Dfinitski/N7DDC-ATU-100-mini-and-extended-boards/3D_Print_Housing/5x5 case ATU-100 for N7DDC.stl

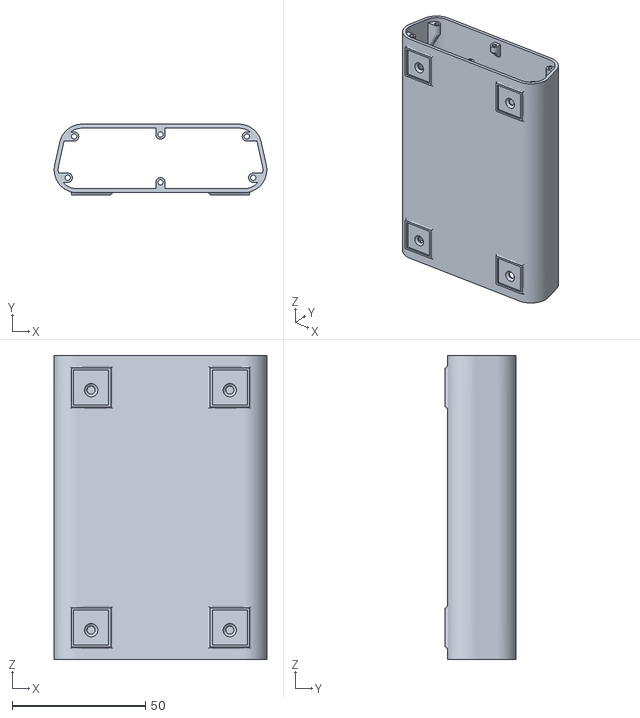
[picture p1: CAD file, 2019-02-02]
3D_Print_Housing/5x5 case ATU-100 for N7DDC.stl
79.7 x 26.5 x 114.0
