Dfinitski/N7DDC-ATU-100-mini-and-extended-boards/3D_Print_Housing/Front panel ATU-100.stl

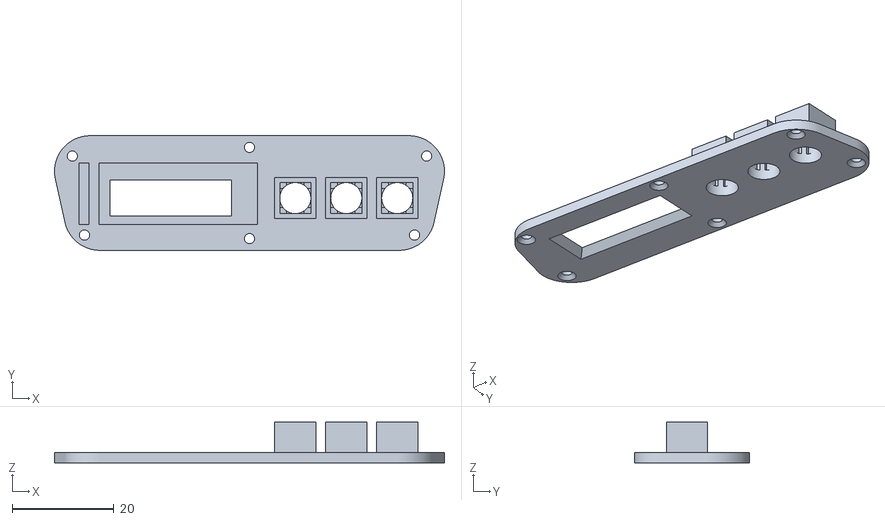
[picture p4: CAD file, 2019-02-02]
3D_Print_Housing/Front panel ATU-100.stl
76.5 x 22.5 x 8.00
