Dfinitski/N7DDC-ATU-100-mini-and-extended-boards/(threads)

Thread 1 (2019-02-18):

Source Code

geekbozu, 2019-02-18:
I see you have a permissive license on the hardware as noted in the documentation, with that I was wondering if the PIC source code be available for this eventually?

Dfinitski, 2019-02-18:
may be in future

Dfinitski, 2019-05-10:
Sources are available now

RichNeese, 2020-02-07:
DO you have a schematic for this board we want to use it on our custom addin board for ubitx . we are looking at the 5x5 as a addin for low power. but we want to put it n a board that mounts under our ubitx pcb

geekbozu, 2020-02-07:
This still has no license applied to it,
Are you intending on releasing these assets under a an OSH/OSS license? Or leaving them licensed to you?

RichNeese, 2020-02-07:
well we  planned on having your call and my call on the board . statung
the atu is based on your board.

------ Original Message ------
From: "Tim Keller" <notifications@github.com>
To: "Dfinitski/N7DDC-ATU-100-mini-and-extended-boards"
<N7DDC-ATU-100-mini-and-extended-boards@noreply.github.com>
Cc: "Richard Neese" <r.neese@gmail.com>; "Comment"
<comment@noreply.github.com>
Sent: 2/7/2020 12:16:33 PM
Subject: Re: [Dfinitski/N7DDC-ATU-100-mini-and-extended-boards] Source
Code (#1)

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

geekbozu, 2020-02-07:
I was askinng dfinitski, We have wanted to make a kit of this for a while but its just not setup in a way where we can legally do so yet. Attribution or not :/

MOUSE1025, 2020-02-07:
Dave,
Do you share the ATU IP with someone?
Christopher

MOUSE1025, 2020-02-07:
Dave,
Do share the ATU intellectual property with someone?
Christopher

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

RichNeese, 2020-02-07:
someone is selling kits from russian based on your board.
https://www.ebay.com/itm/Automatic-Antenna-Tuner-7x7-DIY-KIT-ATU-100-by-N7DDC-PIC-16F1938-flashed/193171458870

------ Original Message ------
From: "Richard Neese" <r.neese@gmail.com>
To: "Dfinitski/N7DDC-ATU-100-mini-and-extended-boards"
<reply@reply.github.com>
Sent: 2/7/2020 1:43:32 PM
Subject: Re[2]: [Dfinitski/N7DDC-ATU-100-mini-and-extended-boards]
Source Code (#1)

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

RichNeese, 2020-02-07:
also just selling boards well over priced ad I know that boards would be
only 1$  a board at pcbway .

https://www.ebay.com/itm/Automatic-Antenna-Tuner-7x7-PCB-ATU-100-mini-by-N7DDC/202706862349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

------ Original Message ------
From: "Richard Neese" <r.neese@gmail.com>
To: "Dfinitski/N7DDC-ATU-100-mini-and-extended-boards"
<reply@reply.github.com>
Sent: 2/7/2020 1:43:32 PM
Subject: Re[2]: [Dfinitski/N7DDC-ATU-100-mini-and-extended-boards]
Source Code (#1)

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

Dfinitski, 2020-02-08:
Hello, people.
This my design like other presented here, go with no any license. It is meaning, that all that info, files, pictures and source code are not protected. Excluding things that I am not the author of and some parts of code, where you can see some license description on the top. That is GNU license requirement - what I have took under GNU, I give under GNU.
So you can do what do you want with this design and I am very surprized that fact you did not read the Uer Manual for this device. The first sentences you can see is highlighted in red  :
**Attention ! There are no restrictions and prohibitions on the use of this material for any purpose, as well as all related materials, the author of which is N7DDC.**

MOUSE1025, 2020-02-08:
Dave,
Thank you for the clarification. I understood the original disclaimer in
the manual, but became confused, with the recent inquiries regarding the
Intellectual Property? I truly appreciate your kind, and generous gesture
regarding the the use of your creation(s).
Kind regards,
Christopher

On Fri, Feb 7, 2020 at 8:26 PM David Fainitski <notifications@github.com>
wrote:

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

Dfinitski, 2020-02-08:
Hello, Chris.
The Intellectual Property is staying mine anyway. It is mining that everyone who use this design or some part of them should to indicate everywhere my name or callsing as the Autor, autor of idea, designer, etc.
If someone decides to appropriate authorship, he will experience social censure.

MOUSE1025, 2020-02-08:
Dave,
That's a wonderful idea, I understand your goal and hope that you get the
credit that you deserve.
Kind regards,
Christopher

On Sat, Feb 8, 2020 at 10:05 AM David Fainitski <notifications@github.com>
wrote:

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

Closed 2020-06-01.

Thread 2 (2019-06-03):

ATU 100 for QRP

S54AM, 2019-06-03:
I have ATU100 extended SMD and works fine. What I miss is setup for QRP needs. Sensitivity for working from 1W to max. 20W. Setup min. power in firmware bellow 05 cause unexpected results as is already described in manual. Is there solution adding extra windings on PWR/SWR core or something else?
Additionally I have issue using OLED 091 because it is not turn on always when I turn power up. In my case every tenth time shows up. I have no experiences using other suggested displays.
Thanks in advance.

73, Marko, S54AM

Dfinitski, 2019-06-04:
Hello.
What exact the unespected result you watch ?

I am using 0.91 OLED with 78 address and 03 type and it works perfectly. I
never heard about this problem before.

David.

S54AM, 2019-06-04:
Hello David,

OLED is blind, nothing on it. After several power ups it works normally. I
have to mention that this is strange for me too. I will send short video
tomorrow.
My addresses are the same 78 and 03 and I have two OLEDs and on both the
same indications.

Marko

V V tor., 4. jun. 2019 ob 02:06 je oseba David Fainitski <
notifications@github.com> napisala:

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

Dfinitski, 2019-06-04:
Hello, Marco

I could not help you with this, sorry.

You should to find a mistake by yourself.

Good idea to try watch what happened with digital oscilloscope on lines CLK
and DAT after start the power.

But i will try ask other user on russian forum about this.

David.

пн, 3 июн. 2019 г. в 17:21, S54AM <notifications@github.com>:

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

Dfinitski, 2019-06-04:
Could you send to me in USA one of this OLEDs ?
Is this not to expensive ?

пн, 3 июн. 2019 г. в 17:21, S54AM <notifications@github.com>:

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

MOUSE1025, 2019-06-04:
Dave,
I enjoyed your exchange with Marco.
CPR

On Mon, Jun 3, 2019 at 5:42 PM David Fainitski <notifications@github.com>
wrote:

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

S54AM, 2019-06-04:
Problem with OLEDs is solved. Google knows everything. Two resistors on OLED 0.91 (R3 and R4) were factory swapped (somewere on far east). I swapped resistors ... and Bingo!
Anyway, important information for those with similar problems as I had. Thanks David for your effort.
More details on: [https://www.youtube.com/watch?v=__3InV5tdzM](url)

Could I ask about my first question?

Marko

Dfinitski, 2019-06-05:
Hllo, Marko
R3, R4, R9 have the same value 4k7.  R1 = 56k.

Concerning your first question, please explain with more details what exact
problem you watch.

вт, 4 июн. 2019 г. в 15:06, S54AM <notifications@github.com>:

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

S54AM, 2019-06-05:
Sorry for confusion. I should be more detailed, because there is dozens of different OLEDs 0.91 with different element numbering on back side. On mine, looking on back side, left is located U2 (3v3 reg), then first row in order C9, D1, R2 and R4. Second row C1, C2, C3, C4, R3, C5, C6 and C7. I swapped R4 and R3 and it works. I can send photo of mine. On QRZ.COM is my address, in reply I can attach photo.

My question is about ATU 100 use for QRP activities. Currently minimal operational power is 5W. What is needed to do to drop minimal synchronisation power to 1W?

Dfinitski, 2019-06-05:
Hello, Marko
If your transmitter has a power around 10 - 20 W you can use all this power
for tuning process.
If 5 W or less, set up in cell 0x05 value 01 - that's meaning that minimum
power for start the process will be from 1 W.
But be sure that the simple output power at least by twice more then
indicated in that cell.
It because in the tune process the output power could be dropped and
process could stop.
Protection system of your tranceiver also could drop the output power when
SWR more then 3.

David

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

S54AM, 2019-06-06:
Thanks David,

As you know, QRP is up to 5W CW and 10W SSB. My RIG is mcHF M0NKA and couple of others small boxes. I am home brewer and my joy is producing this thing into my small lab for my joy. I am amazed with your ATU and your preparedness sharing your intellectual work for free to our HAM community. All respects to you.
I also noticed your ATU project with internal battery and latching relays. This is my big future interest.
Yes, everything is clear for me about settings (1W). But, I am just thinking to get more voltage with more secondary  wingdings on PWR/SWR core for small power transmitters. For sure firmware changes are needed in this case to get real data on display. My suggestion is, If this is not too complicated for you, that QRP version of your ATU using latch relays could rise interest in QRP community. I will follow your smart products.
Sorry for delayed answer. The biggest challenge for me is free time especially at summer.
Again, compliments and all respects.

Marko

MOUSE1025, 2019-06-06:
Dave,
Where are you purchasing the 2512 50 ohm resistor? I have tried Mouser and
Digikey, no luck. I thought I would see where you are getting yours before
I ventured out to Newark and the others?
CPR

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

S54AM, 2019-06-06:
Mouse1025,
Nearest standardised EIA value for resistors is 49.9 ohm (E96). I am using two 100 ohm in paralel to reach exactly 50 ohm.

Marko

Dfinitski, 2019-06-07:
Yes, 50 Ohm exactly does not exist or very expensive. Use 49.9 as is. Don't
need to add anything.

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

MOUSE1025, 2019-06-07:
Dave,
I found one:
CPR[image: image.png]

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

MOUSE1025, 2019-06-07:
What am I going to need if I want to program my ATU? I assume that the
processor can be programmed right on the ATU board. What hardware will I
need to interface between my computer and the ATU. Will I need an IDE
program and compiler?
CPR

On Thu, Jun 6, 2019 at 5:50 PM Christopher Ryan <
tactical.radio.gear@gmail.com> wrote:

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

Dfinitski, 2019-06-07:
For programm MCU you will need two things:
!)
https://www.ebay.com/itm/PICKit3-Microchip-Programmer-w-USB-cable-wires-Pic-Kit-3/331941067077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

2) https://drive.google.com/open?id=12m2qaR-5bgMg4IJChc4-YXJ7Y6bKInuW

чт, 6 июн. 2019 г. в 20:05, MOUSE1025 <notifications@github.com>:

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

MOUSE1025, 2019-06-07:
Dave,
I am winding up the inductors, in advance of the PCB showing up tomorrow.
The T1/T2 calls out a 1:10 ratio, but gives no turns for the wire?
CPR

On Thu, Jun 6, 2019 at 8:05 PM Christopher Ryan <
tactical.radio.gear@gmail.com> wrote:

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
>>> Mouse1025,
>>> Nearest standardised EIA value for resistors is 49.9 ohm (E96). I am
>>> using two 100 ohm in paralel to reach exactly 50 ohm.
>>>
>>> Marko
>>>
>>> —
>>> You are receiving this because you commented.
>>> Reply to this email directly, view it on GitHub
>>> <https://github.com/Dfinitski/N7DDC-ATU-100-mini-and-extended-boards/issues/2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>,
>>> or mute the thread
>>> <https://github.com/notifications/unsubscribe-auth/ALPPXBZ54D2OUBPUGQ6HABLPZGNZXANCNFSM4HSUIQ6A>
>>> .
>>>
>>

MOUSE1025, 2019-06-07:
Dave,
Thanks for the info on the programmer. I have one on order. I should of
asked about this sooner.
CPR

On Thu, Jun 6, 2019 at 8:11 PM Christopher Ryan <
tactical.radio.gear@gmail.com> wrote:

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
>>> Dave,
>>> I found one:
>>> CPR[image: image.png]
>>>
>>> On Thu, Jun 6, 2019 at 4:39 PM S54AM <notifications@github.com> wrote:
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

Dfinitski, 2019-06-07:
It is 10 turns, 1 to 10, right

чт, 6 июн. 2019 г. в 20:12, MOUSE1025 <notifications@github.com>:

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

MOUSE1025, 2019-06-07:
Dave,
I thought that was the case, I wanted to make sure that I was not mistaken.
Thanks...
CPR

On Thu, Jun 6, 2019 at 9:01 PM David Fainitski <notifications@github.com>
wrote:

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

Dfinitski, 2019-06-08:
Hello, Marko.
Expectually for you - fw version 3.0 where you can to indicate any turn ratio of tandem match.
You can use 1 to 5 ratio to increase voltage on the diodes.
But be noticed that in this case 1/5 of power your TRX will be dissipated on the tandem-match 50 Ohm resistors.

Dfinitski, 2019-06-09:
Hello, Marko.
Sorry for this mistake. Only 0.2 W will be dessipated on 5 W, not 1/5.

S54AM, 2019-06-10:
Hello David,

Thanks for new firmware and suggestion about T1(1:5) for QRP. I will do
this in next days.
You can expect my reply.

Marko

V ned., 9. jun. 2019 17:00 je oseba David Fainitski <
notifications@github.com> napisala:

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

S54AM, 2019-06-10:
Hello David,

Your V.3 firmware is working well from 1W using settings bellow and modified T1 (1:5).

00 | 78 | 03 | 01 | 15 | 13 | 01 | 00 | 01 | 02 | 00 | 07 | 00 | 07 | 00 | 01 | 00
10 | 00 | 50 | 01 | 00 | 02 | 20 | 04 | 50 | 10 | 00 | 22 | 00 | 44 | 00 | FF | FF
20 | 00 | 10 | 00 | 22 | 00 | 47 | 01 | 00 | 02 | 20 | 04 | 70 | 10 | 00 | FF | FF
30 | 00 | 05 | 00 | 01 | 12 | FF | FF | FF | FF | FF | FF | FF | FF | FF | FF | FF

After several tests I have noticed that, if cell 06 is set to 04 (upper power limit for 40W) instead of default 00, then OLED after SWR sometimes become frozen with word TUNE, not showing SWR numerical value. If I leave it as default, then ATU works normally. Maybe I set something wrong.

Marko

Dfinitski, 2019-06-11:
Hello, Marko

Probably manua is not clear enough. When you have set 04, upper power limit
will be 4W in simple mode and 40 W in High Power Messurement mode (cell 30).

ATU is not freesing, it is waiting for when your power will
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

Thread 4 (2019-12-24):

Programming with Pickit2

victorkoren, 2019-12-24:
I am trying to program the ATU-100 with Pickit-2 but it shows "no device detected".
I set the device manually and it detects that the device has external Vdd, but does not detect the PIC.
Is there a problem using Pickit-2?
Victor - 4Z4ME

Dfinitski, 2019-12-24:
Hello, Victor.
As I know, Pickit 2 does not support PIC16F1938. You have to swap .dll file from Pickit 3 programm or change your programmer to Pickkit 3. After that you should select manually Device Family -> Midrange -> 1.8V min
Because this family uses other Vpp voltage then others.

victorkoren, 2019-12-24:
Hi,
Thanks for the prompt answer, however that is strange because in the Pickit 2 app I can choose the PIC 16F1938 manually, so the option to choose it is there but it is not supported?
Victor - 4Z4ME

Dfinitski, 2019-12-24:
I am sorry, 1938 is supported, proof
http://ww1.microchip.com/downloads/en/devicedoc/pickit%202%20readme%20v2-61-00%20(a).txt
Please give more info what is happening when you are trying to programm it.

victorkoren, 2019-12-24:
I found a readme DOC from microchip that states that 16F1938 is supported:
http://ww1.microchip.com/downloads/en/devicedoc/pickit%202%20readme%20v2-61-00%20(a).txt
So why doesn't it work?
I saw that other people had this problem.
Victor - 4Z4ME

victorkoren, 2019-12-24:
We posted together the same file...
Anyway I saw that also other people had this problem and didn't solve it.
Tomorrow I will post a screen picture.
Victor = 4Z4ME

victorkoren, 2019-12-24:
It seems that there is a newer DAT file that updates the devices that PICKIT 2 supports. I'll check that tomorrow.

Dfinitski, 2019-12-24:
Looks like that. Let's go !

victorkoren, 2019-12-24:
I updated the data file and it worked !
Just wanted to configure the ATU to work in automatic state.
Thanks for help.
Victor - 4Z4ME

Dumper88, 2020-11-29:
Hi is it possible to have a link to download PK2DeviceFile the most updated? thanks

Dfinitski, 2020-12-01:
Hi. You can find it here https://drive.google.com/file/d/18wiH5RjL5R8ku7a9MQ4Hxx9SmUZInpvj/view?usp=sharing

Closed 2019-12-24.

Thread 5 (2020-04-24):

T1/T2

IAceVenturaIcz, 2020-04-24:
Hello,

may I know how many turns are on T1/T2 please ?
Thank you

2M0LWS, 2020-04-25:
I have done 5 turns on each side. Suitable for 5w minimum power.

Dfinitski, 2020-04-25:
*T1, T2 - TANDEM MATCH, BN43-202 AMIDON CORE* *1:10*
In latest firmware for extended board this ratio might be what you want,
from 5 to 30 typically dependet to desired maximum power.
The limiting criterion is the maximum voltage on analog inputs PIC.
For 1939 it can not to excide 4.096  Volts, for 2520 5Volt with maximum
input power.
For standart 100W it is 1/10 Turns, for QRP below 50W 1/5 Turns preferred.
Voltage on ADC = SQR(2) * Vrf_in / Ratio / 3

пт, 24 апр. 2020 г. в 01:59, IAceVenturaIcz <notifications@github.com>:

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

IAceVenturaIcz, 2020-04-27:
thank you all for replay. Not sure about how that works. I need 1/10 as been mention, as I will use 100W . What I am nor sure how to wired this toroid. I bit confused as I need to get 4 wires out. Is there any picture how to do it please ?

Dfinitski, 2020-04-27:
The picture on the schematic. Try "tandem match" in the Google Search for
more info.

On Mon, Apr 27, 2020, 5:05 AM IAceVenturaIcz <notifications@github.com>
wrote:

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

IAceVenturaIcz, 2020-04-27:
Thank you David, sorted for now...

Closed 2020-04-27.

Thread 6 (2020-04-25):

Capacitor Values for B1 B2

2M0LWS, 2020-04-25:
What are the values of the two smaller capacitors connected to the 0.1u capacitors in the attached image?

Any advice is greatly appreciated.

73s 2M0LWS

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

Dfinitski, 2020-04-25:
Hi
Those are 2 blocking 0.1uF capacitors for additional buttons.

сб, 25 апр. 2020 г. в 11:46, 2M0LWS <notifications@github.com>:

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

2M0LWS, 2020-04-25:
Many thanks for the quick reply. 73's, 2M0LWS

Closed 2020-04-25.

Thread 7 (2020-06-01):

Automatic Antenna Tuner 7x7 (ATU-100 by N7DDC) Query

k2db, 2020-06-01:
I am a newbie here, looks like fun ,I love kit building, doing it since early 60's,
I just ordered FULL KIT DIY Automatic Antenna Tuner 7x7 (ATU-100 by N7DDC), what files do i need to construct the kit, do i need anything extra like a display, etc, and where do i go to get the info?
Paul K2DB

Dfinitski, 2020-06-01:
Hello, Paul.
This project is fully opened so you can find all the files here on GitHub.
I recommend you to read User Manual firstly.
The schematic would be helpful also.
If you do assembly with no errors, this device will work immediately with
any questions .

David, N7DDC

пн, 1 июн. 2020 г. в 06:28, Paul Mackanos <notifications@github.com>:

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

k2db, 2020-06-01:
thank you, what files do i download ?

Dfinitski, 2020-06-01:
Hi, Paul. Everything you need you can find here
 https://github.com/Dfinitski/N7DDC-ATU-100-mini-and-extended-boards/tree/master/ATU_100_EXT_board

k2db, 2020-06-16:
David, I don't have Microsoft Word, so I can't open the instructions. Is
there any way I can ask you to send me all the info in PDF format?
Building instructions, operation manual, etc.
Still waiting for the kit to be delivered, thought I might get a jump on
what is coming for me, and anything I will need that is extra.
Thanks,
Paul K2DB

On Mon, Jun 1, 2020 at 5:53 PM David Fainitski <notifications@github.com>
wrote:

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

Dfinitski, 2020-06-16:
Hello, Paul.
The manual in pdf is present here. Did you try the link in my previous message ?
Everything you need you can find on the schematic and BOM list.
To open odt files use a free software like Open Office.

Celta1960, 2021-02-18:
Hola amigos, tengo un problema con el atu-100 ver 3.0 el cual funcionar funciona perfectamente pero una en ciertas frecuencias es imposible ponerlo ya que me marca una señal fuerte hasta el punto de no poderlo utilizar, esto ocurre en todas las bandas.
       Adjunto dos fotos con el puesto y quitado, A que es debido?.
   Un saludo
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

Dfinitski, 2021-02-18:
Hello, Celta1960

**New in the version 3.2
Fixed bug with continuous data transfer to the display.**

So use 3.2 version of firmware.

To check this out, disconnect the display and try without it.

Dfinitski, 2022-08-08:
Hi.
The most likely it uses complicated data exchange via CAT

Dfinitski, 2022-08-08:
But you can try to find native Start and Key signals on your rig.

Plasmastorm73, 2022-08-14:
Are there any step by step build instructions for this kit?

Dfinitski, 2022-08-15:
Hi.
Yes.
1) install all components to the board
2) power on it
3) use it

Plasmastorm73, 2022-08-15:
You know. People like you are causing beginners to give up with your
rudeness. You could have simply said you were too lazy to make a step by
step guide but instead you have to be a jerk.

On Sun, Aug 14, 2022 at 8:00 PM David Fainitski ***@***.***>
wrote:

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

paul-jewell, 2022-08-15:
> You know. People like you are causing beginners to give up with your rudeness. You could have simply said you were too lazy to make a step by step guide but instead you have to be a jerk.

David has put an inordinate amount of time and effort to make his designs effective and available. As far as I am aware, he doesn't make any money out of the sale of the different kits available from Aliexpress, Banggood, eBay etc, and no doubt has to devote a significant amount of his personal time and effort to supporting people who ask him questions which could already be answered with a bit of googling. He doesn't owe anyone anything - we all have a debt of gratitude to him.

It is a straight forward assembly, and within the skills of anyone familiar with building kits. The tuners are also available fully built for those who don't wish to wield a soldering iron.

I don't think David was being rude - he was simply being to the point. If you don't have the confidence to build a kit, then buy a complete item - they are still amazing value compared with the competition.

nanko55, 2022-08-15:
Agree.

I’ve build at least three of them, without problems, they all work very well!
For the beginners: take a look at github, Google, AliExpress for tips and schematics, thats how real radio amateurs do it 😉
If you don’t like or want to do this, purchase an ATU from ICOM or MFG.
I think David did an outstanding job👍

Regards, Nanko van Dijk, PA0NVY

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

Plasmastorm73, 2022-08-15:
Dear Paul. This wasn't for me. I asked a simple question and he was snotty
about the answer. PERIOD! A simple no there isn't would have been straight
forward. I was looking into this kit for a 12 year old kid I am teaching.
Maybe you should mind your own business and leave the conversation to the
adults. I've been building Oscilloscopes for a MAJOR brand for over 30
years and also teach soldering and electronics building classes. Some
people who just assume the facts like you are the real problem.

On Mon, Aug 15, 2022 at 3:46 AM Paul Jewell ***@***.***>
wrote:

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

paul-jewell, 2022-08-15:
Hi William,

I understand it wasn't for you - I could see from your QRZ page that you
have many years of electronics experience and don't need instructions.

In my opinion, Dave was succinct and to the point. What else could he
have said?

If you look at the other comments above yours, you will see that even
when he takes to respond, people don't always pay attention to what he
says. /Comments like yours/ will ultimately drive creative people like
Dave away - he doesn't have to share anything, or do anything for anyone
else. *He owes us nothing, and we should be eternally grateful for his
generosity!*

I have seen a number of people who make the product of their hard work
available for free to others, and then get lambasted for it. In some
cases, this has led to them withdrawing their information and support,
to the detriment of the community.

If you think there should be instructions, then create some and make a
pull request so they can be added to the github repository. Dave doesn't
need instructions for himself, so why should he write any?

I have nothing more to say about this, as I doubt I can change your
views, and it's not constructive.

Best regards,
Paul

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

Plasmastorm73, 2022-08-15:
You completely miss my point. I don't give a damn if there are or aren't
any instructions. MY point was the asshole way he said no there weren't
any. "Dave was succinct and to the point" was total bullshit. He was being
a snarky asshole instead of just saying no there aren't any. I neither
found it amusing nor helpful.

Anyway. You are correct that you won't change my mind on this. I didn't get
my panties in a twist over there being no instructions like you are
implying. I got angry at his attitude and asshole reply.

On Mon, Aug 15, 2022 at 8:24 AM Paul Jewell ***@***.***>
wrote:

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

MOUSE1025, 2022-08-15:
No good deed goes unpunished!
Great work Dave.
Kind regards,
Christopher

On Mon, Aug 15, 2022 at 6:22 AM Plasmastorm73 ***@***.***>
wrote:

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

davidhay45, 2022-08-15:
@Plasmastorm73 you have demonstrated to all reading this thread that YOU are the jerk around here.  David N7DDC has done a wonderful job in designing these ATU's and release all of the information to the world at large and does not deserve criticism from pathetic idiots like you.

Dfinitski, 2022-08-15:
That's a good lesson for me. Stupid questions SHOULD be ignored.

Plasmastorm73, 2022-10-11:
I have no issue with the kit, nor the amount of time he put into it. I have
issue with people giving snotty answers when it isn't called for. PERIOD!

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

Thread 8 (2020-06-09):

Tandem match T1   T2

morseoneuk, 2020-06-09:
Is wire gauge critical?  10:1   ok,   but what wire diameter?

Dfinitski, 2020-06-09:
AWG 32 in PTFE silver core works perfect.

вт, 9 июн. 2020 г. в 00:56, morseoneuk <notifications@github.com>:

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

morseoneuk, 2020-06-09:
Hi David, many thanks for the info..  that is  just what I needed to know.best regards   Scotty
    On Tuesday, 9 June 2020, 18:46:56 BST, David Fainitski <notifications@github.com> wrote:

AWG 32 in PTFE silver core works perfect.

вт, 9 июн. 2020 г. в 00:56, morseoneuk <notifications@github.com>:

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

—
You are receiving this because you authored the thread.
Reply to this email directly, view it on GitHub, or unsubscribe.

fedemartini, 2020-07-15:
Sorry for the dumb question, but I wasn’t able to find anywhere the data on T1/T2. 1:10 ok, but how many turns?
Many thanks

Dfinitski, 2020-07-15:
Hello. Ask Google "tandem match" and you will find everything you need,  with pictures.
How many turns for 1:10 tandem ? 1 and 10 turns of course.

stefan75dc4, 2020-08-26:
Hello David,
i buyed the Tuner on ebay, but the 100 Watt - Version (7x7 Elements).
Can I make a 1000 W Tuner with this PCB or I need another PCB-Board.
How much Turns i need for the tandem match? 1:10 or a other worth?
Sorry for this question, but this is my first greater Kit for Amateurradio.
I must collect further experience.
Thanks in forward.
Vy 73 de DC4KJS (Stefan)

Dfinitski, 2020-08-27:
Hello, Stefan
You can find info about 1kw tuner here, use google translate . Boards are present on the Ebay. http://www.cqham.ru/forum/showthread.php?38456-ATU-N7DDC-%E2%E5%F0%F1%E8%FF-1Kw-%EE%F2-EU2AV

Dfinitski, 2020-09-14:
Stefan, 1kW tuner here
https://www.youtube.com/watch?v=RaizIevy-BI

stefan75dc4, 2020-09-14:
Hello David,

Thank You for the Link.

Vy 73 de and best wishes

Stefan Dc4kjs

Holen Sie sich Outlook für Android

Von: David Fainitski <notifications@github.com>Gesendet: Montag, 14. September 2020, 03:20An: Dfinitski/N7DDC-ATU-100-mini-and-extended-boardsCc: Stefan; CommentBetreff: Re: [Dfinitski/N7DDC-ATU-100-mini-and-extended-boards] Tandem match T1   T2 (#8)
Stefan, 1kW tuner here
https://www.youtube.com/watch?v=RaizIevy-BI

—You are receiving this because you commented.Reply to this email directly, view it on GitHub, or unsubscribe.

Thread 9 (2020-06-21):

Blown capacitor C27 or C26

MartinDavidWaller, 2020-06-21:
Hi,

I've recently built one of the kits and it's all been going well until today. I am driving it from a KX3 with 10w output and found that the tuning could hang if the power went below 5, possibly due to the KX3 reducing power out to protect itself. To resolve this I've change the EEPROM address 5 from 5 to 1 and it seemed to be much happier.

I was using it to tune an antenna on 24Mhz and was half way through a CW QSO when the fuse on my power supplt blew and the shack filled with 'an interetsing smell'! On investigation then only damage seems to be C27 or C26 that has blown. The ATU still works, I can enter test mode and cycle through the L and C values.

Any advice or replacing the cap would be appreciated, do I need a better rated cap?

Many thanks for any advice you can give.

Martin
G0PJO

Dfinitski, 2020-06-21:
Hello, Martin.
Thank you for sharing that.
Yeah, this is very wierd to see blown DC current capacitors (???!!!).
I don't see any other reason to do that except all of them were very low quality or were rated for low voltage, 5-6 Volts.
Just change them to 25-50 Volts rated .

MartinDavidWaller, 2020-06-22:
Hi David,

Many thanks for the reply. Yes, very odd, I'll order some and replace them. Many thanks for the help.

Martin

MartinDavidWaller, 2020-08-27:
Hi David,

Sorry for not getting back to you on this. I replaced the capacitor and it has worked like a dream ever since! Many thanks.

Martin

Closed 2020-08-27.

Thread 10 (2020-06-29):

Manual control

pa3hea, 2020-06-29:
Hello,
I build the tuner and it works reasonably well.
It happens on a regular base that he mis the lowest swr.
Is there a posibility to control the capacitors and the coils manualy to fine tune the swr.
Grts
Pa3hea

Dfinitski, 2020-06-30:
Hello.
You can use the manual mode , (Bypass + Auto + Power On), to find the best LC combination but there is no this future in working mode.
Try to encrease Relay delay time, it would be helpful.

pa3hea, 2020-06-30:
Tnx for your answer, can you tell me how to change that.
Do I need to reprogram the pic for that.

Tnx

Bart (pa3hea)

Dfinitski, 2020-07-01:
Yes, read the manual, cell's description.
But I have better idea. Add 1-3 meters of cable to your RF antenna fider  (after ATU)  and try again.

pa3hea, 2020-07-01:
Hello David,Tnx for your attention.I understand what you mean with that.Its not realy a big issue when make a mistake because it is simple to correct when it happens.I am very satisfied with it.It does his job verry well.Well done david my compliments.If you dont mind I want to write a little peace about in a technical digital magazine here in holland called "razzies" about my findings and building experience.Most of the radio amateurs of the local clubstation PI4RAZ write peaces about several kinds of projects they develop and build.Every month there is a edition that we spread all over the world in 2 languagesThe author of this magazine is Frank PA3CNO.Can you let me know if you find this a problem or not.TnxBart (PA3HEA)Verzonden vanaf mijn Samsung Galaxy-smartphone.<!-- originalMessage --><div>-------- Oorspronkelijk bericht --------</div><div>Van: David Fainitski <notifications@github.com> </div><div>Datum: 01-07-2020  22:15  (GMT+01:00) </div><div>Aan: Dfinitski/N7DDC-ATU-100-mini-and-extended-boards <N7DDC-ATU-100-mini-and-extended-boards@noreply.github.com> </div><div>Cc: pa3hea <bart@bwautomatisering.nl>, Author <author@noreply.github.com> </div><div>Onderwerp: Re: [Dfinitski/N7DDC-ATU-100-mini-and-extended-boards] Manual control (#10) </div>Yes, read the manual, cell's description.
But I have better idea. Add 1-3 meters of cable to your RF antenna fider  (after ATU)  and try again.

--
You are receiving this because you authored the thread.
Reply to this email directly or view it on GitHub:
https://github.com/Dfinitski/N7DDC-ATU-100-mini-and-extended-boards/issues/10#issuecomment-652624325

BW automatiseringWillem Dreeslaan 2452729 NE ZoetermeerT) +31 798 200 240F) +31 78 200 241info@bwautomatisering.nlwww.bwautomatisering.nl
Op al onze producten en diensten gelden onze algemene voorwaarden voor B2B en consument zoals vermeld op de website.

Dfinitski, 2020-07-01:
Hello, Bart.
There are no any problem to use this project information for any purpose.

pa3hea, 2020-07-01:
I have a stuppid brainfart, would it be  possible to convert the software for the pic controller to arduino and replace the pic by a arduino.Because arduino is verry populare ad the moment here.Dont understand me wrong its just a brainfart and I dont know how to do it.Just curious if this is possible.TnxBart (PA3HEA)Verzonden vanaf mijn Samsung Galaxy-smartphone.<!-- originalMessage --><div>-------- Oorspronkelijk bericht --------</div><div>Van: David Fainitski <notifications@github.com> </div><div>Datum: 01-07-2020  22:52  (GMT+01:00) </div><div>Aan: Dfinitski/N7DDC-ATU-100-mini-and-extended-boards <N7DDC-ATU-100-mini-and-extended-boards@noreply.github.com> </div><div>Cc: pa3hea <bart@bwautomatisering.nl>, Author <author@noreply.github.com> </div><div>Onderwerp: Re: [Dfinitski/N7DDC-ATU-100-mini-and-extended-boards] Manual control (#10) </div>Hello, Bart.
There are no any problem to use this project information for any purpose.

--
You are receiving this because you authored the thread.
Reply to this email directly or view it on GitHub:
https://github.com/Dfinitski/N7DDC-ATU-100-mini-and-extended-boards/issues/10#issuecomment-652640271

BW automatiseringWillem Dreeslaan 2452729 NE ZoetermeerT) +31 798 200 240F) +31 78 200 241info@bwautomatisering.nlwww.bwautomatisering.nl
Op al onze producten en diensten gelden onze algemene voorwaarden voor B2B en consument zoals vermeld op de website.

Dfinitski, 2020-07-01:
PIC controllers are very popular in the world and have low price. You should to be a crazy Arduino's fan to get hours brainstorm to convert the code. But I think it is not a big problem.

DIETMAR4, 2020-08-03:
Hello !
I built the ATU 100 7x7. It works very well. Now I have a question. If I want work with my power amplifier (1 kw PEP) I shurely have to switch off the ATU 100. But how can I do this without removing of the PL259 Plugs ? Thanks for your answer !
Dietmar4 (DK8TT)

Dfinitski, 2020-08-03:
Hello.
Use Bypass mode or power off the tuner board.

DIETMAR4, 2020-08-03:
Hello dear David,
thank you very much for your quick answer. May I ask back, if I switch off the power of the tuner, the power of the PA (1kW) really cannot destroy the tuner ?  Then I have a second question to Bypass: If I make a contact (switch) from RP1 to ground. Which function has this step ?
Thank you very much for your answer.
Vy 73
Dietmar (DK8TT)

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

pa3hea, 2020-08-03:
Maybe stupid question but why do you want to put 1kw through the small 100 watt tuner.Verzonden vanaf mijn Samsung Galaxy-smartphone.<!-- originalMessage --><div>-------- Oorspronkelijk bericht --------</div><div>Van: DIETMAR4 <notifications@github.com> </div><div>Datum: 03-08-2020  22:55  (GMT+01:00) </div><div>Aan: Dfinitski/N7DDC-ATU-100-mini-and-extended-boards <N7DDC-ATU-100-mini-and-extended-boards@noreply.github.com> </div><div>Cc: pa3hea <bart@bwautomatisering.nl>, Author <author@noreply.github.com> </div><div>Onderwerp: Re: [Dfinitski/N7DDC-ATU-100-mini-and-extended-boards] Manual control (#10) </div>Hello dear David,

thank you very much for your quick answer. May I ask back, if I switch off the power of the tuner, the power of the PA (1kW) really cannot destroy the tuner ?  Then I have a second question to Bypass: If I make a contact (switch) from RP1 to ground. Which function has this step ?

Thank you very much for your answer.

Vy 73

Dietmar (DK8TT)

Von: David Fainitski

Gesendet: Montag, 3. August 2020 22:14

An: Dfinitski/N7DDC-ATU-100-mini-and-extended-boards

Cc: DIETMAR4; Comment

Betreff: Re: [Dfinitski/N7DDC-ATU-100-mini-and-extended-boards] Manual control (#10)

Hello.

Use Bypass mode or power off the tuner board.

—

You are receiving this because you commented.

Reply to this email directly, view it on GitHub, or unsubscribe.

--

You are receiving this because you authored the thread.

Reply to this email directly or view it on GitHub:

https://github.com/Dfinitski/N7DDC-ATU-100-mini-and-extended-boards/issues/10#issuecomment-668236511

BW automatiseringWillem Dreeslaan 2452729 NE ZoetermeerT) +31 798 200 240F) +31 78 200 241info@bwautomatisering.nlwww.bwautomatisering.nl
Op al onze producten en diensten gelden onze algemene voorwaarden voor B2B en consument zoals vermeld op de website.

Dfinitski, 2020-08-03:
Hello.
No, you can not to put 1kW thought the tuner board.
The tuner board should be connected between your 100W rig and 1kW PA. An antenna is connected to PA output. When you don't use a PA, it is bypassed (usually, should be). When you use a PA - Bypass the tuner board.

Dfinitski, 2020-08-03:
There are two additional buttons - Auto and  Bypass.

DIETMAR4, 2020-08-04:
Dear David,
thank you very much for your precious answer. Now I changed the position of the tuner between the rig and the PA. - I don’t have the button Auto und Bypass. I only use the button Tune. Can you tell me please, how I can install the Buttons Auto and Bypass. Have I to connect a switch between point RB1 and ground and Point RB2 and Ground ? And what are the functions of these two buttons ? Thank you very much for your patience to my stupid questions.
Vy73
Dietmar (DK8TT)

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

Dfinitski, 2020-08-04:
Hello.
You can use a reset tuner instead Bypass. A Bypass mode allows you to return to LC settings anytime, unlike a reset.
Yes, just connect the additional buttons to ports and ground. Install 0.1uF caps over there also.
You can read about additional buttons in the user manual. You can see how to connect additional buttons on the schematic.

DIETMAR4, 2020-08-04:
Dear David,
thank you very much for explaining of the two buttons and its installing. Today I talked to an OM from southern Germany. He also wants to build your ATU-100.
Now I thank you very much for your kindness help. I wish you all best and much health !
Vy 73
Dietmar (DK8TT)

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

DIETMAR4, 2020-08-15:
Dear David,
I have another question. I see, that the swr-value of ATU-100 often is different from the value of my swr-meter. It is connected behind the atu-100. How can it be ?
Thank you very much for your answer.
Many 73
Dietmar

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

Dfinitski, 2020-08-15:
Hello, Dietmar
The lines in the tuner board have a parasitic inductance, relays -
parasitic capacitance, so nothing weird if you see different SWR values in
that heterogeneous transmission line.
Connect your SWR meter before the tuner as close as it's possible to see
more valuable values.

сб, 15 авг. 2020 г. в 05:31, DIETMAR4 <notifications@github.com>:

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

DIETMAR4, 2020-08-15:
Dear David,
thank you very much for your excellent advice. Now I changed the position of the SWR-Meter and can see, that the different SWR-values are much closer !
I wish you a beautiful Sunday tomorrow und much health.
My best 73 to you
Dietmar

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

Closed 2020-08-27.

Thread 11 (2020-07-22):

Under rated capacitors C7 1n, C6 470pf, C7 220pf

pa3hea, 2020-07-22:
Hello david,

I notished that c5 c6 and c7 are under rated.
On the lower bands like 80m band
They get verry hot in a view seconds when you use 100 watt. And the swr is moving when that happens.
I replaced them with high Q low ESR  500v types from johanson.
The capacitor kit P/N from Johansons is S111DUE.
This capacitors solve the problem.
The capacitors witch are included in the kit are most likely 50v capacitors i ques if I look to the size of the capacitors.
If everybody get this capacitors then you get a lot of complains I think.

Grts

PA3HEA

Dfinitski, 2020-07-23:
Hello.
ATC800 is the best solution in this case, but expensive.
If you use simple 1206 capacitors, choose them with 1kV and higher rating with white or rose ceramic. Don't use brown or grey ones.
C5, C6, C7  must be composed with lower values caps, not more then 220p, because bigger values used bad dielectric usually.
NP0 dielectric must be used in all C1 - C7 capacitors.

pa3hea, 2020-07-23:
I replaced them with the same type you advice 2828.
That works fine.
But you advice also not to use brown capacitors, all capacitors c1-c7 are brown in the kit and 1206 so i'm not sure if that is what you advice in this.

Grts

Bart (Pa3hea)

Dfinitski, 2020-07-23:
Hello.
I am designer of this project, I am not a seller of kits . All my
suggestion you can read in my previous post.
Please ask seller of your kit if you have some problems with that .

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

Closed 2020-08-27.

Thread 12 (2020-08-10):

Compile the project with a free IDE?

khkremer, 2020-08-10:
I don't have any experience with development for PIC processors, so please excuse my ignorance regarding development environments. I have successfully used the MPLAB X IPE to program the hex file into the chip, but now I'd like to play around with the source code. I tried to load the project into MPLAB X IDE, but it does not recognize the project folder as a valid project. That prompted me to poke around in the project configuration files, and it looks like you are using MicroC, which is a bit on the expensive side for just playing with one project. Do you have any suggestions for getting this to compile using a free system?

Thanks,
Karl Heinz - K5KHK

Dfinitski, 2020-08-10:
Hello, Karl
Of course you can create the new project in MPLAB IDE, copy all .c and .h files to it and try to compile.
You will need to change native MicroC libraries like ADC conversion, Types Conversion , EEPROM and probably something else, I don't remember.
I2C is not a library, it is software realization.
Use a free demo version of MicroC to obtain info about PIC configuration, library description, etc.

sparkey2450, 2020-11-28:
You guys are kind of throwing me here. You mentioned MicroC but I found MikroC. Is the second one correct? I like what I see with this tuner. What I'd like to do is set it up so I can access the parameters from the shack via WiFi with the tuner Mtd at the antenna. Been a while since I did any programming so this will be a big learning curve.

Dfinitski, 2020-12-01:
Hi, Steve.
Yes, you are right, MikroC is correct name.
It would be interesting to do something on ESP32 Arduino board.

rogerclarkmelbourne, 2020-12-01:
The EPS32 is a great device, but be aware that when the WiFi it enabled it takes loads of current. Hundreds of mA, like all Wifi devices do.

You'd also need to check the accuracy of the ADC on the ESP32. It may be OK, but it possibly may be worse than the PIC.

I'm also not sure how hardened the Wifi Rx is on the ESP32 and how well it would react to 100W passing by in close proximity, and conceivably it could actually damage the Rx.

sparkey2450, 2020-12-01:
Ok thanks for the info. You can email me direct if you look up my QRZ page for W8TTY I've got a few ideas. Been a little bit of a trip down memory lane for me. I haven't done any real programming since I retired back in 2004. My current project is a Mag Loop. Another subject. I have some ideas and for real quick I see two boards.  Your design mated to an Arduino or Raspberry Pi. Most likely going to take some case design and shielding. All the commercial Auto Tuners are designed to sit on a desk. The other ones that are at the antenna lack any kind of real interface. I have both compilers loaded and got sticker shock when I looked at the price of the optimizing compiler from MPLAB. The one you are using is reasonable for hobby use. The Free MPLAB Compiler when I loaded the project and ran it had lots of ????? Warning Warning Will Robinson. That is most likely Operator error. I got the other one to run just fine but since its a demo it will not build the executable because of size. Anyway this will be a fun project. Still getting this old Unix, Microsoft C Programmer back on his feet. Thanks for a great job on the design. I'm not one to re-invent wheels so the reason I was looking at the Raspberry PI is all that VNC and WIFI stuff is there and waiting to be used.  I have a ATU-100 box coming this Friday. Supposedly wired by you. Have a great day. As for powering this thing I'll be looking at Solar and batteries.  Nice job again on the design.

Dfinitski, 2020-12-01:
Steve, I don't want to do something else on this project. This tuner was created as a "black box" under antenna and I have add the display only for debugging data output. but people asked me add something else more and more, so as result you can see what we have. On my personal opinion, this tuner should be "blind", next to antenna in full automatic mode.
All the info what I need I can see on my transciever's display.
It would be interesting for me how far the human mind can go in perfecting a simple thing.

sparkey2450, 2020-12-01:
> Steve, I don't want to do something else on this project. This tuner was created as a "black box" under antenna and I have add the display only for debugging data output. but people asked me add something else more and more, so as result you can see what we have. On my personal opinion, this tuner should be "blind", next to antenna in full automatic mode.
> All the info what I need I can see on my transciever's display.
> It would be interesting for me how far the human mind can go in perfecting a simple thing.

Ok, Thanks for a great piece of equipment. I appreciate the work you have done. It is very well designed. I take a little different approach. I like to know exactly what going on at the end of the coax. Thanks again for all your hard work.

Steve W8TTY

sparkey2450, 2020-12-04:
David,  are you willing to answer a few questions about the code as I read through it? If not then that's fine. I'm like anyone else. I can get lazy and look for the shortest path. So far so good on the code. I'm looking at Firmware 3.1. Unless you suggest one of the others. Thanks
Steve

Dfinitski, 2020-12-04:
Hi Steve.
I am open  for questions.

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

sparkey2450, 2020-12-04:
Thanks David. I got the box today and tried it out from the shack worked well. It only has the Tune Button. It tunes quickly. Yes, I've already had the top off. Version 3.0 Firmware is installed. I was assuming I could add the Auto Button to the front but not sure on the board where that connects at this point. But I noticed the OLED and Program header being used on the board is bent over and wires are soldered directly to the header. That was a surprise. I'll figure out how to get the PICkit3 connected. I want to put it in "Auto" Then put it out at the antenna. I only have one software question at his point. There are some Forever While Loops "while(1) { bla bla bla }; in the code that appears to be part of the testing stuff. I did not see anything obvious to me on a break out of the loop.  Is that just for the testing and once entered the only way out is power down or reset? Or am I missing something?

I have looked at the MPLAB Compiler and I think I will stick with mikroC.

I won't bother you any more this December. I'm sure you got things going on and so do I . I've got the Mag Loop stuff I have not finished. Then in Jan. I'll get back to this . My goal is to have this at the antenna and have it take care of matching automatically.  Whether I ever get to the point where I can see the data in the shack is another project. I appreciate your help.

Thanks,
Steve W8TTY

Dfinitski, 2020-12-04:
Hi, Steve.
Those are infinite loops for Fast test mode, manual mode and fider loss
setting mode. (In the 3.1 firmware).

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

sparkey2450, 2021-01-20:
David,
Happy new year hope all is well for you. I saw something in sharp_cap(). Int mem_swr; but down in the code its mem_SWR; Am I missing something? I've been porting this to the MpLab Compiler XC8. Got it to compile today. Have not tested it. I stripped out the things I do not need. If you want a copy send an email directly to my email address. My email address on my QRZ is correct. Thansk
Steve W8TTY

Dfinitski, 2021-01-20:
Hello, Steve.
Did you mean *min_swr* ? My compiler allows to use these names, it is not a
mistake for MikroPic. Actually *int min_SWR* , you are right.

ср, 20 янв. 2021 г. в 15:12, sparkey2450 <notifications@github.com>:

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

sparkey2450, 2021-01-20:
I have both compilers. The Mikro compiler did not flag it. The MpLab one did flag it. Like I said I stripped out most of the things I do not need and just using it to to match the antenna, Took me awhile to get my head back on straight and relearn lots of stuff I forgot. I've been retired for 16 years. Like I said if you want what I have or end up with you are more then welcome. I like the MCC function of the MpLab. Thank again.  
On 1/20/2021 6:39:35 PM, David Fainitski <notifications@github.com> wrote:
Hello, Steve.
Did you mean *min_swr* ? My compiler allows to use these names, it is not a
mistake for MikroPic. Actually *int min_SWR* , you are right.

ср, 20 янв. 2021 г. в 15:12, sparkey2450 <notifications@github.com>:

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

—
You are receiving this because you commented.
Reply to this email directly, view it on GitHub [https://github.com/Dfinitski/N7DDC-ATU-100-mini-and-extended-boards/issues/12#issuecomment-764029925], or unsubscribe [https://github.com/notifications/unsubscribe-auth/AR5SWBCCDPAJ7TWMG2O6M53S25STPANCNFSM4P2BCPVA].

actionwatcher, 2021-01-22:
@sparkey2450: Steve, do you have MPLab project shared somewhere?

Thanks, Arkady/NU6N

sparkey2450, 2021-01-24:
David,
In the routines get_reverse() and get_forward() you setup FVRCON for 3 different reference voltages for the ADC and return based on a value read. What was the reason you used all 3? FVRCON - 0b10000001, 0b10000010, and 0b1000011.  Thanks,
Steve W8TTY

Dfinitski, 2021-01-24:
Hello, Steve.
That is increasing a measurement accuracy.

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

sparkey2450, 2021-01-25:
David.
Still trying to get my head rapped around the use of variable Vrefs in get_forward() and get_reverse(). Could not the forward measurement and the reverse measurement end up using different Vref's in their reading during a calculation cycle? Maybe it doesn't matter. Anyway I'll get it eventually. My real question is where did all the correction numbers come from in the conversion() routine? Hopefully my 2nd tuner will be here this week and I will get a chance to start testing the software.  Hooking up the PicKit3 for debug is just another hurdle. I appreciate you taking the time to answer my questions. Thank You
Steve W8TTY

Dfinitski, 2021-01-25:
Hi Steve
I don't understand you, where did you find the Vref variable ? I don't see
it.
Numbers in the correction routine are results of real measurements. Those
do compensate for diode's characteristic and make power measurement is more
accurate.

вс, 24 янв. 2021 г. в 16:43, sparkey2450 <notifications@github.com>:

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

sparkey2450, 2021-01-26:
David,
I figured it out as to what was in conversion(). The Vref was where you set it up in FVRCON bits 0 and 1 where you select the different Vrefs in the ADC. All is good now

g8kwx, 2021-02-17:
Has anyone sucessfully ported the source code project from MikroC to MPLAB or other IDE ?

sparkey2450, 2021-02-17:
G8KWX,
I've got some of David's Code running on MpLap's IDE and XC8 Compiler. I have a version that does tune. I stripped out all the code that did not pertain to the box I was using as it was prebuilt. I also removed the OLED as I'm matting this to a Raspberry Pi to use the WiFi. Its far from done but you are welcome to where I've taken it so far. I've gone through much of the MikroC stuff and converted it to MpLabs. There are a number of function calls used that do not port over and are unique to MikroC. I used MCC to generated the Init code.  If you want a copy of all of it you can just go to my QRZ page and use that email to make a request and I will send a zipped up bundle of the MpLabs Project. I have taken David's coded box, set it to Auto, and stuck it out at the antenna. It works well that way. And if that what you're looking for there's no need to change anything.

Steve (W8TTY)

khkremer, 2021-03-08:
Steve,

when you scroll up to the beginning of this thread, you will find that I started this ;) My PIC skills were not good enough to start port, but I might be able to work with what you already have done, and would not mind a copy of your code s as well.

Thanks and 73,

Karl Heinz - K5KHK

sparkey2450, 2021-03-08:
Hello Karl,
Yea never know with email how things go. This is the first email I've seen from you. Here is a copy of what I sent. Its know where near done but a start. It does do tuning but sometimes misses the mark. When you compile this with MpLabs XC8 compiler you will see a bunch of warnings about functions that are not called.  I used MCC to generate much of the code to the PIC. They have everything in there but the kitchen sink. There is no OLED interface with this code and I stripped out anything I did not need for my particular box.  Also there are some of the original c code functions that are no longer used. I found it hard to follow the original so I just started to type in my own. Been a while since I looked at this as I've been working on the I2C communication stuff and not the tuning. I figured I'd get back to tuning when I get the communications running.This is a start and gets it compiling under MpLabs. Originally I was going to hook this to a Raspberry Pi, which I do have running on some other code. But after getting into it, it was clear that what was really needed was hooking a WiFi module to the tuner and having the Tuner do the communications. I'm waiting on that module now. Much of the I2C stuff with Raspberry Pi I did should carry over. None of that is in what I'm sending. I tried to put in more comments and make the code more readable so I hope that helps. Good luck and have fun. This is a good board to learn programming on.   

Steve (W8TTY)  
On 3/8/2021 6:36:21 AM, Karl Heinz Kremer <notifications@github.com> wrote:
Steve,
when you scroll up to the beginning of this thread, you will find that I started this ;) My PIC skills were not good enough to start port, but I might be able to work with what you already have done, and would not mind a copy of your code s as well.
Thanks and 73,
Karl Heinz - K5KHK
—
You are receiving this because you were mentioned.
Reply to this email directly, view it on GitHub [https://github.com/Dfinitski/N7DDC-ATU-100-mini-and-extended-boards/issues/12#issuecomment-792695686], or unsubscribe [https://github.com/notifications/unsubscribe-auth/AR5SWBGC5OLXFPFSURDNCBLTCSZDLANCNFSM4P2BCPVA].

g8kwx, 2021-03-08:
Steve, was there an attachment somewhere ?

sparkey2450, 2021-03-08:
You will not get it unless you email me directly. My email is on my qr page for W8TTY. 
On 3/8/2021 11:49:38 AM, g8kwx <notifications@github.com> wrote:
Steve, was there an attachment somewhere ?
—
You are receiving this because you were mentioned.
Reply to this email directly, view it on GitHub [https://github.com/Dfinitski/N7DDC-ATU-100-mini-and-extended-boards/issues/12#issuecomment-792893555], or unsubscribe [https://github.com/notifications/unsubscribe-auth/AR5SWBHCJX2SPVQC7SMRF63TCT52FANCNFSM4P2BCPVA].

g8kwx, 2021-03-08:
Steve, as said I have emailed you several times. Just now also. Maybe i am going to junk :-)

davidhay45, 2022-01-25:
@sparkey2450 how does your project stand at the moment?
I have just (today) started to compile the code using MikroC 7.6 and obviously the learning curve is high.  Any pointers, like which libraries do I need?

Dfinitski, 2022-01-25:
Hi. I will try new matching algorithm soon.
All needed libraries are included

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

sparkey2450, 2022-01-26:
I'm not using MikroC. I used MPLabs. I sort of shelved the Tuner Software as I got involved with Mag Loops. Been so long since I looked at the Tuner software I'd have to almost start all over. I have a Mag Loop Tuner that uses WiFi. Its developed on the ESP8266 Module and a stepper motor. The Capacitve tuning for the Mag Loop is complete. I've had the Mag Loop up and running. The human interface is Blynk. I use the local server version.  There are some pics on my QRZ page. I'm in the process of also setting up a WiFi control for an Antenna Rotor so I can rotate the Mag Loop. The Rotor software is about 75% complete. I just need to come up with a way to indicate direction. The end result is a mag loop that can be tuned and rotated from the shack using WiFi. The only thing else needed is 12 VDC to power the equipment at the antenna. Battery works well mated to a solar panel charger or 12 VDC run over the coax.  Steve (W8TTY)
On 1/25/2022 4:51:37 PM, David Fainitski ***@***.***> wrote:
Hi. I will try new matching algorithm soon.
All needed libraries are included

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

—
Reply to this email directly, view it on GitHub [https://github.com/Dfinitski/N7DDC-ATU-100-mini-and-extended-boards/issues/12#issuecomment-1021643052], or unsubscribe [https://github.com/notifications/unsubscribe-auth/AR5SWBF3OLME3BYREVAXMPTUX4LOTANCNFSM4P2BCPVA].
Triage notifications on the go with GitHub Mobile for iOS [https://apps.apple.com/app/apple-store/id1477376905?ct=notification-email&amp;mt=8&amp;pt=524675] or Android [https://play.google.com/store/apps/details?id=com.github.android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].
You are receiving this because you were mentioned.Message ID: ***@***.***>

davidhay45, 2022-01-26:
@sparkey2450 Thanks, I'll comment here as to how I get on.
@Dfinitski Thanks for coming back. I am hoping to make a version of the software which allows a small number of pre-tuned settings to be used with WSPR on different bands.  I have not got a test bed yet but my experiments with MiKroC 7.6 look good.  One question, do I need to change the config registers externally, at the moments I have
CONFIG1 : $8007 : 0x3FEA
CONFIG2 : $8008 : 0x1633
Thank you for making this software available!!

Dfinitski, 2022-01-26:
Hi. All the configurations parameters set with the MikroC. See the project
menu.

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

sparkey2450, 2022-01-26:
The best place I ever found to put the ATU100 is out at the antenna feeding a 123 foot long wire with a 9:1 UNUN. I used David's earlier software build 3.0 and put the ATU100 in Auto out at the antenna. It did make a difference. I could work 160 thru 10 meters. I got the code ported over to MPLabs Compilier but rewrote much of the MikroC because some of the Libraries and functions used by MikroC are not transportable. I used a highly modified I2C sort of protocol to talk between the ATU100 and the ESP8266. The ESP8266 was setup as a server so you could get at the interface at the antenna via a simple web browser over WiFi. I had the proof of concept software completed and just needed to do some work to make it more reliable. Was not happy with the tuning portion. That's is when I got interested in looking into a Mag Loop. Very Impressed with that antenna. I hear things and make QSO's that were impossible on the long wire. Mated it to a Hermes Direct Conversion SDR and the reception runs circles around my ICOM 7100  . Biggest draw back of the Mag Loop was the tuning. Its extreme narrow bandwidth characteristic which makes it quiet is also one of the drawback if you like to surf the band you are using. This is why I did the WiFi interface to the tuning capacitor. The antenna works just as well as any dipole I've used and it only needs to be a few feet off the ground.
 
The presets you talked about is a good idea. Especially for some of the communication protocols that are at predefined frequencies. Good luck on your project. Maybe someday I'll get back to the ATU100.
On 1/26/2022 10:31:55 AM, David Fainitski ***@***.***> wrote:
Hi. All the configurations parameters set with the MikroC. See the project
menu.

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

—
Reply to this email directly, view it on GitHub
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

Thread 13 (2020-09-05):

Relay S8 appears to be energized when the ATU is in its Reset state

rogerclarkmelbourne, 2020-09-05:
Hi.

I've noticed that I relay S8 seems to be energized when the ATU is in its Reset state.

As far as I can tell, S8 appears to connect the capacitive load chain to either the RF input or RF output side of the inductor chain, but in the Reset condition.

Was there a reason for doing this, as it causes the ATU to draw some unnecessary current when its in its Reset state.

Dfinitski, 2020-09-05:
Hello. Yes it is.
Because in that relay position the own SWR much better due to compensation own inductance and capacitance.

rogerclarkmelbourne, 2020-09-05:
If the PCB was redesigned, could this be resolved by changing the connections to the relay, so that the Normally Open and Normally Closed were transposed ?

Dfinitski, 2020-09-06:
See the schematic, the relays contacts are shown in the power off position. You will see how the inductances are conected to input or output when the relay is in ON position.

rogerclarkmelbourne, 2020-09-06:
@Dfinitski

OK.

I viewed the S8 as selecting which side of the inductors the capacitors are connected.

As far as I can see, one side of inductor L1 is connected to the RF input J2, and one side of inductor L7 is always connected to the RF output.

i.e

```
RFin --- L1 --- L2 --- L3 --- L4 --- L5 --- L6 --- L7 --- RFout
         |                                              |
         -------------------> | <------------------------
                              |
                              |

                           C1 to C7
```

Closed 2020-09-07.

Thread 14 (2020-09-07):

Question about the capacitor across the relay solenoid

rogerclarkmelbourne, 2020-09-07:
I'm curious why you have not used flyback protection diodes across the relays and have instead used a 1uF capacitor

Was this to fix some specific problem, e.g chattering  or perhaps noise spikes ?

Dfinitski, 2020-09-07:
Because a powerful interference can be rectified on the diode and can turn on the relay. But maybe not.  Capacitors work well anyway. My oscilloscope show me very clean control lines.

rogerclarkmelbourne, 2020-09-07:
OK. Thanks

Closed 2020-09-07.

Thread 15 (2020-09-08):

Simple Test mode - Inductance stepping

va3rr, 2020-09-08:
David - my recently constructed ATU-100 EXT seems to work as intended.  As well, the Fast Test Mode energizes all the relays as expected.

However, in the Simple Test Mode, I cannot step through the entire range of inductances, as expected.  Inductance is added as expected until reaching 2.20 uH on the LCD, then all the inductances are removed, and the cycle repeats until 4.50 uH, when all the inductances are again removed.  It's not until I reach 6.70 uH on the LCD meter that expected amount of inductance is added, and works normally until 8.53 uH.

I checked the capacitance side, but all the relays seem to add capacitance as required, when stepping through using the Simple Test Mode.

Is this an issue that may affect the normal functioning of the ATU-100, or should I not worry about it?

спаси́бо de va3rr

Dfinitski, 2020-09-09:
Hello.
What kind of display do you use ? I have tryed with OLED 128*32 - works good.

va3rr, 2020-09-09:
I'm using a 1602 display and it works well.  It's just that the relays (just for the inductance) do not energize when expected in the Simple Test Mode.

All of the relays work, but not in correct order.  When adding inductance, everything works fine and increments normally up to 1.83 uH and relays are 0011111. (where 4.4 uH is most significant digit)

But when I step up to 2.2 uH, relays are 0000000 and when I increment once to 2.25 uH, relays are 0000001, when I expected 0100001.

Relays for 4.4 uH and 2.2 are never energized in Simple Test Mode until I reach 6.70 uH, then all relays are energized as expected (1100000), and all relays energize as expected in proper order right up to 8.53 uH (1111111).

My apologies if my explanation is not too clear...

Dfinitski, 2020-09-09:
Other words, A5 line of PIC or 2.2uH control line is not working.
Please check again this line in Fast Test very carefully again.
Use a multimeter to measure a voltage between relay's coil nodes.
I have check the code, no errors here.

Dfinitski, 2020-09-09:
Here is the code, L_mult = 4:
```
if(L & ind<32*L_mult-1) {
              ind ++;
              set_ind(ind);
           }
           else if(!L & cap<32*L_mult-1) {
              cap ++;
              set_cap(cap);
           }
```

va3rr, 2020-09-09:
Well, you are indeed the master of your wheelhouse.  Thank you. My supplier in Irkutsk had left an odd combination of cold solder joints and a perhaps a solder bridge (to VSS?).

What was confusing me was that in Fast Test Mode, somehow 4.85 volts WAS being applied to the gates of Q12 and Q13.   But in Simple Test Mode, nothing was being applied to those two gates, except in the circumstances I described above.  In fact, the two gates had 0.65 volts on them when they should been very close to, or at 0 volts, when not active.  Perhaps because RA4 and RA5 are physically close to VSS?  IDK...

If I were to build this kit again, I would certainly recommend that prospective builders put a voltmeter to the gate solder pads for all the mosfets BEFORE soldering them, using Fast Test Mode.

In any case, all is working as designed.  Again, many thanks!

Closed 2020-09-09.

Thread 16 (2020-09-09):

Nothing during TUNE

Jean-france, 2020-09-09:
Hi,
I bought the full installed ATU  (CGJ-100), see picture.
The firmware is V3.0.
There is a problem because when the ATU isin AUTO mode, we can see SWR : TUNE but nothing happen. ATU stay still or until i BOT it. So no according antenna do.
Can you explain what is this issue ?
Many thanks in advance.
Best regards,
Jean

Dfinitski, 2020-09-09:
Hi. 5 Watt is not enough for normal operation.
You have 2 ways to resolve this.
1) reprogram cells to work starting 1 Watt
2) rebuild the tandem match to 1:5 and reprogram cells.
Second is much better.

Jean-france, 2020-09-09:
Hi,

Many thanks for your reply.

OK, it’s working but with 28 W output power from TX (with linear amplificator).

Sorry, but how to rebuild the tandem match to 1:5 and reprogram cells ?

BR
Jean

Dfinitski, 2020-09-09:
Now the tandem match has 10 turns, remove 5 and leave 5.
After that buy  Pickit 3 programmer and change cell 05 to 01 value, cell 31 to 05 value.
Read the user manual you can find here. Goggle "pickit 3 programmer how to".

Dfinitski, 2020-09-09:
Read this conversation also
https://github.com/Dfinitski/N7DDC-ATU-100-mini-and-extended-boards/issues/2#issuecomment-499742247

Thread 17 (2020-09-10):

T1 & T2 turns Ratio formula

KenLotts, 2020-09-10:
Is there a formula to use to design a custom T1/T2 turns ratio for optimum use at a given power level?

I see the manual gives a solution for 40 watts (1:5) and 150 watts (1:10) and for some reason they even mention 1500 watts (1:32)

The manual mentions that the turns ratio should be designed to prevent the sense voltage from exceeding 4.096 Volts for the PIC16F1938 processor and 5.0 Volts for the PIC18F2520 processor."

So ...  I was wondering ...What is the formula I would use to optimize T1/T2 for a given maximum power level?

Ken Lotts

Dfinitski, 2020-09-10:
Hello, Ken
That is formula based on Ohm Law, I hope you heard something about that.    I = U / R.      P = U * I  = U * U / R.
So average voltage value for an example 300 Watt of power equal to U = SQRT(P * R) = 122.5 V. It will be decreased on a tandem match according to his ratio, an example 1:20, 122.5 / 20 = 6.12 V . Actually this voltage will be closer to peak value, so multiple it to SQRT(2) = 1.41,   so 6.12 * 1.41 = 8.65. This voltage will be devided by 3 with the resistor devider, so 8.65 / 3 = 2.88 Volts.  A you can see this value is pretty far to 4.1 and 5 Volts, so this tandem match ratio is to big for maximum power 300 Watt.

KenLotts, 2020-09-11:
Thanks.. Good job.  Nice explanation, I had neglected the 3:1 divider which is what threw me.
And the half wave rectifier was the final piece... plus a bit of efficiency fudge
So..  I wrote an approximate formula that seems to work (in excel) .. I made a fudge guess of subtracting 0.27 to the solution since that made it line up better with the provided examples of 40, 150 and 1500 watts

Optimum Turns Ratio = ((SQRT(<MAXPOWER>*50)*SQRT(2))/12)-0.27

I checked the formula on the examples and got:

40 watts = 5.000463 turns ratio
150 watts = 9.936207 turns ratio
1500 watts = 32.00486 turns ratio

Ken
AA7JC
--

--

--

rogerclarkmelbourne, 2020-09-11:
Guys.

Initially this seemed counter intuitive to me, but I see that effectively T1 is the primary winding and the unlabelled straight through line is the secondary. Hence the pickup's are currently a 10:1 step down transformer not step up.

So using more turns on the primary (T1), increases the step down amount.

Is this logic correct ?

Dfinitski, 2020-09-11:
Excellent, Ken
It is very helpfull for people.
But where is a power in this formela ?
**Optimum Turns Ratio = ((SQRT(*50)*SQRT(2))/12)-0.27**

Roger, that is step down transformer, correct.

KenLotts, 2020-09-11:
Sorry.. Cut and paste did some funny business

Optimum Turns Ratio=((SQRT(MAXPWR*50)*SQRT(2))/12)-0.27

rogerclarkmelbourne, 2020-09-11:
@Dfinitski

Thanks for the confirmation.

Thread 19 (2020-09-19):

Case for N7DDC ATU-100

w1ksz, 2020-09-19:
Anyone know where one can get a case to mount the Tuner in ?

It has to be for the square display not the rectangular one.

va3rr, 2020-09-22:
LY2BOK provides a link to a IDEZ50A case that looks to be a perfect fit.  I have no idea how to get one inexpensively shipped to North America...

[http://www.qrz.lt/ly2bok/Rusian%20variant/Konstrukcijos/ATU-100/ATU-100.htm](url)

Dfinitski, 2020-09-22:
Choose the similar box here https://www.digikey.com/products/en/boxes-enclosures-racks/boxes/594?k=box

w1ksz, 2020-09-23:
I found a blank box on e-Bay. With my Dremel and my files
it should work.

Thanks for the reply,

73, Dick, W1KSZ
________________________________
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

Thread 20 (2020-09-23):

PICkit 3 tips

3d0g, 2020-09-23:
Been a long time since I messed with PIC micros. Didn't have any fancy gui tools back then. In PICkit 3 I can read and verify the PIC16F1938 fine, check communication says PIC device found, but when I try to write the firmware hex file, I get a "Programming failed at Program Memory address 0x000001." Re-reading the PIC shows that only the 1st word was written to Program Memory and 1st byte to EEPROM Data.

What am I doing wrong?

Dfinitski, 2020-09-23:
I saw the similar error  when my Pickit3 programmer was burned. I had
burned him when Iwas playing with a tuner board, some bad power sequence or
something like this, I did not remember.
Just ordered a new one.

ср, 23 сент. 2020 г. в 15:50, 3d0g <notifications@github.com>:

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

3d0g, 2020-09-23:
It's a brand-new PICkit 3. Just unboxed it today. I rummage through the parts bins and see if I've got a DIP PIC somewhere to test the PICkit with. SSOP PICs are brutal on these old eyes.

Dfinitski, 2020-09-23:
It does not matter what kind of package you are programming. You can read
the chip, so all the connections are good., but for successful writing, the
programmer should generate relatively high voltage on the MCLR pin, about 8
Volts. If you have an oscilloscope, you can check this.
Also you can try to use the programmer in a LVP mode, search the options.
In this case a MCLR voltage is not exceeding 5 Volts.

ср, 23 сент. 2020 г. в 16:41, 3d0g <notifications@github.com>:

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

rogerclarkmelbourne, 2020-09-24:
BTW. I have an old PICKit2.  Would this work ? I think the PIC18F1938 is supported.

Dfinitski, 2020-09-24:
Hi, Roger
It is not supported but you can find in the Internet updated file for new
PIC support.

ср, 23 сент. 2020 г. в 17:11, Roger Clark <notifications@github.com>:

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

rogerclarkmelbourne, 2020-09-24:
Thanks David,
I'm a bit cautious about attempting to even change the EEPROM, but I have another kit on order from China, so will probably do some serious hacking on that one when it arrives

Dfinitski, 2020-09-24:
I have ordered Microchip Snap board - very cheap and compatible with all
the new PICs. But only LVP programming.
Rapidly fast delivering from Microchip Direct Store, 2 days.

ср, 23 сент. 2020 г. в 17:34, Roger Clark <notifications@github.com>:

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

rogerclarkmelbourne, 2020-09-24:
Thanks David.

I'm actually in the process of porting your board to use a STM32F103 micro-controller, as I"m more used to using ARM MCUs.

However as you will appreciate, its not a 5 minute job, as I also need to layout the board again, using KiCad, as well as port the firmware... So I estimate it will be Christmas before I have anything vaguely working

Dfinitski, 2020-09-24:
Why dont you use PIC32 ? Those are ARM too :)

ср, 23 сент. 2020 г. в 17:53, Roger Clark <notifications@github.com>:

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

rogerclarkmelbourne, 2020-09-24:
I'm most comfortable with STM32 MCU's.

3d0g, 2020-09-26:
OK, I got absolutely nowhere with PICkit 3 v3.01 software, every PIC variant I had in the bins failed. So I ordered another programmer but while waiting I figured I'd try MPLAB X today. Reverted the programmer back to MPLAB mode and lo and behold, MPLAB IPE programs up the PIC just fine. Tuner is alive and kicking!

Now I remember why I quit using Microchip in my projects. ;-)
Thanks for the assist folks.

Dfinitski, 2020-09-27:
That the reason why Pickit 3.xx is no longer supported by Microchip and it is impossible to get it from offciall Microchip's resources.

3d0g, 2020-10-03:
Just to finally close the loop on this for others that may be reading, I finally got in a GENUINE PICkit 3 from eBay and it worked flawlessly with the PICkit programming software. My original programmer was clearly a chinese knock-off. The board looks completely different than the Microchip one, even though the case is identical. Lesson learned.

MOUSE1025, 2020-10-04:
Dave,
Thanks for the heads up. I am going to check mine and see if it is a
knock-off.
Kind regards,
Christopher

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

kk4das, 2021-11-19:
I know this is an older thread but I experienced a similar problem.

 I just completed my tuner build and wanted to update to the 3.2 firmware.  I have never used anything PIC before but I'm a 40 year plus software guy so "How hard can it be?"   :)

I'm using a PICkit 3 clone randomly chosen from the dozens on the Bay.  Downloaded the 3.01 programming software from the Microchip archive.  Every attempt at a write fails on verify and similar to the OP - a read appears to have only written the first byte or perhaps some random bytes.  That said, after multiple attempts at writes I popped the display back on and the doggone thing booted up in the 3.2 firmware and as far as I can tell it works flawlessly.

I'm probably going to lead a Maker's group build of this tuner so I'd need to be able to reliably work on it.  Don't know if there is a knock off programmer vendor that is more reliable or if there is another approach I could try.  "Geniune" PICkit 3's go for ridiculous prices on the Bay.  PICKit 4 is $70 direct from Microchip so maybe that is the way to go.

Any suggestions would be appreciated.

Thanks and 73,
Dean
KK4DAS

Dfinitski, 2021-11-20:
Hi.
Chinese clone of Pickit 3 works great and has a reasonable price

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

3d0g, 2021-11-20:
The MPLAB IPE works fine with the PICKit clones in my experience. It's just the PICKit 3 software that has issues.

Closed 2020-09-26.

Thread 21 (2020-10-07):

Someone asked me to find out if the MCU wakes periodically to check the SWR?

rogerclarkmelbourne, 2020-10-07:
Hi

I've not noticed this myself, as my local QRM is too noisy, but someone who uses your ATU for SOTA work, reported to be that they thought the MCU was occasionally waking up and causing QRM

I've had a look in the code, but I can't see anywhere that the MCU is put it a sleep mode, but its quite possible you are doing this via a direct register setting to the PIC and I'd not notice that in the code.

Dfinitski, 2020-10-08:
Hello, Roger.
Some people use chinese full assempled tuner with a built-in Li-Ion battery. This device containes a power bank standart electronic board with a DC/DC PMIC wich is the source of RF interferences.

I never heard before from hundreds russians and polish users about this problem. They use this autotuner 2 full years.
It was first published in 09/09/2018 on cqham.ru

The MCU can not to go sleep because it meassure a power and SWR continiously.

rogerclarkmelbourne, 2020-10-08:
Hi David

Thanks for the quick response.

I'm afraid I don't know whether these SOTA guys were using a chinese kit with a built in battery or not.

But, I'll pass the message back to the guy who asked me, (who wasn't the person who directly experienced the problem)

Also, its interesting that the MCU is constantly sampling the SWR.
As the MCU seems to be taking virtually no current as far as I could tell, I presumed that you put it into a sleep mode, and only woke it up when a button was pressed.

But I suspect my cheap Chinese made bench PSU, fails to register any current when the board is only taking a few mA

Thanks again for the reply

sandroatu100, 2020-11-13:
Hello
I connected a 50 ohm load (Bird 3 Ghz, but is the same with any load) to the out port, Bypass function activated.
The swr indication with 10W( any power) is:
7 MHz swr 1.2
14 MHz swr 1.5
24 MHz swr 2.1
30 MHz swr 3.0
above higher
But really on the at-100 input there is 50 ohm tested with nanovna and swr meter
May you reply a hint?
Atu-100 is 7 cells version with firmware 3 and oled display
Regards
Sandro

Dfinitski, 2020-11-13:
Hi.
If you have a NanoVNA, you can connect it to the tuner input and check the SWR by frequency and even find why the SWR is so large.
I am pretty sure that the large relay's capacitance is the reason to that.

Dfinitski, 2020-11-13:
Here is a other user report, bypass is above
http://www.cqham.ru/forum/attachment.php?attachmentid=307210&d=1550015243

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

sandroatu100, 2020-11-14:
Hi David,
I tested with nanovna the atu-100  input and output swr with 50 ohm load and is correct, that means no mismatch is caused by the atu100.
    It is wrong  the indication on the atu100 display coming from the internal directional coupler made with ferrite.
(on Ebay there are two versions with short or long ferrite, mine is long)
Attached the photos
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
Tested the 50 ohms resistors smd on the pcb are correct.
Sandro

sandroatu100, 2020-11-14:
Hi David,
I found where is the problem.
In bypass mode there is a single pole relay but should be double pole.
The through path goes by the inductance path all shorted but the path is too long.
I shorted as a test with a wire bridge the path and now the swr reading is correct.. so will put a double pole relay and modify it.
Photo is attached.
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
Thank you for this project, let me know your opinion.
Regards
Sandro

Dfinitski, 2020-11-14:
Hi, Sandro
I think you are not right.
Check the schematic, no any double pole relays there.
As I told you before, if you have a NanoVNA, connect it to the input and
find what is the reason for the large SWR.

сб, 14 нояб. 2020 г. в 10:50, sandroatu100 <notifications@github.com>:

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

sandroatu100, 2020-11-15:
Hi David,
I found where is the problem.
In bypass mode there is a single pole relay but should be double pole.
The through path goes by the inductance path all shorted but the path is too long.
I shorted as a test with a wire bridge the path and now the swr reading is correct.. so will put a double pole relay and modify it.
Photo is attached.
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
Thank you for this project, let me know your opinion.
Regards
Sandro

sandroatu100, 2020-11-15:
Hi David,
yes I know there is only 1 relay , I have the schematic.
Using a double ralay , in bypass mode, is better the isolation from the atu to the antenna and so the swr(casued by the atu)
It's an improvement in bypass mode and also other network analyzer confirmed. But is possible to use as original.
 The atu works good except one condition:
Frequency 3,77 MHz antenna is a loaded dipole
In manual mode I found perfect matching with 4,95 uH and 0pF .   But pushing tune button no way to match the load, the
controller don't find the tune automatic. I can do only manually.
Anyway, I appreciated the useful functions in most cases.
Regards,
sandro

Dfinitski, 2020-11-15:
Hi, Sandro
There is no any special signal from mcu for bypass mode.

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

Thread 22 (2020-10-30):

reprogramming atu-100

olson339, 2020-10-30:
Need some help with the i2c reprogramming. I have a 1602 LCD with a i2c backpack. I used i2c scanner to find out the address, which is 3F. I changed the address using a PIC 3 and wrote the change to my ATU-100. Connected the LCD, background light comes on along with 16 square blocks on second row. I readjust the brightness but no readable display. I am using ver 3.0 of your frimware

Dfinitski, 2020-10-30:
Hi.
Your I2C address scanner gives you 7 bit address, but the tuner board uses 8 bit address.
As you can reed in the manual,
"**The port extension board for display 1602 made on the PCF8574AT chip has the address 7E, on the chip with the “T” index - 4E.** "
So no any ambivalent understanding which address you have to use.

olson339, 2020-10-30:
so the scanner shows 0x3F. I enter 3F in cell 00 of the EEPROM. Should the entry be different

Dfinitski, 2020-10-30:
Did you read my previous message ?
What kind of chip is used in the "backpack" of LCD ?

olson339, 2020-10-30:
yes I read your previous message - the chip on the backpack is PCF8574AT

Dfinitski, 2020-10-30:
Excellent, your I2C address is 7E.

olson339, 2020-10-30:
ok thanks

olson339, 2020-10-30:
The tuner is working but I haven't added any buttons yet for auto/bypass

Dfinitski, 2020-10-30:
Can you confirm this behavior ?
https://www.youtube.com/watch?v=mUfD4gnzswc&t=1s

olson339, 2020-10-30:
I ran the tuner using my 7300. Display worked correctly from star, tune, operate

Sent from my iPhone

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

Dfinitski, 2020-10-30:
Thank you for the help.
you can test the newest firmware https://drive.google.com/file/d/1sCYbo3DPGjM-r94aqZJpuZqGIvasgv6K/view
if you want.

valantis-chios, 2020-11-04:
Hi, I would like to inform you that the DIY kit that I bought has the same problem as described in the video. Firmware is 3.0. what do you propose to do? I am using lcd 16x2. I am waiting to receive pic programmer to check the hex and eeprom.
Thanks in advance

Dfinitski, 2020-11-04:
Hi,
the 3.1 firmware version should work fine. Use a Pickit 3 to change the old firmware.
If you will have some problems with 1602 LCD please tell me know ASAP.

valantis-chios, 2020-11-13:
20201113_161618.mp4
<https://drive.google.com/file/d/1aXIEYz6RTYQtXtyHNyLcT5btIjO8TpyP/view?usp=drivesdk>

  20201113_161849.mp4
<https://drive.google.com/file/d/1elP15rnoYLPoujuj1u5GEO6MsJs92JkB/view?usp=drivesdk>

Στις Τετ, 4 Νοε 2020 - 18:33 ο χρήστης David Fainitski <
notifications@github.com> έγραψε:

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

Dfinitski, 2020-11-13:
Hi,
What kind of chip is used in the I2C extender of your LCD display ?

valantis-chios, 2020-11-13:
Hi, the chip is PCF8574T

Dfinitski, 2020-11-13:
Thanks.
I will order LCD with this chip and check this by myself.
I can not find the problem in the code also other users report about good
work with LCD.

On Fri, Nov 13, 2020, 10:23 AM valantis-chios <notifications@github.com>
wrote:

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

valantis-chios, 2020-11-13:
One more thing,  how does the type of display affect the tuning process?

Dfinitski, 2020-11-13:
I is not matter, you can use the tuner even with no any displays, it is
only an option.

On Fri, Nov 13, 2020, 10:57 AM valantis-chios <notifications@github.com>
wrote:

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

valantis-chios, 2020-11-13:
20201113_235455.mp4
<https://drive.google.com/file/d/1IMidnI6zYtDpbtd9VnnCxdzalz9Px1o9/view?usp=drivesdk>

Στις Παρ, 13 Νοε 2020 - 21:04 ο χρήστης David Fainitski <
notifications@github.com> έγραψε:

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

valantis-chios, 2020-11-13:
Hi, I rewind tandem match and the problem with tuning seems to be solved ( maybe there was a short between filament and ferrite). But the problem with no swr indication  still exist.

Dfinitski, 2020-11-13:
The LCD will come to me next Thursday. I will see.

пт, 13 нояб. 2020 г. в 14:44, valantis-chios <notifications@github.com>:

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

Dfinitski, 2020-11-17:
Hi.
I have bouth randomly an LCD with PCB8574T expansion board on Ebay, I2C address is 4E.
Everithing works good.
I tried to find mistakes in the code also, many times, but I don't see anything wrong.

Dfinitski, 2020-12-01:
People, watch this video https://www.youtube.com/watch?v=vWtbs4n4ewo&t=18s
If somebody knows what is going on - tell me know, I will fix it.

valantis-chios, 2020-12-01:
Hi, I have the same problem like no 2 and no 3 lcd( no swr indication). Tuning possess is ok.

Dfinitski, 2020-12-02:
Hi. Order the chiepest LCD on Ebay or Aliexpress, should to work. I don;t know what is the reason, so I can't resolve this problem.
I don't have a strong expirience with this kind LCD, i have no idea what is going on. But definatelly those LCD have some differences.

owenaggi, 2021-02-26:
help i dont understand what i have done i have the picket 3 and ext board i wanted to use it on low power when trying to reprogram i have some how deletet the pic and now when i try to program the pic picket 3 tells me that there is insuffichet memory please tell me a what i did wrong and if possable how to fix it

TA2KW, 2021-10-16:
hello, I made a connection with 1602 LCD, I2C PCF8574T converter, but the 7805 transistor in the circuit supply is overheating, I could not solve this problem, why does the 7805 get hot? :(

Dfinitski, 2021-10-16:
Hi.
Everything works good but 7805 is hot ?
What is the voltage rate of the relays ?

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

TA2KW, 2021-10-16:
1602 LCD screen gets hot when I plug it in,
No problem with oled display.

Dfinitski, 2021-10-16:
So check the connection, power voltage polarity.

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

Thread 23 (2020-11-05):

Replacement Diodes

KevAmiga, 2020-11-05:
Afternoon all - I need to replace 2 of the diodes on the underside of the board, but am unsure of the values, or in essence what diodes to purchase. Installing them shouldn't be a problem. This issue was down to my mistake, i needed to modify the case and slipped with the tool hitting the components (lesson learned!)

Please excuse the rubbish photo, it was the best i could get .

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

Their location on the board :
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

Hoping someone can point me in the right direction.

Many thanks

Kev

Dfinitski, 2020-11-05:
Hi, Kevin
According to the schematic those are BAT41 diodes.
This info is not a secret, everyone can see the schematic.

KevAmiga, 2020-11-05:
Excellent - thanks, have found the schematic will take a look.

Kev

Closed 2020-11-06.

Thread 24 (2020-11-13):

ATU-100 swr indication error

sandroatu100, 2020-11-13:
Hello
I connected a 50 ohm load (Bird 3 Ghz, but is the same with any load)  to the out port,    Bypass    function activated.
The swr indication with 10W( any power) is:
7 MHz   swr   1.2
14 MHz  swr  1.5
24 MHz   swr  2.1
30 MHz   swr  3.0
above  higher
But really on the at-100 input there is 50 ohm tested with nanovna and swr meter
May you reply a hint?
Atu-100 is 7 cells version with firmware 3 and oled display
Regards

2E0DMB, 2021-01-28:
Hi Yes i had This
I Fitted new D1 and D2 for new BAT 41 diodes ,
and it is reading fine now,
I got the ATU board ready made from a china seller on ebay,
so the diodes that they used are not bat41,
Let us know how you get on with it.
Thanks Dave 2E0DMB

Thread 25 (2020-11-18):

Updating an ATU-100 EXT

alexander-pick, 2020-11-18:
I have got an ATU-100 EXT which is a china build. Trying to update it via the connector seems to fail. The MATLAB X IPE 5.40 gives false positive "programming ok" messages but seems to write nothing and the PICKit3 v3.10 standalone flasher is unable to detect the device. Reading works on none of the both solutions. I try to power the device via the programmer. Is there any hint on the settings required to make it work?

Dfinitski, 2020-11-18:
Hi.
Yes. Try to choose Midrange -> 1.8 Volt MCU core in the PICKit3.10 first.
It is impossible to get false positive message, because a program check written memory after programming.

alexander-pick, 2020-11-18:
Thanks, that was fast! Got it to working and flashed the new 3.1 firmware. Than I did the patches for QRP from the other thread:

simple mode (30=00)
tandem match ratio 1:5 (31=05)
Min. start up power 1W (05=01)
upper power limit 40W (06=40).

This causes my W display to be of by the ratio 1:4? It shows 2.5W instead of 10W etc. Without the changes and on 3.0 it worked fine. Any idea what is wrong?

alexander-pick, 2020-11-18:
Ok, this seems to be based on the tandem ratio. If I change this field the W display is wrong.

Dfinitski, 2020-11-18:
Did you change the tandem-match ratio ? I mean physically, reducing turns to 5 for both sides ?

alexander-pick, 2020-11-18:
What do you mean exactly? So far I just edited the values above in the eeprom. Is anything else (physically) required too?

Dfinitski, 2020-11-18:
See the video in the readme file.
Of course, you must reduce turns on the tundem-match. After that you can indicate correct ration in the firmware for correct power calculation.
What you are doing now just changes calculation formula in the firmware.

sandroatu100, 2020-11-27:
Hi,
I see in the datasheet PIC16F has the sleep mode.
Is it possible to modify the firmware to include this feature?May be with resume at one keystroke.
This would be great for power saving in the field use and, to cancel the rfi irradiation by the cpu.

Dfinitski, 2020-11-27:
Hi.
No sense to save 3mA of CPU power consumption when each relay takes 15 mA.
And your radio also takes 200 - 500 mA in RX mode.

пт, 27 нояб. 2020 г. в 07:44, sandroatu100 <notifications@github.com>:

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

sandroatu100, 2020-11-28:
Hi,
I see in the datasheet PIC16F has the sleep mode.
Is it possible to modify the firmware to include this feature?May be with resume at one keystroke.
This would be great for power saving in the field use and, to cancel the rfi irradiation by the cpu.

sandroatu100, 2020-11-28:
My radio in Rx mode is less of 30 mA and not all the relays may be activated.Also I want to power off the display when not in use,this make sense for Qrp continuos reception.
But, more important, I measured the interference irradiation by the cpu and is very high and goes in the input of the receiver!!
Some digital antenna tuners have this sleep mode and the sleep instruction on the datasheet is easy( page 354).

Dfinitski, 2020-12-01:
Hi. You can power off the display right now, see the manual, cell 32.
What about a sleep mode, it looks like possible, but I am not sure about working algorithm. If the MCU will be in a sleep mode, it could not meassure the input power more, so what criterias to wake up for it ?
One idea looks better - turn on the relays only when input power detected. In this case you could save much more energy while you stay in RX . But in this case MCU should be always in working mode.

sandroatu100, 2020-12-01:
Hi,
ok for the display off.
The criteria may be: after 10 seconds of no operation mcu goes to sleep, than wake up with an interrupt function from pushbutton  ,   but I am not expert with software ( just hardware engineer) .
The sleep also avoid interference from mcu to the receiver , I measured S3-S7 in the receiver depending of frequency.
Rfi is the main issue, the save energy it's also nice.

Dfinitski, 2020-12-02:
I think that is bad idea, every time when you need to change a band click a button ? No, tuner must to work in automatic mode.
I dont agree with you about interferences. I will check it soon and give you result. You can try also with disconected display, probably it is a souce of them.

sandroatu100, 2020-12-02:
The interference come from the cable from mcu to display. I tried to put a ferrite bead and short cable, it's better, but with a receiver sensitivity better of -130 dBm is not so easy to cancel rfi, that's the reason for my question to sleep the mcu.
 I have to try by myself an hardware solution, will keep you informed.

Dfinitski, 2020-12-03:
Sandro, a coaxial fider is not working like antenna, I need more info about your setup to make a conclusion, but I never heard before about RFI from this tuner.
If it will be helpfull, you can use the tuner without any display.

Dfinitski, 2020-12-31:
Hello, Sandro.
Please try the 3.2 version. I have resolved countinious data transfer to a display problem. You can also turn off the display by timer in RX mode, also with all the relays for your choice.

sandroatu100, 2021-01-01:
Hello David.
Thank you for your support. I will try the new version just I'll receive my new pickit 3 programmer.
Happy new year 2021 and stay healty.

PY2BND, 2021-01-10:
> y the 3.2 version. I have resolved countinious data transfer to a display problem. You can also turn off the display by timer in RX mode, also with all the relays for your choice.

Thanks - Very nice feature!!! 73!!

Thread 26 (2020-12-06):

Swr issue

2E0PRV, 2020-12-06:
Hi, I've built the 7x7 kit and it all powers up fine, the power output is spot on but the swr stays on 1.00 and so doesnt tune. An analogue swr meter shows swr as 1.7 but the atu-100 stays at 1.00. Any ideas what ive done wrong or how to solve it would be greatly appreciated 73 de 2E0PRV

Dfinitski, 2020-12-06:
Hi. The reverse voltage line from tandem match is damaged. Check the
soldering. It is easy to forgot make a soldering one side of smd resistor .

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

Thread 28 (2020-12-17):

Difference between PIC16F1938  and PIC18F2520 processors implementation

IK2HEW, 2020-12-17:
Hi all,

I'm really sorry but looking on search engines I wasn't able to find any information about the difference on the two processors implementation. I'm certain that somewhere there will surely be a lot of discussions on this matter but I didn't find them. Please, offering in advance my apologies, is anybody here that can tell me something about ?

Thanks all in advance

Pino, IK2HEW

Dfinitski, 2020-12-18:
Hi.
PIC18F2520 is a pin to pin compartible to PIC16F1938. It is pretty old MCU and it is much easier to find it in some countries.
PIC18F25520 has some disadvantages:
 big price
 10 bit ADC (12 in 1938)
 no internal Reference Voltage Source for ADC, Vdd is using for this purpose instead.

So, highly recommended to use PIC16F1938 in this design.

IK2HEW, 2020-12-18:
Hi,

thank you so much for your exaustive reply, you fully answered my questions and dispelled all my doubts.

Cheers,

Pino, IK2HEW

DL7BJ, 2021-06-21:
> PIC18F25520 has some disadvantages:
> big price
> 10 bit ADC (12 in 1938)

The PIC16F1938 has also a 10-Bit ADC, not 12-Bit.

https://www.microchip.com/wwwproducts/en/PIC16F1938#additional-features

Dfinitski, 2021-06-23:
Hi, DL7BJ.
Glad to see somebody reads what I wrote here.
PIC16F1938 has 10bit ADC and 3 level reference voltage source - 1024, 2048 and 4096 mV. Each changing the ref voltage in twice adds 1 bit to ADC resolution.
In total - 2 bits in additional or 12 bit resolution.

DL7BJ, 2021-06-26:
Okay, that will do the trick ;-) tnx.

Thread 29 (2020-12-17):

all done via pickit2 for 5w. now no display.

07391, 2020-12-17:
All display worked prior to reprograme via pickit.selected for 5w qrp. Programming successfull.Verified.Now no screen.
Any thoughts?
I am new to programming @65yrs so please be kind on any code,Thanks!!

Dfinitski, 2020-12-18:
Hi.
cell 00 to a value of 78, cell 01 to a value of 04, cell 07 to a value of 00, cell 08 to a value of 00
Read the cell description in the manual about theese cells meanning.

07391, 2020-12-18:
DF.

Thanks for cell info ,will check. After visual think its a solder prob.!! Thanks for reply anyway 73.

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

07391, 2021-01-07:
Thanks for info! Works fine. My 1st attempt with surface mounts and also use of pickit.Very pleased with result.Thanks again. Tony Batchford.

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

Thread 30 (2020-12-29):

Atu-109

TA3GT, 2020-12-29:
I completed the kit I just bought the problem is when the voltage is released, the contact stays off and one does not release back so I cannot adjust the swr setting everything was done correctly please help

Dfinitski, 2020-12-29:
Hi.
The capacitor's position relay should be under voltage to compensate the inner inductance and get good SWR.
When the tuner board has no power voltage, the normal SWR 1.5 up to 2 on the upper bands. It is a simple behavior.

TA3GT, 2020-12-30:
How can I take a video and send it to you

Dfinitski, 2020-12-30:
Better check with multimeter which relay is always on.

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

TA3GT, 2020-12-30:
When I energize the system for the first time, will it pull and release the role or it will remain slanted, when it energizes my kit, it pulls to the role and does not let it rotate, even if I try to roost, the roles do not displace I think there is nothing left I can rewind all the coils. sometimes the screen hangs

Dfinitski, 2020-12-30:
I don't understand your question. Did you find what relay stays powered ?

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

TA3GT, 2020-12-30:
No matter what I do, the error is not fixed, sometimes the screen is stuck. One watt five watt tuner not working. Or the problem may be integrated

Dfinitski, 2020-12-30:
Try 50 Watt

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

TA3GT, 2020-12-30:
What I'm doing is just winding the coil, assembling the relay and setting up the screen, everything is ready, I don't even have a small margin of error 🤔 (if the board is okay)

TA3GT, 2020-12-30:
My STATİON qrp yeasu ft-817

Dfinitski, 2020-12-30:
You have to rebuild your tuner for reliable QRP work.
See this video https://www.youtube.com/watch?v=dPys_-_wPcQ
The tuner is not able to work with QRP by default.

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

Thread 32 (2021-01-02):

Low Wattage Reading

jimsl04, 2021-01-02:

jimsl04, 2021-01-02:
I completed the kit version.  The unit seems to function properly, but the Wattage readings don't correspond to the Wattage shown on the transmitter or when connected to another meter.  At 10+ Watts input the device shows ~5.6 Watts.  The unit will not function with an input wattage below 9+ Watts.

could I have wound the dual transformer incorrectly?

Dfinitski, 2021-01-02:
Hi.
Please count how many times a wire goes through core on the tandem-match.
Also, probably installed diodes are not recomended kind.
Check also resistive devider, 34k should be next to processor and 68k should be close to tandem-match.

jimsl04, 2021-01-02:
The primary wires go through 1 time each.  the secondary wires go through ten times each.  Will check the divider asap.

jimsl04, 2021-01-02:
I checked the Resistors.  All correct.  I couldn't tell on thee zeners.  However, While I was checking, it occurred to me that I have ten loops of wire on the outside of the cores, and thus eleven passes through the cores.  Is this enough to cause the problem?

Dfinitski, 2021-01-03:
Yes. Should be 10 passes through the core, not 11.

сб, 2 янв. 2021 г. в 15:32, jimsl04 <notifications@github.com>:

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

jimsl04, 2021-01-03:
Got it.  I'll correct and let you know the result.

jimsl04, 2021-01-03:
Windings now correct.  Same problem exists.  Ideas?

Dfinitski, 2021-01-03:
Please attach a foto of your tandem-match.

jimsl04, 2021-01-03:
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

Dfinitski, 2021-01-03:
Looks good.
Probably there are wrong diodes.
I don't have more ideas.

jimsl04, 2021-01-04:
Right.  I'll just live with it (maybe swap out the diodes later).  I really like the device, and will tell others how great it is and how well you support it.  Thanks for your help.

Jim

Thread 33 (2021-01-04):

Winding the Inductors

RiverPines, 2021-01-04:
I have just received my ATU-100 extended kit but it did not have instructions with it.

I have read the manual and looked at the schematic but nowhere can I find whether the winding direction of inductors L2/L3 and L4/L5 is important - I assume that it is.  Additionally the transformer T1/T2 (for 100 watts) is 1:10 but no mention is made of what the primary winding T1 should be or instead what the secondary T2 should be.   The picture of the board on GITHUB seems to indicate the primary is several turns but the secondary does not seem to be 10 times that.   Could you please clarify if possible

Dfinitski, 2021-01-04:
Hi. Do it as it shown on the picture. Google "tandem match" to learn more
about that.

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

Thread 34 (2021-01-10):

Request for independent Relay OFF Timer from Display OFF timer

PY2BND, 2021-01-10:
The Relay OFF feature on 3.2 version is very nice and I appreciate it a lot! My request is to have a relay OFF time feature independent from the display Off timer and adjustable on cell $36 (Similar as on display OFF time by cell $32, but on a new relay OFF cell $36)

- Thanks a lot for ATU-100 - Mine is working now for almost 2 Years on a outdoor installation - Not any single issue!! - 73

Dfinitski, 2021-01-10:
Hello, Thank you. This feature requires one more counter and its processing, I dont want to touch the code too deep. I find the current logic of power saving is pretty clear to understand. A display does not show anithing helpfull when no input RF power.

Thread 36 (2021-01-19):

Firmware update for Dummies - Is there one?

clsguy, 2021-01-19:
Hi All, I just finished building my atu-100 with version 3.0 and it is working fine. Being an electronics tech really helped.  I would like to update it to ver 3.2.  I can order a pikit3 clone very quickly but I am unsure how to connect it and get started with updating the firmware.
Is there a document out there that would help?
Thanks!

va3rr, 2021-01-19:
The youtube video by IK3SSG should help you out.

[https://www.youtube.com/watch?v=dPys_-_wPcQ](url)

rogerclarkmelbourne, 2021-01-19:
Clicking on that link didnt seem to work for me

https://www.youtube.com/watch?v=dPys_-_wPcQ

clsguy, 2021-01-20:
Thank you for the replies. I reviewed the youtube video which did give me some insight.  I was just wondering if there was something a bit more detailed, like how to backup the current firmware with my 4 line display, how to ensure that backup saved properly etc.  Does the chip have to be erased before updating to the latest firmware? I also noticed there was a voltage setting - does this have to be set for erasing/writing?
These are the details I was looking for, or am I digging in too deep?
Thanks again.

va3rr, 2021-01-20:
clsguy;
You can use the 'read' button on the Pickit3 app to read the 16F1938 and save the hex file to your laptop.
AFAIK, writing to the 16F138 will write over whatever is there.  I didn't bother to erase mine, but just overwrote it.

N7DDC de VA3RR.  David, the new 3.2 firmware works great with cheap Aliexpress IIC OLEDs (SSD1306).  I used to get odd characters with the 3.0 firmware, but no more.  Spasibo

Dfinitski, 2021-01-20:
clsguy, you have to start to do something and ask specific questions.
If you would to know how to program PIC controllers in general, you can find a lot info in the Google search:
https://www.google.com/search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

amsnl, 2022-11-29:
i see the video and the chance to QRP mode and i know to set it in auto tune but hoe to update the firmware to 3.2 i cant find it alsi the files are triki to use some file dont have hex exetion but nothing or zip what say its damage

please help

Dfinitski, 2022-11-29:
The hex file inside zip file, it's not damaged.

amsnl, 2022-11-30:
i cant unzip it it say empty

amsnl, 2022-11-30:
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
like you can see

Dfinitski, 2022-11-30:
Unknown format. Is that Windows ? What kind? Usually Windows opening zip by default.
Anyway, install some free zip archiver first.

Thread 37 (2021-01-23):

ATU-100 extended 7x7 display not working

CurtissP40, 2021-01-23:
I have just finished building 7x7 ATU-100 with mini display, display initially worked but no screen now. Have not updated firmware, ATU is working, can hear relays clicking. Is this available as a spare part?

Dfinitski, 2021-01-23:
https://www.ebay.com/itm/1-3-Blue-White-OLED-LCD-4PIN-Display-Module-IIC-I2C-128x64-for-Arduino-SH1106-/293872378812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

Thread 38 (2021-01-24):

Strange power indication

diygoodies, 2021-01-24:
Hi I have N7DDC 7x7 tuner and [ SW2013 mini transieveк](http://www.diygoodies.org.ua/?p=1377)and  [windom antenna](http://www.diygoodies.org.ua/?p=1506). Transiever has 14-15W of full power in all bands so I expect from tuner indication of same power value, but all that I get discribed in flowing table.

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

I tryed BAT41 diodes with windom antenna, and 1N5711 diodes with windom antenna and then 50Ohm dummy load.
As for now I can't understend why Power indication is so low, and why Power indication is so non liniar when antenna is connected?
Here is a picture of my transformer
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
Whaiting for advice. Thanks!

mike-hb, 2021-01-26:
What about reducing the secondary winding down to a few turns -- the sensivity of the power bridge is increasing.

diygoodies, 2021-01-26:
> What about reducing the secondary winding down to a few turns -- the sensivity of the power bridge is increasing.

But what about non liniar mesurments on real antenna?

mike-hb, 2021-01-27:
Non-linear measurement results occur when measuring with low power. Your table shows only small deviations of the SWR between your two measuring devices (columns 1 and 2) only slightly above the minimum power threshold of 5 W -- Could this be the reason? What did you expect when using different rectifiers? As described in the manual, one can find out, that there is a correction of the measured values. (V 3.2 in main.h line 42-60 correction is performed with a step function with 14 steps over the full range) This implies one special type of diodes.

Hope this helps
Michael

Thread 39 (2021-01-25):

ATU-100 took itself out of Auto Mode Ver 3.2

sparkey2450, 2021-01-25:
David,
I received my new ATU-100 and it indicated it was programmed with version 3.2. I put it online and it booted in Auto Mode. Did a couple of tunes on 40 and 20 meters at low power. Worked OK. Once I ran a tune I increased the power to 100 watts in CW. The unit at this level tried to do a tune again as I could see the VSWR jump on the Ameritron Swr meter and could hear the relays being manipulated.  Every time I keyed the transmitter it would try and retune at this high power level. It would fine a tune and stop tuning. Then I noticed that the period was gone on the display and the unit had taken itself out of auto tune. I have not experienced this in version 3.0. Since there is only one button on this unit I could see some one getting a tad irritated. I'm going to open up the unit and get a look at the construction and also get a copy of the firmware installed.  Just thought you might want to know. Not a big deal here as I plan on using one of the earlier versions. I believe the unit came from China.

Steve W8TTY

sparkey2450, 2021-01-25:
David,
I think I know the problem. The company selling these have you order it with or with out the Auto and By-pass buttons. After opening the case I found two nice little antennas connected to those inputs of the processor. I'm going to remove those wires and retest the unit. This units has wires that are too long. Poorly wired.
Steve W8TTY

Dfinitski, 2021-01-25:
Hello, Steve
Try to power on your chinese ATU with pushed down Tune button.
Most likely you will see a short menu to control main parameters.
Chinese firmware is little bit different then mine.

sparkey2450, 2021-01-26:
David,
Tried the power up with the tune pressed. Went to Fid_loss. No menu. I cleaned up the wiring, removed those two loose wires (Little antennas in side the box) they had attached to the By-Pass and Auto button, put a twist in the DC Power wires. shortened the excessive wire.  Fixed the problem. This can be closed. Thanks for the advice on the power up. They are also using the following PIC16LF1938  for the processor. They had some of that excess wire right on top of the toroid's. You get what you pay for. Thanks again. By the way I figured out where all those conversion numbers came from in conversion(). Takes me a bit longer now days but I eventually get to the right place. Have a great day.
Steve W8TTY

Dfinitski, 2021-01-26:
Hello, Steve
PIC16LF1939 can not be powered by 5 Volts
1.8 - 3.6 is the normal voltage range.

пн, 25 янв. 2021 г. в 18:23, sparkey2450 <notifications@github.com>:

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

Closed 2021-01-26.

Thread 40 (2021-01-27):

Feature request for tuning in the low power range below 1 W

mike-hb, 2021-01-27:
For low-power operation, e.g. for WSPR with less than 1 W, I suggest to introduce a low-power factor -- perhaps in cell 37.

This way also powers below 1 W can be set for the variable "min_for_start". This allows tuning at the low available power of a QRP-WSPR-TX.

There is already a setting for high power in cell 30. Maybe the setting for low power can also be made there with a changed parameter "-1". - Of course the program and the calculation of the power must be adapted...

Dfinitski, 2021-01-27:
Hello, Michael
I thing with current schematic it is impossible.
You can try to use AD8361 as a linear RF detector.
You can set it up like 1W = 10W in the tuner firmware and use it as is with no changes.

mike-hb, 2021-01-30:
dear David,

thank you for the quick reply.
Your suggestion with the AD8361 is the Gold standard!
But if we look on the momentary layout, I think that by 2 measures yet a rudimentary possibility for tuning is available. Therefore I would like to specify my suggestion.

Currently the problem is that by tuning temporarily the displayed power falls below 1 W and then the tuning process is terminated prematurely.

A good possibility for this would be if the tuning limit could also be set in steps of 0.1 watts. This is currently not possible. On the other side in main.h in the lines 122 to 128 in the function get_pwr the measurement result is adjusted by multiplications and divisions. My suggestion was to influence it in dependence of a memory cell, eg 30 odr 37 these factors to use in this way also powers below 1 W for the adjustment.

On the other side the transformation ratio has to be adapted. Here one must be careful of course not to let the losses become too large by the measuring.

The shottky diode has a low threshold voltage, but with changed transformer ratio it might be enough... For example: 1 W is 10 V peak on 50 ohm and with transformer 5:1 it is 2 V (the BAT40 has a threshold from 150 mV up) -- this is an error of up to 5 to 10 %. -- This will be sufficient for my purpose. And when we reduce the power, the error will increase.

What do you think about that?

hope this brings us forward to the use at low power

vy73
Michael, DK5HH

Dfinitski, 2021-01-31:
Hello, Michael
You forgot a devider 1/3 after rectifiers in your calculation.
As an experiment, you can set a turn ratio more then actual and  tuner will think that input power is more then actual.
Check if the tuning process works good with 1W input power.

mike-hb, 2021-02-01:
Dear David,

Thanks for the comment.  You are right. The voltage divider was not in my calculation.

But, as I read the circuit diagram, the divider divides the rectified RF signals, which means DC -- so the rectifier has the higher RF voltages from my calculation and by the ohmic 1/3 divider the above mentioned errors of the "knee" threshold voltage will be reduced by factor of 3. -- This supports my idea of the low power tuning range for an experiment.

I checked my tuning of the antenna impedance here -- the atu works perfectly with power just above the 1 W (as mentioned in the discussions in another thread here, the tuner needs twice the minimum power level for correct tuning. My experience is: mostly 1.2 to 1.5 W will does it as well.

In these experiments I missed the option to decrease the minimum power level down to 0.5 or 0.3 Watt to measure at these levels around and below 1 W.

vy73
Michael

lu1aax, 2021-07-29:
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

Did you try setting min power to 0? It worked good for me and the side effect of tuning on no power input is not that bad...

Thread 41 (2021-01-28):

Ready Built ATU-100-extended-board reading high swr reading over 14mhz

2E0DMB, 2021-01-28:
Hi Great atu ,and info from you David,

I got a ready made board off ebay for the same price as a kit,
i re-programmed it and set the tandem match to 5 turns as i want to use it with my uk mil radio Clansman PRC320
That puts out up to 30w output but the foldback is to fast,
Now i have set it to work from 1w all is good,
But after 14mhz The swr reading was going up the higher you go up in frequency if i set 25 ohm it should read near swr of 2:1 but it was reading over 3-5:1 the higher you go,
So i replaced the sensing diodes with BAT41 and all is now correct ,
so i do not know what was fitted but they were not bat41,
so if anyone is having the same problem, i would change the sensing diodes before doing anything else
Thanks Dave 2E0DMB

Arm-D, 2021-06-01:
I can confirm the production issue with the diodes. Bought a kit with preassembled SMT components from Aliexpress. The diodes were marked "B66" and they are definitely not suitable for this purpose. 14MHz and up the tuner did not work as expected. After replacing the diodes with BAT41 the problem is gone and tuning up to 50MHz works fine. Also the power measurement gives now reasonable values across the whole frequency range.

Dfinitski, 2021-06-01:
Hi. That is expected.
Also, torroid cores from China have large losses and become hot very fast.

2E0DMB, 2021-06-01:
Thank you for your reply
Great all is now ok
Thanks Dave 2E0DMB

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

frankliao84, 2021-07-28:
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

you mean core for tandem matching or the inductors. Maybe they are not what are in the BOM of your document list?

Arm-D, 2021-08-02:
The China core for the SWR-bridge seems to be of good quality. I have replaced it with a genuine BN43-202 and there was no difference at all.
While bulding the kit I have measured the inductance of the matching inductors. All were close to the specified values, so the core material seems to have the correct permeability. Not sure about the losses, I have to doublecheck to see if they heat up more than expected.

Thread 43 (2021-02-07):

What is the max SWR this tuner can handle?

psabbag, 2021-02-07:
I couldn't find this information anywhere.

Does someone knows what is the max SWR this tuner can handle?

Thanks,
73,
Pablo, VA3HDL

Dfinitski, 2021-02-07:
Hi, Pablo
I never heard about broken tuner due to high SWR.

Dfinitski, 2021-02-07:
I heard in some conditions the MCU firmware has been spoiled and required reflashing.

psabbag, 2021-02-07:
Hi David,

Maybe my question isn't clear.
I have an MFJ-939 Automatic Tuner that can handle 32:1 SWR mismatch, that is 1600 ohms to 50 ohms, matching impedance.

My questions is what is the maximum matching impedance the ATU-100 7x7 can handle?
10:1 ? (500 ohms)
20:1 ? (1000 ohms)
etc.

Thanks,
73,
Pablo, VA3HDL

va3rr, 2021-02-11:
Pablo - the mismatch any tuner can handle is frequency dependent.  This tuner can only switch in a total of 8uH, so on 160 metres, it's range is quite small.

Here's a webpage where you can plug frequency, source and load impedances for an L-network, keeping in mind that only the two first network configurations (low pass) are valid for this tuner...

https://leleivre.com/rf_lcmatch.html

psabbag, 2021-02-11:
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

Thank you

Dfinitski, 2021-02-11:
Pablo, now I got you.
What handle - usually used as what handle before be brocken :)
Matching edges for each bands you can find here and also the Python script, you can run it on your PC:
http://www.cqham.ru/forum/showthread.php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

Dfinitski, 2021-02-11:
English conversation
https://groups.io/g/ATU100/topic/computer_simulation_model_for/80572292?p=,,,20,0,0,0::recentpostdate%2Fsticky,,,20,2,0,80572292

psabbag, 2021-02-12:
Excellent, thanks David ! The charts are bigger in the English version. Also I couldn't run the Python script on my computer. For some reason I'm having trouble with the smithplot library:

Traceback (most recent call last):
  File "D:\Download\Radio\ATU-100_7x7.py", line 10, in <module>
    from smithplot import SmithAxes
ModuleNotFoundError: No module named 'smithplot'

I'm not sure what I'm missing. There is no smithplot library to install.

Thanks again
73,
Pablo, VA3HDL

Dfinitski, 2021-02-12:
Hi Pablo
Probably you need https://pypi.org/project/pysmithplot-fork/

чт, 11 февр. 2021 г. в 16:07, Pablo Sabbag <notifications@github.com>:

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

psabbag, 2021-02-12:
That worked, but now got a different error:

`freq = 1820000
Traceback (most recent call last):
  File "D:\Download\Radio\ATU\ATU-100_7x7.py", line 53, in <module>
    ax = pp.subplot(1, 1, 1, projection='smith')
  File "C:\Users\psabb\AppData\Local\Packages\PythonSoftwareFoundation.Python.3.9_qbz5n2kfra8p0\LocalCache\local-packages\Python39\site-packages\matplotlib\pyplot.py", line 1142, in subplot
    ax = fig.add_subplot(*args, **kwargs)
  File "C:\Users\psabb\AppData\Local\Packages\PythonSoftwareFoundation.Python.3.9_qbz5n2kfra8p0\LocalCache\local-packages\Python39\site-packages\matplotlib\figure.py", line 1402, in add_subplot
    ax = subplot_class_factory(projection_class)(self, *args, **kwargs)
  File "C:\Users\psabb\AppData\Local\Packages\PythonSoftwareFoundation.Python.3.9_qbz5n2kfra8p0\LocalCache\local-packages\Python39\site-packages\matplotlib\axes\_subplots.py", line 42, in __init__
    self._axes_class.__init__(self, fig, self.figbox, **kwargs)
  File "C:\Users\psabb\AppData\Local\Packages\PythonSoftwareFoundation.Python.3.9_qbz5n2kfra8p0\LocalCache\local-packages\Python39\site-packages\smithplot\smithaxes.py", line 374, in __init__
    Axes.__init__(self, *args, **SmithAxes.update_scParams(instance=self, filter_dict=True, reset=False, **kwargs))
  File "C:\Users\psabb\AppData\Local\Packages\PythonSoftwareFoundation.Python.3.9_qbz5n2kfra8p0\LocalCache\local-packages\Python39\site-packages\matplotlib\axes\_base.py", line 511, in __init__
    self.cla()
  File "C:\Users\psabb\AppData\Local\Packages\PythonSoftwareFoundation.Python.3.9_qbz5n2kfra8p0\LocalCache\local-packages\Python39\site-packages\smithplot\smithaxes.py", line 477, in cla
    self.grid(b=self._get_key("grid.%s.enable" % grid), which=grid)
  File "C:\Users\psabb\AppData\Local\Packages\PythonSoftwareFoundation.Python.3.9_qbz5n2kfra8p0\LocalCache\local-packages\Python39\site-packages\smithplot\smithaxes.py", line 1064, in grid
    for xs in np.linspace(x0, x1, x_div + 1)[1:]:
  File "<__array_function__ internals>", line 5, in linspace
  File "C:\Users\psabb\AppData\Local\Packages\PythonSoftwareFoundation.Python.3.9_qbz5n2kfra8p0\LocalCache\local-packages\Python39\site-packages\numpy\core\function_base.py", line 120, in linspace
    num = operator.index(num)
TypeError: 'numpy.float64' object cannot be interpreted as an integer`

Dfinitski, 2021-02-12:
A bug in the numpy, you will need *pip install numpy==1.16.6 --upgrade*

чт, 11 февр. 2021 г. в 16:40, Pablo Sabbag <notifications@github.com>:

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

actionwatcher, 2021-02-17:
Hi David,
A related couple of questions. I have a very high SWR on both 3.5 and 7 MHz. On 3.5 the tuner generally can be tuned manually but automatic mode usually does not find the tuning point. On 7 Mhz it tunes most of the times but not all the time. Is it expected behavior for the high SWR loads?
Second question: Do torroids' temperatures depend on the load Z? On 7 Mhz the higher inductance torroids become extremely hot with just one 100 watt CW QSO ~10 minutes. From my brief experiments it can sustain ~ 10-20 watt of CW QSOs in open enclosure. I am not sure about the quality of the torroids (as the kit was from eBay) on the other hand the torroids look a bit small for the 100 watt. The torrid sizes are per your specs and inductance measured prior installation was reasonably close your specs.  Do you recommend replacing torroids with known quality of the same size or increasing the size of the torroids?

Thanks! 73! Arkady/NU6N

va3rr, 2021-02-17:
Arkady - from whom did you buy your ATU-100?  Some sellers are not providing genuine Micrometals T68-2 cores.  Perhaps low Q is the reason for your inductor heating?

[https://owenduffy.net/blog/?p=11873](url)

actionwatcher, 2021-02-17:
That is my suspicion also. I got my kit from ronoe_1231. The seller was quite responsive and stated that kit came from China. The seller is from US. Thank you for the reference!
> Arkady - from whom did you buy your ATU-100? Some sellers are not providing genuine Micrometals T68-2 cores. Perhaps low Q is the reason for your inductor heating?
>
> [https://owenduffy.net/blog/?p=11873](url)

Thread 44 (2021-02-11):

operating limits

BC-348, 2021-02-11:
My ATU 100 EXT works up to about 30mhz. Should it go up to 50? Is there anything I can do?

BC-348, 2021-02-11:
> My ATU 100 EXT works up to about 30mhz. Should it go up to 50? Is there anything I can do?
Regards, Riccardo.

Dfinitski, 2021-02-11:
Hi.
No any limits for frequency, but for 50 MHz the internal capacitance and
operating step is too high.

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

Thread 45 (2021-02-13):

Future Board Layout

sparkey2450, 2021-02-13:
David,
Hope all is well on your end. As you know I've been using your 7x7 Board to write code under MpLabs IDE. I find MpLabs MCC very useful. Anyway to the point. I got where I was configuring the PIC I2C Interface using MpLabs MCC to talk to a Raspberry Pi. MpLabs MCC assumes the PIC code will use pins RC3 and RC4 for the I2C communications instead of the pins you laid out, RB6 and RB7. MpLabs expects the programming tool to be connected at RB6 and RB7. So if you are ever contemplating a board revision might want to keep that in mind. I know I can go in and massage the MCC code to use the other pins. But it would have been nice to keep the debugger hooked up while the code was being developed. I purchased a populated board only so I'll look and see how much trouble it would be to re-rout some traces.  Thanks Dave.
Steve (W8TTY)

Dfinitski, 2021-02-13:
Hello, Steeve
This project uses software I2C, you dont need to care about hardware I2C settings.

sparkey2450, 2021-02-13:
OK. But under the MpLab MCC System when you select  the I2C Library they configure the PIC to use Pin RC3 for the Clock and RC4 for the Data. The compiler you are using is $250. The MpLab System is Free.  If you ever wanted to have this board compatible with the MpLab Compiler and MCC Code Generator would it not be better to have the MpLab System work without having to massage the code it generated. I understand how I2C works.  If in the future you are making board layout changes might be something to consider. That's all I'm saying.

rogerclarkmelbourne, 2021-02-13:
@sparkey2450

Even better, change to a processor that uses GCC

sparkey2450, 2021-02-13:
David,
If you look at the spec sheet for the 16F1938, they are specifying pins RC3 and RC4 for I2C Communications. RB6 and RB7 for the in circuit debugger.
Steve (W8TTY)

sparkey2450, 2021-02-13:
Roger, I' started using this because I was interested in putting a Tuner out at my antenna.  David's code works well when you put it n Auto. And you can stick his board out there at the end of the coax. I wanted to do some control from the shack and put this on the WiFi. This the reason I started hacking at this.  The board is very reasonable. I got sticker shock when I looked at the cost for the compiler David was using. This is when I started to port this over to MpLabs Freebee.

Dfinitski, 2021-02-13:
Steve, again, I2C works independetly to compilators.
You dont need to use any compilator's options. Check again the Software_I2C.c

sparkey2450, 2021-02-13:
David,
Your missing the point. The developer of the chips does not want I2C Communication on those pins. It has nothing to do with the protocol. Please read the chip specifications.  I can drive backwards in my car all day long but that's not how the car is designed.

rogerclarkmelbourne, 2021-02-13:
@sparkey2450

Yes. I know it works well.

I did start designing a board myself using a cheap ARM based processor, and also looking at using something like a ESP32 module instead of the PIC, using KiCAD.

But my other commitments made me shelve the project until later this year.

sparkey2450, 2021-02-13:
Roger,
Well David's Board appealed to my lazy side. My original thought was use a roller inductor and variable capacitor. But then I found this ATU-100. I stripped out all the code that did not pertain to my exact setup. David has lots in there to support many different items. I wanted something simple. Just match the antenna to the coax at the antenna and allow me to see and control from the shack.

rogerclarkmelbourne, 2021-02-13:
Yep.
I built a Chinese kit and it worked well.

I then bough another Chinese kit with the intention of removing the PIC and connecting another processor via some flying leads

Unfortunately that kit was missing a relay :-(  , and it was not possible to get the supplier, in China to resolve the problem, because they never admit a fault in what they send you.

I also bought a bare 1kW PCB from a Russian vendor on eBay, but it took 4 months to arrive, due to the pandemic, and by the time it arrived, I had too many other projects underway

I've been analysing board layouts from various manufacturers and trying out various layouts in KiCAD

e.g.

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

Looking at improving the SWR when the ATU is not enabled, by reducing the track distance etc

But I have a lot of work with my day job and other ham radio related projects, and don't currently have time to continue with this.

Dfinitski, 2021-02-13:
Steve, my I2C code works with any pins of MCU, it does not use hardware I2C module. There eare some important reasons to do this.
You dont understand what is software I2C, really ? Software SPI ? You should to know what is this if you program MCUs.
Check again the code, no any proprietares calls for I2C are used. All the calls are built-in.

sparkey2450, 2021-02-13:
David,
I'm not going to argue about it. But here's the deal. When you run I2C on pins RB6 and RB7 you are not following the manufactures recommendations. I did not design the processor but the manufacture has indicate where the programmer should configure IC2 communications, which is on RC3 and RC4  They want to reserve pins RB6 and RB7 for the in circuit debugger. Not talking to an OLED.  That's great that it works. love it. But its not standardized. Therefore it causes problems  when trying to use a system like MpLabs which follows the standards. I thing you did a great job. But standards are there for a reason.

sparkey2450, 2021-02-13:
Roger,
I bought one complete box from China. Looked like a 6 year old wired it. Like I told David. I have a bare board and will look to see how much trouble it is to move the I2C Communications. This means I have to rewire two capacitors also to different pins. Then I can use the in circuit debugger. The code I have now has no OLED, Test Software, etc. Its strictly set the power to tune, key the tx, let it tune, when its done, move the power up to operate. The code compiles using MpLabs IDE and XC8.  There are a number of things that need to be changed because the MikroC Compiler uses some functions that are not portable across platforms.  The other thing I can do is just use the MpLabs IC2 configuration and massage it to use pins RB6 and RB7. I'll eventually figure it out. I would much rather be able to connect the PicKit 3 and use the debugger on the PIC and then watch the raspberry pi code. I was going to stick with MickroC but when I finally figured out how to use MpLabs MCC generator, it really makes the configuration a piece of cake. You can concentrate on writing the application instead of trying to figure out how to setup the chip. MCC write everything you need to work with the processor without all the head aches of configuration.

rogerclarkmelbourne, 2021-02-13:
@sparkey2450

I built mine from the kit, very carefully ;-)....

I understand what you mean about the pins that David chose to use for I2C (which from what I gather is software I2C).
I presume David chose to use those pins to make the PCB layout easier, but prevents you using the in-circuit debugger.

I mainly use ARM based MCU's and only have an older PicKit2, which is not compatible with this PIC :-( :-(

I'm loathed to buy a PicKit3, just for this, and my intention was to remove the Pic from the 2nd kit I bought and probably initially port the code to something like a STM32F103 aka "BluePill" board.

BTW.

I had a look at David's tuning code, but I didn't have time to understand the algorithm, or even if there is a full algorithm involved.

I found another ATU project which is very similar, (Sorry I can't find the link at the moment), and the guy went into great detail about an efficient algorithm based on a 2 dimensional matrix of readings, which iteratively reduced the size of the L and C it was switching in and out, to get to the optimal tune point very quickly.

However, although the guy posted some information, he chose not to post his code.

I understand the guy's decision, as I get quite jaded by spending a huge amount of time doing research and then writing optimised programming, only to find that someone takes the code and uses it in their commercial or open source projects in breach of the copyright conditions on my code etc.

I'm sure its been a double edged sword for David with the Chinese banging out these kits, as it leads to a load of dumb-ass support questions in this repo, rather than anyone actually contributing.

Dfinitski, 2021-02-14:
Steve, RC3 and RC4 are reserved to use **by hardware I2C module** because it is restriction, not a standard. Hardware modules can not physically use any MCU pins. Each hardware module has own dedicated pins which working with it.
But I did not use MSSP module in my design, because:
1) No free pins to use them only as I2C bus
2) OLED display is an option, normally a tuner should to work close to antenna in automatic mode.
Initially, LCD 2*40 was added to help  debug the code, to show some register info.
3) Software I2C realisation allows to work safely with errors on the bus and also with/without LCD/OLED, wrong address device, collisions, RF interferences.
Hardware realisation with MSSP module requires much more details to reach this, interrupt control and timer count using.
Bad code could to tight processor easy.
My code is not using interrupts and timers, except WDT timer.

>  I found another ATU project which is very similar, (Sorry I can't find the link at the moment), and the guy went into great detail about an efficient algorithm based on a 2 dimensional matrix of readings, which iteratively reduced the size of the L and C it was switching in and out, to get to the optimal tune point very quickly.

Probably I have tried all existing cases in the algorithm. Some cases work really fast but only with some kinds of loads - when L or C is 0 an example, but the real problem to find an algorithm wich works good with all the kind of loads. Unfortunatelly those ones are not to fast as I wanted. I was forced to iterate over and flexibly configure some constants because simple mathematic model does not work as expecpted.

sparkey2450, 2021-02-14:
Roger,
I did not pay too much for the Pickit3. I got it on Amazon.  I started out looking at this from the automatic stand point but as I got into this I started to think why automatic? The purpose is to match my antenna to my setup. So although I've got the automatic portion working once I get this to interface to something in the shack and can control the ATU from there. Then I will just setup a block of memory where you put in the L and C Values you need to match the antenna on that band and select them as you need them. Some times the simplest answer is the correct one. I have an MFJ 939 that puts the tuning values into memory. In their case they also read the frequency . So once you key the TX it goes back and sees if there is a match for this frequency and then just plops in the values needed.  I'm looking at this more as a replacement for a manual tuner that you control from the shack.

rogerclarkmelbourne, 2021-02-14:
@sparkey2450

Australia has Amazon in name only.
They carry virtually no local stock. I don't normally waste my time looking on Amazon.com.au
However, I just had a look, and there were only 3 listed, starting at $28 inc shipping, all from China, the most expensive was $255, but had free shipping ;-)   Standard delivery time was in April, fastest was the end of March.

There are some vendors on eBay, who claim to have local stock, but often this is BS, and they charge full price and the just try to drop ship from China, which never turns out well

So I don't think I'll bother.

sparkey2450, 2021-02-14:
Ok Roger. Nice chatting.

rogerclarkmelbourne, 2021-02-14:
@sparkey2450

No worries.

sbridger, 2021-11-15:
@rogerclarkmelbourne
    trying out various layouts of my own in KiCAD

Could you share your Kicad?
I need to make a specific PCB form factor, and the schematic and footprints would save me a bit of time.
thx

Dfinitski, 2021-11-16:
I did not use Kicad. But you can try to export to Kicad from Easy EDA.

sbridger, 2021-11-16:
> I did not use Kicad. But you can try to export to Kicad from Easy EDA.
I meant Roger's kicad version...

So the ,lay6 file is easy eda, with the schematic embedded?

No luck trying with https://wokwi.com/tools/easyeda2kicad
or https://easyeda.com/editor

Dfinitski, 2021-11-16:
No. Lay6 is a Sprint Layout 6 file.

Closed 2021-02-14.

Thread 46 (2021-02-18):

Problema

Celta1960, 2021-02-18:
Hola amigos, tengo un problema el cual no se a que es debido en ver 3.0.Funcionar funciona a la perfección pero en ciertas frecuencias y todas las bandas me da una señal fuerte hasta el punto de no poder utilizar en esos Mhz.
     Adjunto fotos con el puesto y quitado. A que es debido?
     Un saludo
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

Dfinitski, 2021-02-18:
Hello, Celta1960

New in the version 3.2
Fixed bug with continuous data transfer to the display.

So use 3.2 version of firmware.

To check this out, disconnect the display and try without it.

Celta1960, 2021-02-18:
Hola Dfinitski, probare a instalar la versión 3.2 y comentare si se corrigió el pequeño fallo.
   Un saludo

Celta1960, 2021-02-18:
Gracias amigo probare la 3.2.Un saludoEl 18 feb. 2021 7:37, David Fainitski <notifications@github.com> escribió:
Hello, Celta1960
New in the version 3.2
Fixed bug with continuous data transfer to the display.
So use 3.2 version of firmware.
To check this out, disconnect the display and try without it.

—You are receiving this because you authored the thread.Reply to this email directly, view it on GitHub, or unsubscribe.

Celta1960, 2021-02-18:
Hola de nuevo, con la pantalla apagada o desconectada sigue igual, sera cosa de cambiar el firmware?.
Saludos
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

Dfinitski, 2021-02-18:
I think that is bad power supply for the tuner board. Try to feed it with
batteries, temporary for the test.

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

Celta1960, 2021-02-18:
No creo que radique el problema en la alimentación ,ya que solo es en determinadas frecuencias fijas en las demás perfecto, no optante probare para salir de la duda.
   Saludos

Thread 47 (2021-02-22):

atu-100 and fast test mode

lotrdocker, 2021-02-22:
Hi all,

I activated the fast test mode (Power+Tune+Bypass+Auto) but I don't understand the result. On internet I found nothing more that how to activate this mode, is it possible to have more details ?

Thank in advance.

Regards.

va3rr, 2021-02-24:
Fast test mode powers all the relays at the same time.

Simple test mode allows you to step though the inductors and capacitors...

Dfinitski, 2021-02-24:
Bypas / Auto - + / - step value
Long Tune - change L or C for tuning
short Tune - change C connection, before L or after L

Thread 49 (2021-03-08):

HELLO FRIEND RECENTLY I ACQUIRED THE ATU-100 EXT BORD, I UPADATE WITH PCKIT3, FROM FIRWARE 3.2. PLUS THE ATU-100 DIDN'T WORK ANYMORE, YOU CAN HELP ME ..  THANKFUL ...

GRAZIANNY, 2021-03-08:

GRAZIANNY, 2021-03-08:
HELLO FRIEND RECENTLY I ACQUIRED THE ATU-100 EXT BORD, I UPADATE WITH PCKIT3, FROM FIRWARE 3.2. PLUS THE ATU-100 DIDN'T WORK ANYMORE, YOU CAN HELP ME ..

THANKFUL ...

Dfinitski, 2021-03-08:
Hi. You have to configure firmware cells according to display configuration of your tuner. See the cell's description at the end of manual.

GRAZIANNY, 2021-03-08:
OK FRIEND, YOU WOULD HAVE THIS HEX FILE READY, MY WAS VERSION 3.0 OLED DISPLAY ..
MY PICKIT 3 PROGRAMMER, SERVES TO UPDATE .. YOU KNOW WHAT SO CURRENT SOFTWARE IS IT ... THANKFUL. ,,

GRAZIANNY, 2021-03-08:
VYOU HAVE E-EVIL TO CONTACT ,, GRATEFUL ....

GRAZIANNY, 2021-03-08:
E-MAIL

Dfinitski, 2021-03-08:
dfainitski@gmail.com

пн, 8 мар. 2021 г. в 13:42, GRAZIANNY <notifications@github.com>:

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

Thread 50 (2021-03-25):

After tune, during TX ATU auto switch to Bypass mode and back to normal

scalpya, 2021-03-25:
Hi
I biuld Atu 100 7x7 external board few days ago. Its so fast and small atu. I discover some problem. When i tune on any frequecy, and i try make some qso and start talking atu after few secunds swtch to Bypass mode and antena not in tune, SWR rise, after another few secunds back to normal and working like this in loop. I no idea where is some problem.

Thanks

Dfinitski, 2021-03-25:
Hi.
The most likely this is RF interferences. Reduce a wire length to OLED, buttons to minimum. Install 0.1 uF caps to additional buttons pins and ground.

scalpya, 2021-03-27:
> Hi.
> The most likely this is RF interferences. Reduce a wire length to OLED, buttons to minimum. Install 0.1 uF caps to additional buttons pins and ground.

Thanks, Working now.

Closed 2021-03-27.

Thread 51 (2021-03-29):

Power Accuracy

ewagnerjr2000, 2021-03-29:
Hello, i have updated to 3.2 and i have noticed some power accuracy issues. For example 20 watts on my IC-7100 shows 16 watts,  50 watts shows 40 watts on the atu-100 and 100 watts shows 65 watts on the atu.  Just seeing if this is normal?

Thanks,
Ed

Dfinitski, 2021-03-30:
Hi.
No, that is not normal and changing a version does not affect power
measurement accuracy.
Except the case if you have changed cell 31.
So first of all check if the actual turn ratio of the tandem match is
matched to cell 31.

пн, 29 мар. 2021 г. в 08:56, ewagnerjr2000 ***@***.***>:

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

zelea2, 2021-04-09:
I don't get how to calculate the max power for a given transformer ratio.
The PIC max range is 4.096V. The resistor divider is 1:3 and this brings the range to  12.288V. The rectifing diode is an extra 0.4V to 12.7V. The tandem match ratio reduces the line voltage N times so for 1:10 we have 127V in the line. Power in a 50ohm impedance is P=U^2/Z = 322.6W. For QRP 1:5 tandem match ratio P=80.6W. Is there an extra divide by 2 because only half of the sine wave is averaged?

Dfinitski, 2021-04-09:
Hi. Read here

https://github.com/Dfinitski/N7DDC-ATU-100-mini-and-extended-boards/issues/17

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

zelea2, 2021-04-09:
I forgot to divide by sqrt(2). The measured value by the PIC is the peak value not the V(RMS). Thanks for the pointer.

w0ati, 2021-08-07:
Can I ask what code revision you were running before updating to 3.2? I have also had the accuracy problem you mentioned.

Thread 52 (2021-04-05):

Massive Interference

HB9HIL, 2021-04-05:
Hello Guys
I have the problem my ATU-100 does massive Interference on my radio. I tested with a dummy load. Between S5 and S9+ is way too much. Where could be the problem? I’ve bought this one assembled from Amazon. Disconnected the internal battery, display and charging regulator. Nothing changed... Some experience with it? Saw the same interference on a YT video on 6 meters but it’s damn hard to find a solution. It seems to be the china version and maybe it’s the IC (PIC16F1938). But before I start soldering, maybe it's a good idea to ask here.

HB9HIL, 2021-04-05:
Maybe I should say as well. I just updated to 3.2. Nothing changed.

Dfinitski, 2021-04-06:
Hello.
Strong interferences even without battery (power on the board) ? Check connecting cables, probably no ground connection.

HB9HIL, 2021-04-06:
Sorry. For sure with power. Butbit doesn't matter if I use a Car Battery, a power supply or the internal battery.

Dfinitski, 2021-04-07:
I can only guess you have chinese 5 Volts version of the tuner with step UP/Down power converter.
Check the relays, are they 5 volt versions ?

Thread 53 (2021-04-17):

Different Power Reading On Display

PartyRock916, 2021-04-17:
When I run 100 watts of transmit power and press the Push To Talk button on my Yaesu FT-891 radio, the ATU-100 says the following on the display:

PWR = 50W
SWR = 1.19
ANT = 36W
EFF = 71%

I also get the following readings after I release the Push To Talk button:

L = 0.45 uH
C = 100 pF

Question: How come I'm not running the full 100 watts and only 50 watts as seen on the display? How do I increase my EFF % as well?

Thank you in advance for your help.

pimol, 2021-04-17:
Which mode? Only FM or digital arrives to full use of power, actual power depend from voice mean value...

Pietro I2OIM

PartyRock916, 2021-04-17:
> Which mode? Only FM or digital arrives to full use of power, actual power depend from voice mean value...
>
> Pietro I2OIM

SSB. On 20 Meters.

pimol, 2021-04-17:
Atu computes a few db for the line losses, I dont remember how many. But SSB can't go over 60/70% of the power for a linear amplifier or transmitter. So don't worry about how many they are, try to have te max you can.
Try with FM mode to see eff power, if your TX is able to. Or with tune key if any.
Pietro

PartyRock916, 2021-04-17:
> But SSB can't go over 60/70% of the power for a linear amplifier or transmitter. So don't worry about how many they are, try to have te max you can.

Just to confirm, I will never be running near close to my maximum of 100 watts using the ATU-100 in SSB?

PartyRock916, 2021-04-21:
?

Dfinitski, 2021-04-21:
Party rock, did you check the power level in FM mode ? What is result ?

PartyRock916, 2021-04-23:
> Party rock, did you check the power level in FM mode ? What is result ?

The power level in FM mode is still the same, 50W.

Dfinitski, 2021-04-23:
Try to change a cell value, I don't see other way.

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

PartyRock916, 2021-04-24:
> Try to change a cell value, I don't see other way.
> […](#)
> On Thu, Apr 22, 2021, 7:55 PM PartyRock916 ***@***.***> wrote: Party rock, did you check the power level in FM mode ? What is result ? The power level in FM mode is still the same, 50W. — You are receiving this because you commented. Reply to this email directly, view it on GitHub <[#53 (comment)](https://github.com/Dfinitski/N7DDC-ATU-100-mini-and-extended-boards/issues/53#issuecomment-825350117)>, or unsubscribe <https://github.com/notifications/unsubscribe-auth/AD6YS2PCWWRRSHH256MVU7TTKDORXANCNFSM43CZYARQ> .

I apologize but I'm very new to all of this, but can you please elaborate on how I go about changing a cell value and which cell? Thank you.

Dfinitski, 2021-04-24:
cell 31, read the manual, at the end.

сб, 24 апр. 2021 г. в 11:59, PartyRock916 ***@***.***>:

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

Thread 54 (2021-04-28):

By-pass mode question

iu1hcc, 2021-04-28:
Hi all
using this little wonderful tuner in automatic mode, next to my antenna, and I have no option to install one "by-pass" button.
if the tuner is without 12v power, it "switch" to by-pass?
Thank you

Dfinitski, 2021-04-28:
Hi. Yes, it is. No special option for bypass mode in this tuner. Bypass is
meaning all the relays off.

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

iu1hcc, 2021-04-30:
Thank you
73 de IU1HCC

Thread 55 (2021-05-03):

0 ohms between RF center pin and ground?

edwardstorlien, 2021-05-03:
Hello, I am currently assembling the ATU-100 antenna tuner, but I noticed by coincidence something I think is wrong.

With a multimeter I noticed my ATU-100 board has approximately 0 ohms resistance between the RF center pin and ground. This is applies to both the RF input and RF output.

I can see on the schematic that the RF input's center pin is connected to ground through T1, but is it really 0 ohm resistance? Can anyone confirm that this is correct? I am unsure whether I have made a bad solder joint somewhere...

Thanks!

Dfinitski, 2021-05-03:
Hi
Tandem match coiles are connected between center wire and ground for input
and output connector.

On Mon, May 3, 2021, 7:33 AM edwardstorlien ***@***.***>
wrote:

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

edwardstorlien, 2021-05-03:
Hi again, thanks for answer.
Does that mean my multimeter will read 0 ohms, right? Nothing is wrong with my board?

Dfinitski, 2021-05-03:
Yes, that is correct. There is a short by DC, and Hi Z by RF.

On Mon, May 3, 2021, 8:46 AM edwardstorlien ***@***.***>
wrote:

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

MOUSE1025, 2021-05-03:
Dave,
You have the patience of a saint! Excellent support.
Kind regards,
Christopher Paul Ryan

On Mon, May 3, 2021 at 9:41 AM David Fainitski ***@***.***>
wrote:

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

edwardstorlien, 2021-05-03:
Thank you so much for answer, Dave. Great support, I really appreciate it!

Closed 2021-05-03.

Thread 56 (2021-05-05):

Icom/Yaesu support

ast, 2021-05-05:
I don't know if there's any interest in it, but it seems to me it wouldn't be terribly difficult to add Icom (and possibly) support. The ATU-100 would probably work very well with the IC-705.

I'd take a look myself but I don't have access to the mikroC toolchain.

Icom tuner interface:
https://hamoperator.com/HF/AH-4_Design_and_Operation.pdf

Yaesu tuner interface:
https://gist.github.com/ast/cc62dff65d35c857c3a2bd8dfb40051f

73 Albin SM6WJM

Dfinitski, 2021-05-06:
Hello, Albin.
Thanks for the question.
The Icom interface connection has been added in the first firmware of this tuner.
You can read about RA6 and RA7 ports in the manual, "Using the base model".
The main button port is using as START line and RA6 (inverse TX request) is using as the KEY line.
Optionally you can use RA7 noninvert output together with 2N7002 transistor to make an open collector cirquit if it is required.
That time I did not have any Icom rig so I personally did not check this feature but other users told me about successfull connection.
I was focused to full automatic mode for this tuner because it allows to use the tuner with any rigs and also remotelly with no any connections for control.
I am ready to fix bugs if you found them .
Now I  have no any Yaesu rig so I can't work on implementation of the connection. Technically it is possible to use RA6 and RA7 ports as UART RX and TX data lines for data exchange with a rig.

ast, 2021-05-06:
Hi David!

Thanks for your great work!  And thanks for the input. I think that should work, I will try with my Ic-705. If you look at page 7 of the pdf I link to you can see that  failed tuning is signaled by asserting the key for a short period after. Is that also implemented?

Dfinitski, 2021-05-06:
Hi
That is a tuner reset signal, as you may know, the Tune button works also as a Reset by short pressing.

Dfinitski, 2021-05-06:
Hi
No, the tuner does not have that signal inside, it does not know what is this a tune fail.

soosp, 2021-12-27:
Hi,
I prepared my ATU-100 to work with my Icom IC-706MKIIG transciever. An adapter card can be found on Aliexpess and another sites has been used for interfacing with the radio. The schematic can be found at https://ae01.alicdn.com/kf/Hf7f5efcb98bc49de88d1762b71441d97v.jpg
If you press the tune button on ATU-100 the /RA6 line initiates the tuning process on the radio. It switches to CW mode and starts transmit the carrier at 10W for max 20 sec.
If you want to use the tune button of the radio you have to make a connection between the tune button and the START line of the radio with and 1kohm resistor. It is missing from the schematic. By default the START line pulled up to 5V via an 10kohm resistor of this circuit. This reports to the radio that there is a tuner connected. If you press the tune button the radio pulls down this line to GND, but without the connection the tuner doesn't start the tuning process.
The optional Icom switch on the schematic enables/disables this Icom support.
Disclaimer: It works for me but there isn't any guarantee that it will works with another radio.

Hobby4life, 2022-05-06:
Can you share some pictures of the adapter pcb installed?

soosp, 2022-05-06:
Hi,
Here is the link of the PCB:
https://www.aliexpress.com/item/1005001949768630.html?spm=a2g0o.order_list.0.0.6e071802HgZSXf

soosp, 2022-05-06:
Here are some photos about my solution:
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

soosp, 2022-05-06:
The necessary additional resistor is here:
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

This is the modified schematic:
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

soosp, 2022-05-06:
My ATU is powered permanently from the radio via Icom tuner interface, and switched on/off by the power switch of the radio, because the radio needs to be an ATU connected at power on to detect it. The power switch works when use my ATU as traditional automatic tuner (Icom interface disconnected).

soosp, 2022-05-06:
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

Thread 57 (2021-05-06):

rx problem

serdartncl, 2021-05-06:
hi. firstly sorry for my english. i have a problem for my atu100. It was working well before but now when i on rx i can hear just noise but its like static noise. but tuner is works on tx and sending rf. i use with my qrp device under 2 watts. atu100 not modified for under 5 watt. if i tx up to 5 watt may be this problem solve or can i have to do anything?

Dfinitski, 2021-05-06:
Hi.
How it is possible to use ATU-100 with no modification ? The original board does not start a tuning process with power below 5 Watt.

serdartncl, 2021-05-06:
i dont need to process now. i just using for power and swr reading. i using for mono band and dipole for this

Dfinitski, 2021-05-06:
Ok, I got you.
I don't know what could happened, but most likely you are hearing interferences from the display wires, if the FW fersion below 3.2.
Also, if your tuner uses power supply from DC/DC converter , it can be a source of interference too.

serdartncl, 2021-05-06:
bir kaç gündür böyle bir problem yoktu. step up dc regülatör kullanıyorum farklı bir adaptör ile deneyip tekrardan bilgilendireceğim. teşekkür ederim

serdartncl, 2021-05-06:
There was no such problem for a few days. I am using a step up dc regulator, I will try it with a different adapter and inform it again. thank you

serdartncl, 2021-05-06:
I guess, as you said, the problem is in the regulator. I've never thought of it before, thanks again :)

pimol, 2021-05-07:
There are difference if the ATU power is on or off? It seems a problem with
some connector...

I2OIM

Il giorno gio 6 mag 2021 alle ore 23:27 serdartncl ***@***.***>
ha scritto:

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

serdartncl, 2021-05-07:
Yes ita different. When atu100 is off i didnt hear static noise. When i turn on its coming

Thread 58 (2021-05-18):

part parameters

KD4IYI, 2021-05-18:
I ordered and received a couple of boards that were supposed to have all SMD/SMT parts premounted on them, the first had 3 of the 1uf capacitors shattered, and the second didn't have C1-C7 in place, and the ones sent are physically far too small for the pad size. I need to order correct replacements. so, my questions are
A. the 17 EA 1uF capacitors, the ones for all the relays for instance, what part number, package type, and or type and specification are they? 50v? 1kV? tolerance?
B. the C1-C7 capacitors, what package type are they, I found a listing on the schematic of silver mica 500v, but no tolerance, and no package sizes
These questions I have are for future reference... I saw another issue stating that these aren't frequency dependent, but they don't operate very well at 50MHZ due to internal capacitances? can you elaborate a bit on what would be needed to add that band or modify a tuner to cover it and perhaps sacrifice some lower frequencies? what would be necessary to build a tuner up to 200-250W using this basic layout. I know there are some kits out of Russia and the Ukraine up around 1KW, but I'm not where I can afford those yet.

I also wanted to tell you I appreciate all the work that you have put into this project!
Thanks!

Seannon, AG0NY (formerly KD4IYI)

Dfinitski, 2021-05-19:
Hello, Seannon
This tuner does not work properly on 50 MHz. Anyway, you have to have normal resonant antenna on that band, simple long wire with length 3 and more lambda will not work even with SWR=1.
1uF capacitors like this CL21B105KAFNNNE
C1-C7 like this CD15CD100DO3
Also you can use ceramic capacitors like this https://www.digikey.com/en/products/filter/ceramic-capacitors/60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

KD4IYI, 2021-05-19:
Thank you very much!, now to order capacitors and get to building!

Closed 2021-05-19.

Thread 59 (2021-06-07):

Tuning at low power fails for severe mismatch due to reduced TX-power

JensZander, 2021-06-07:
Hi David,

I recently bought the ATU100 Extended (China mfg, firmware 3.2)  and modified to tuner for QRP according to the nice video by IK3SSG. (5 turns in tandem-match + parameter updates in EEPROM - min power cell 05  = 01
No problems everything looks OK ..maybe the power reading is 30-40% too low, but I can live with that,

I am using the tuner with my ICOM-705 (5 - 10W) .  When I use the tuner to match "not too bad" antennas   with SWR <1:4 or 5, there is no problem, the tuner works excellently and quickly finds a good LC-setting.

However,  when facing a bad antenna (say a random wire),  the tuning process sometimes seems to present the TRX with a so bad match (typically a large shunt-capacitance) that the (measured) input power drops below 1W and the tuning process stops.  This seems to happen intermittently .. sometimes I seem to be  "lucky" and the tuner tunes properly, but most of the time it stops (due to dropping below the input power threshhold?) . When connecting the TRX  to the same antenna directly,  the SWR is horribly high (say 1:7 or 1:8), but the TRX power stays up - so does it if I do reset the LC-setting to zero - so it must be the tuner that makes the match worse)

Is this a known problem or is this a faulty device ?  Unfortunately, the device has a single "Tune"-button".  I cannot see that the RB1 and RB2 pins are readily available to force the device into test modes.

Can I calibrate power meter do give a correct reading? I think that migth solve the problem. The measure input power when the tuner stops is typically 1.5W (when the tuner indicates 0.9W)

Jens / SM0HEV

Dfinitski, 2021-06-07:
Hello, Jens
Most likely bad RF diodes are used in tuners from China . Change them according to BOM list .
This tuner has pretty good accuracy around 10% .
Resolve the problem with power measurement and the tuner will work better .

JensZander, 2021-06-07:
Thanks David,
I will check the diodes. I guess you can replace the surface mounts with standard package diodes (1N5711)

Question .. in the tuning algorithm  .. how is the filter configuration determined, i.e. the setting of S8 (capacitance of the TX or antenna side). I am operating portably mainly with electrically "long" non-resonant end-feds with high impedance (i.e. capacitance on the antenna side), I guess the problem mainly occurs when the algorithm tries the low-impedance settings.
/jens

Dfinitski, 2021-06-08:
Hi, Jens
The algorithm remember last successful tuning position of switch and uses
it for next tuning process

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

JensZander, 2021-06-09:
Hi David,
Mea culpa .. I misinterpreted the number of turns on the tandem match.. It looked like 5 turns - but the wire actually passed 6 times through the core. Now the power reading is correct within 10% -- at least ..up to 17m then the reading starts droping to show 50% of the measured value on 10m  .. that could  be du to the "chinese Schottkys" ?  Tuning of my  random wire works fine .. now up to 17m .. then the power drops below 1W sometimes during the tuning process and the process stops.  Will replace the diodes as well.

Dfinitski, 2021-06-10:
Hi, Jens.
Chinese zenners can not to work as a shottky.

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

Thread 60 (2021-06-11):

AT-100 EXT does not work with TYT TH-9800 band 29 and 50 Mhz

SergioIU2, 2021-06-11:
Hello while with a QRP on 7 Mhz, exactly the famous BITX 40, it works wonders, if I connect it to the TH-9800 on the 29 or 50 Mhz bands it doesn't work. Tune when you want and to make it work I have to increase the minimum power to 40W, while with the BITX 5W they are enough and advance. Then I noticed that both off and in bypass the 70cm band does not pass in rx, there is a considerable attenuation of the signal in rx both in 70cm and in 2mt
Do I have to do something to be able to make it work on the TH-9800 on the 29 and 50 Mhz bands?
And to make the 2m and 70cm bands pass without attenuation?
NB I use a 430-144-50-29 Mhz quad-band antenna
Thanks and sorry for my English!

Dfinitski, 2021-06-11:
Hello, Sergio
Most likely 9800 drops out power level when SWR more than 3.
This tuner board can not to work with 6m, 2m, 430Mhz bands even in bypass mode. Too much losses.

SergioIU2, 2021-06-12:
> Hello, Sergio
> Most likely 9800 drops out power level when SWR more than 3.
> This tuner board can not to work with 6m, 2m, 430Mhz bands even in bypass mode. Too much losses.

Hello and thanks for the reply
That does not work on 144 and 430 Mhz I knew this! And I already have a change in mind to completely bypass everything! But on 50 Mhz it must work! In the photo it shows from 1.8 to 55 Mhz, think that I bought it just for 6 meters

https://it.aliexpress.com/item/4000773678364.html?spm=a2g0s.9042311.0.0.7f914c4dca0OuR

Dfinitski, 2021-06-12:
Hi, Sergio.
No, for 6m band you will need to use a special kind tuner, not like this.
But better to use resonant antennas without any tuner.

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

Arm-D, 2021-09-11:
Sergio,
please check the diodes. In some tuners the wrong type of diodes are fitted.
After changing to genuine BAT41 the tuner works up to 50 MHz and needs 5W or less to tune.

SergioIU2, 2021-09-11:
> Sergio,
> controlla i diodi. In alcuni sintonizzatori sono montati diodi di tipo sbagliato.
> Dopo essere passato al BAT41 originale, il sintonizzatore funziona fino a 50 MHz e ha bisogno di 5 W o meno per sintonizzarsi.

Grazie! Controllerò!

Thread 61 (2021-06-16):

Power and SWR reading is wrong

w0ati, 2021-06-16:
I am stumped and hoping for advice.
I built an extended ATU-100 kit. Placed a dummy load on the ATU output and applied a QRP transmitter to the input. The dummy load was tested with a NanoVNA and has an SWR of 1:1 at 14MHz. The QRP transmitter (14MHz) output power has been measured with a Diamond SX-600 SWR/Power meter. Its 2.5W. However, the ATU in bypass mode says the power is 1.9W and the SWR is 1.8:1.
I did the same with an IC-735 at 10W just incase its a power issue. Same kind of results, SWR and power are significantly off.
I put the NanoNVA on the ATU input and the SWR of the dummy load through the ATU in bypass mode is 1:1.
I took T1/T2 off the board. Applied a DC supplies to the 50ohm resistors at the RVS and FWD sense points. The diode Vf is reasonable (1V). The voltage division from the diode output to the MCU input pins is correct. And the MPU measures the voltages and responds to the input voltages with a power and SWR measurement. With some arbitrary FWD voltage and no RVS voltage SWR displayed is 1:1. The board voltage sensing circuit seems to be working.
I re-wound T1/T2 (10:1 ratio). Then tested it on a bread board I made (the transformer, 14MHz source, 50ohm load and a dual channel scope). With 50ohm load FWD gets a sinewave and RVS is 300 time lower. With an open or short for a load, FWD and RVS are equal within a few percent. The transformer seems to be working.
However when I soldered it back into the ATU I still get incorrect power and SWR (no change from before).
I have considered that I have the phasing (winding direction) of the T1/T2 winding incorrect, but I have studied pictures of units I find on the web and can't see that I am doing anything different than I see in the pictures.
As I say I am stumped.
Thanks for reading this.

Dfinitski, 2021-06-16:
Hi.
What about 1.8 MHz band ?

ср, 16 июн. 2021 г. в 10:49, w0ati ***@***.***>:

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

w0ati, 2021-06-16:
Have not tried it there. Only 14 and 21Mhz. I did sweep the transformer from 1 to 30Mhz looking for changes. There were some but nothing that concerned me. Thanks

Sent from Yahoo Mail on Android

  On Wed, Jun 16, 2021 at 12:14 PM, David ***@***.***> wrote:

Hi.
What about 1.8 MHz band ?

ср, 16 июн. 2021 г. в 10:49, w0ati ***@***.***>:

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

—
You are receiving this because you authored the thread.
Reply to this email directly, view it on GitHub, or unsubscribe.

Dfinitski, 2021-06-16:
Transformer is good, take a look at the diodes, if you buy the kit in China
most likely the diodes can't work on high frequency.
You can also check a voltage after diodes and correlate it to SWR on the
display.

ср, 16 июн. 2021 г. в 11:56, w0ati ***@***.***>:

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

w0ati, 2021-06-16:
I did measure the sense voltages. With my QRP transmitter (2.5W) Vfwd is 1.01V and Vrvs is 0.29. That is an SWR of 1.8 which is what the display showed at the time. Confirming the board circuity and MCU is working just fine. The problem is, with the dummy load (which is a perfect load at 14MHz) and if the transformer is working, where did that Vrvs of 0.29V come from? There is something going on around the sense circuit (transformer, 50ohm sense loads diodes, capacitors).
I did get the kit from China. I guess I should look into those diodes. And verify the capacitors, I guess. Hate working with SMT components now. I miss the microscope, soldering station and lab stock I had before I retired.
Thanks
    On Wednesday, June 16, 2021, 01:22:43 PM MDT, David Fainitski ***@***.***> wrote:

Transformer is good, take a look at the diodes, if you buy the kit in China
most likely the diodes can't work on high frequency.
You can also check a voltage after diodes and correlate it to SWR on the
display.

ср, 16 июн. 2021 г. в 11:56, w0ati ***@***.***>:

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

—
You are receiving this because you authored the thread.
Reply to this email directly, view it on GitHub, or unsubscribe.

w0ati, 2021-06-19:
You are right. It was the diodes. They were are functioning diodes, they just have too much junction capactiance.
    On Wednesday, June 16, 2021, 02:08:57 PM MDT, Derek Toeppen ***@***.***> wrote:

  I did measure the sense voltages. With my QRP transmitter (2.5W) Vfwd is 1.01V and Vrvs is 0.29. That is an SWR of 1.8 which is what the display showed at the time. Confirming the board circuity and MCU is working just fine. The problem is, with the dummy load (which is a perfect load at 14MHz) and if the transformer is working, where did that Vrvs of 0.29V come from? There is something going on around the sense circuit (transformer, 50ohm sense loads diodes, capacitors).
I did get the kit from China. I guess I should look into those diodes. And verify the capacitors, I guess. Hate working with SMT components now. I miss the microscope, soldering station and lab stock I had before I retired.
Thanks
    On Wednesday, June 16, 2021, 01:22:43 PM MDT, David Fainitski ***@***.***> wrote:

Transformer is good, take a look at the diodes, if you buy the kit in China
most likely the diodes can't work on high frequency.
You can also check a voltage after diodes and correlate it to SWR on the
display.

ср, 16 июн. 2021 г. в 11:56, w0ati ***@***.***>:

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

—
You are receiving this because you authored the thread.
Reply to this email directly, view it on GitHub, or unsubscribe.

k9nud, 2021-07-04:
I just completed my Hisonauto kit from AliExpress and while it works, I'm seeing SWR issues. My KX3 (with ATU bypassed) shows a different SWR than the ATU-100, which always indicates a higher value. I'll assume the RF diodes are the issue. I saw somewhere that in addition to the BAT41 SMDs, 1N5711 traditional diodes are also specified. This board has pads for traditional components too, so shall I assume they'll work? Also, it would not tune my EFHW on 160M, though the KX3 will. Would the diodes be a culprit?

On another note, this model (Hisonauto) has firmware 3.2 and claims to work with 1 W. It still specified the 1:10 tandem match. It seems to tune at 5 W. Any thoughts on whether I'll need to rewire the transformer and reprogram the PIC to get it working with lower-output radios?

w0ati, 2021-07-04:
My SWR, with the diodes that came with a kit, also read high (very high). So following the advice given on this forum I grabbed some thru hole Schottky diodes I had in my part stock. I did not know the generic part number or specifications, however, given where I got them, I expected them to be high frequency. The pads on the PCB are really two sets, one SMT size the other larger. So I simply surface mounted the thru hole leads on the larger pads. The SWR readings then because more believable. I never checked the accuracy but the reading were much better.I then looked for the MAT41 and 1N5711 diodes on the internet. They both came up as thru hole. Rather than enter a drawn out search for SMT parts, I bought the MAT41 from Digikey and surface mounted the thru hold leads as before.I have not completed all the testing I want to do yet. I have only tested the tuner on a random length dipole I have in the attic for SWL. I used the ATU test mode to manually tune the antenna on the 20 through 10meter bands using a NanoVNA as the SWR meter. I noted the turner configuration, L, C and SWR for each band. I then used 9W from my IC735 and let the ATU tune that antenna. It did alright. In all but one band the tuner came up with the same configuration and LC values I did. The one case where it did not, I think the algorithm just has a threshold where it says that is good enough and stops. The difference in SWR as per the NanoVNA was 1.02 vs 1.06.At 9W, I don't think the ATU power reading is accurate. It says 7.8W were the Diamond meter says 9W. This could be a diode linearity thing and get better as the power increases (have not tested that yet)The SWR also does not agree with the NanoVNA or Diamond SWR meter although its not bad.1.1 vs 1.08, 1.05 vs 1.09, 1.15 vs 1.18. What is important is that the minimum is real. And it is.
I did not test the tuner at any frequency lower then 14MHz. That is because the SWR/impedance of the dipole so far off I don't think the tuner is going to be able to do it.
And I have not tested it on my QRP (2.5W) radio (yet).

Sent from Yahoo Mail on Android

  On Sat, Jun 19, 2021 at 7:18 AM, Derek ***@***.***> wrote:    You are right. It was the diodes. They were are functioning diodes, they just have too much junction capactiance.
    On Wednesday, June 16, 2021, 02:08:57 PM MDT, Derek Toeppen ***@***.***> wrote:

  I did measure the sense voltages. With my QRP transmitter (2.5W) Vfwd is 1.01V and Vrvs is 0.29. That is an SWR of 1.8 which is what the display showed at the time. Confirming the board circuity and MCU is working just fine. The problem is, with the dummy load (which is a perfect load at 14MHz) and if the transformer is working, where did that Vrvs of 0.29V come from? There is something going on around the sense circuit (transformer, 50ohm sense loads diodes, capacitors).
I did get the kit from China. I guess I should look into those diodes. And verify the capacitors, I guess. Hate working with SMT components now. I miss the microscope, soldering station and lab stock I had before I retired.
Thanks
    On Wednesday, June 16, 2021, 01:22:43 PM MDT, David Fainitski ***@***.***> wrote:

Transformer is good, take a look at the diodes, if you buy the kit in China
most likely the diodes can't work on high frequency.
You can also check a voltage after diodes and correlate it to SWR on the
display.

ср, 16 июн. 2021 г. в 11:56, w0ati ***@***.***>:

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

—
You are receiving this because you authored the thread.
Reply to this email directly, view it on GitHub, or unsubscribe.

k9nud, 2021-07-04:
Thank you. I ordered ten from Mouser. The cost for ten is the same as for six. I will report back once I replace them.

I'm thinking I might build a multi-band vertical and put one of these at the base. Not sure if I'll power it with a Bias-T or a small solar panel and some 18650's.

lu1aax, 2021-07-21:
Hi, I assembled china kit with 3.0 fw

I put it in bypass mode and connect a dummy load (rated up to 6 GHz) at output

In the 80M band I get

PWR: 10W
SWR: 1.01
ANT: 8.3W
EFF: 78%

Since I'm in bypass mode and a dummy load with a virtually perfect match I'm puzzled about why I am seeing 8.3W getting out when 10W are getting in.  SWR reading looks good though.

In the 10M band I get

PWR: 10W
SWR: 1.15
ANT: 8.1W <-> 8.5W
EFF: 77%

Here, SWR reading seems high for this load. Power output is not that stable. May be this is somehow related to the diode problem mentioned in previous posts in this thread?

w0ati, 2021-07-21:
I have personally concluded the power bridge is not accurate. Thus, the power reading is not accurate. However, SWR is a ratio of two equally inaccurate power readings so it ends up correct.

Sent from Yahoo Mail on Android

  On Tue, Jul 20, 2021 at 10:30 PM, ***@***.***> wrote:

Hi, I assembled china kit with 3.0 fw

I put it in bypass mode and connect a dummy load (rated up to 6 GHz) at output

In the 80M band I get

PWR: 10W
SWR: 1.01
ANT: 8.3W
EFF: 78%

Since I'm in bypass mode and a dummy load with a virtually perfect match I'm puzzled about why I am seeing 8.3W getting out when 10W are getting in. SWR reading looks good though.

In the 10M band I get

PWR: 10W
SWR: 1.15
ANT: 8.1W <-> 8.5W
EFF: 77%

Here, SWR reading seems high for this load. Power output is not that stable. May be this is somehow related to the diode problem mentioned in previous posts in this thread?

—
You are receiving this because you authored the thread.
Reply to this email directly, view it on GitHub, or unsubscribe.

Dfinitski, 2021-07-21:
Hi.
The 3.0 firmware uses 1.3db fiber loss by default.
Renew it to latest, that uses 0 dB by default and a possibility to change the value any time.

w0ati, 2021-07-21:
Mine came with FW Ver 3.2.

    On Wednesday, July 21, 2021, 11:39:29 AM MDT, David Fainitski ***@***.***> wrote:

Hi.
The 3.0 firmware uses 1.3db fiber loss by default.
Renew it to latest, that uses 0 dB by default and a possibility to change the value any time.

—
You are receiving this because you authored the thread.
Reply to this email directly, view it on GitHub, or unsubscribe.

Dfinitski, 2021-07-21:
That's good, so you don't have that problem as lu1aax.
Did you change Chinese diodes in the tandem match measuring circuit ? That is famous problem.

w0ati, 2021-07-22:
Yes, I replaced the diodes. The ATU will do a reasonable job of detecting a SWR null and matching an antenna. However, I don't trust any of the power readouts on the display. 

Sent from Yahoo Mail on Android

  On Wed, Jul 21, 2021 at 2:10 PM, David ***@***.***> wrote:

That's good, so you don't have that problem as lu1aax.
Did you change Chinese diodes in the tandem match measuring circuit ? That is famous problem.

—
You are receiving this because you authored the thread.
Reply to this email directly, view it on GitHub, or unsubscribe.

Dfinitski, 2021-07-22:
That is weird, the power measurement accuracy is pretty good on this device, even better than some gauges type manufactured meters .
Check the resistors
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

Thread 62 (2021-07-11):

Fall back to bypass or interference?

harmi99, 2021-07-11:
I modified today ATU100 as per IK3SSG https://www.youtube.com/watch?v=dPys_-_wPcQ video for QRP usage, now with 2x5 turns, EEPROM cell 05 to value 01, c06 to v40, c31 to v05. Previously output power up to 10W was insufficient to initate the tuning reliably. Now it seems much better for 160 and 80m, however for 40m and higher frequencies it tunes first to reasonable SWR and after couple seconds some relays suddenly change ON/OFF positions and I am at SWR>3 and on ATU display I see bypass mode with underscore "_" at the end of the first line. With continuous TX it switches back and forth. Enclosing short video to demonstrate this - after the bypass is somehow started, I manually switched bypass off (having all three buttons) and ATU returns to Auto mode indicated by comma "." at the end of the first line. Do you recommend to increase cell 05 to reduce sensitivity or some other experience? Thanks, Peter.

https://user-images.githubusercontent.com/87270900/125200132-d7820d00-e269-11eb-8fd7-3ba43d36419c.mp4

harmi99, 2021-07-11:
Faster writing than thinking - 100n capacitors for both Auto and ByPass button solved this issue, now it works fine.... Peter.

Dfinitski, 2021-07-11:
Hi, Peter
Sure, very simple and obvious solution.

frankliao84, 2021-07-28:
>
>
> Faster writing than thinking - 100n capacitors for both Auto and ByPass buttons solved this issue, now it works fine.... Peter.

would u mind tell us the postition number you changed to 100nF cap?

harmi99, 2021-07-28:
frankliao, there is no position, this is not related to caps connected to relays, it is just about parallel caps to the switches/buttons for Auto and ByPass function as it is described in the ATU-100_Extended_Board_User_Manual_eng.pdf in the section Additional Buttons.  ph

frankliao84, 2021-07-29:
>
>
> frankliao, there is no position, this is not related to caps connected to relays, it is just about parallel caps to the switches/buttons for Auto and ByPass function as it is described in the ATU-100_Extended_Board_User_Manual_eng.pdf in the section Additional Buttons. ph

OK.

Thread 63 (2021-07-23):

Beginners question: unsure about interpretation of schematic S7, S8 and S15

dl8bag, 2021-07-23:
Hi,
I feel unsafe in how to interpret the pcb picture: Do I need to add wired bridges for S7, S8 and S15?
Vy 73 and a little sorry for asking
Rolf

Dfinitski, 2021-07-23:
Hi.
No any bridges there, that lines for understanding how relays work (
internal connections).

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

dl8bag, 2021-07-23:
Hi,
thanks a lot for clarification and reassuring me. I couldn't find an differences between S7, S8, S15 and the other relays in the schematic - that's why I was asking.
Thanks again for the immediate reply and 73 de
Rolf
> Hi. No any bridges there, that lines for understanding how relays work ( internal connections).
...

Closed 2021-07-23.

Thread 65 (2021-08-03):

Function request: min pwr/max power for tuning setting from device

lu1aax, 2021-08-03:
Hi, I think it would be great if the values for minimum/maximum power for tuning could be set from the device, in a similar way to setting up feeder loss in dB in firmware 3.2.

This would let configure the device on the field without needing a PIC programmer to change theses values.

Mauricio LU1AAX

Dfinitski, 2021-08-04:
hi, Mauricio
I don't see any reason to change these values in the field,
The values by default are fully suitable for 99% users.

lu1aax, 2021-08-05:
> hi, Mauricio
> I don't see any reason to change these values in the field,
> The values by default are fully suitable for 99% users.

Well I intend to use this tuner with a ft-817nd with 5W max out power. Only way to reliably tune without changing default hardware configurations (like turns at matching transformer kepto to 10) is to set min power to 0. I also use it with more poweful radios and would like it to tune with 10/15W of power. Accordlingly it would be nice to be able to set up max power (default no limit) in a similar way.

Dfinitski, 2021-08-06:
Hi, Mauricio
This is a 100W tuner, it has been designed especially for 100 W.
For QRP operations I have designed another tuner  https://github.com/Dfinitski/ATU-10-10W-QRP-antenna-tuner
The best way is to use right tuner for right power.

Thread 67 (2021-08-10):

What is the max fwd power level?

frankliao84, 2021-08-10:
I tried to make it work under 300W average with CW mode. Is that possible? If not, what is the limit for that? cap max voltage or the  tandem matching core?

Dfinitski, 2021-08-10:
Hi. This tuner by default can measure up to 150W , bat you can change the
tandem match ratio and some cells in the firmware for work up to 1kw and
more. See the manual, cells description.

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

pimol, 2021-08-10:
100W

Pietro I2OIM

Il mar 10 ago 2021, 10:46 frankliao84 ***@***.***> ha scritto:

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

frankliao84, 2021-08-11:
> Hi. This tuner by default can measure up to 150W , bat you can change the tandem match ratio and some cells in the firmware for work up to 1kw and more. See the manual, cells description.
> […](#)
> On Tue, Aug 10, 2021, 1:46 AM frankliao84 ***@***.***> wrote: I tried to make it work under 300W average with CW mode. Is that possible? If not, what is the limit for that? cap max voltage or the tandem matching core? — You are receiving this because you are subscribed to this thread. Reply to this email directly, view it on GitHub <#67>, or unsubscribe <https://github.com/notifications/unsubscribe-auth/AD6YS2OTZHBJKHBHO7R5I63T4DRP7ANCNFSM5B3VVXXA> . Triage notifications on the go with GitHub Mobile for iOS <https://apps.apple.com/app/apple-store/id1477376905?ct=notification-email&mt=8&pt=524675> or Android <https://play.google.com/store/apps/details?id=com.github.android&utm_campaign=notification-email> .

Thanks. I just worried about the insertion loss of 1000w might burn the core. Other issues like feedback voltage limit could be fixed with minor hw and sw change.

Dfinitski, 2021-08-11:
There are some modifications of this tuner with large inductors core and
capacitors for 1kw operating power. The most important the processor and
the firmware can do that, you are right.  You can find that pcb on eBay,
from Russians sellers.

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

G0NMY, 2021-08-11:
Are the contacts in those small relays capable of handling 1KW?? They are
quite small arent they???
I would think that better quality relays would be required for such power
levels???

On Wed, 11 Aug 2021 at 02:22, David Fainitski ***@***.***>
wrote:

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

Dfinitski, 2021-08-11:
Better one time to see
https://m.youtube.com/watch?v=fCgariqxoNk&feature=youtu.be

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

Thread 68 (2021-08-14):

Various problems - help!

delight-f, 2021-08-14:
Again, thanks for this project. My problems are almost certainly user error.The MCU is running v.3.2 - bought from aliexpress. I'm a relatively new ham, less than a year.

1. As I increase power (say from ten Watts all the way to 50w), I notice the swr increasing - is this normal?? If so, why?

2. At some point, even when auto mode is disabled (dot not visible), the tuner will start tuning automatically. I think this led to problem 3.

3. When I was using it last, I tuned at low power and turned auto mode off. I then switched to 100w. The tuner flicked into bypass mode briefly, then tuned as I was sending. Something inside (I think one of the coils) got incredibly hot - to the point where it deformed my PLA printed housing. All my soldering appears OK. I wonder if it was because it went into tuning mode somehow as I was transmitting at that power.

Dfinitski, 2021-08-14:
Hi.
1. It is normal, nonlinear diode characteristics, something become hot.
2.  I don't know, RF interferences on the button wires ?
3. Chinese Amidon cores with losses on RF.

delight-f, 2021-08-14:
Thanks so much for your feedback. I appreciate your quick responses.

The RF on the buttons is a real possibility. They are connected by short flying leads to the pads. Do you have any suggestions on how to reduce the rf interference on these?

Dfinitski, 2021-08-14:
Short pins to gnd with 0.1uf capacitors directly on the pads

delight-f, 2021-08-24:
I've installed the caps to ground and the button activating spontaneously is not a problem. However, I have real issues with RF causing interference with the screen - a typical small OLED. It scrambles the readout so it is not legible. It is mounted in a 3d printed plastic housing. Any suggestions? @Dfinitski

pu7vll, 2023-01-11:
Good evening, Bought with a friend recently two atu 100 on Aliexpress for our USDX, but we both see on the TUNE screen and we do not hear the relé working, ie is not docking! Could someone guide us, we are using version 3.1 by N7DDC. TKS

Dfinitski, 2023-01-11:
https://groups.io/g/ATU100/topics

Dfinitski, 2023-01-11:
Hi. Ask in our group.
What power and SWR value do you see on the display ?

pu7vll, 2023-01-11:
less than 4w and with 8 SWR test. TUNE appears but the relays do not work

pu7vll, 2023-01-11:
> Hi. Ask in our group.
> What power and SWR value do you see on the display ?

less than 4w and with 8 SWR test. TUNE appears but the relays do not work

Thread 69 (2021-08-21):

how do I HEX-edit the FW 3.2 to rotate display OLED 128x64 180 degrees?

dl1hbt, 2021-08-21:
Hi folks! See "subject" an attached pics. I am using a PIC16F1938 attached to an OLED 128*64 display. What cell do I need to edit and what is the appropriate value that rotates back to normal orientation? Any clue? Thanks in advance, Tom

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

dl1hbt, 2021-08-22:
Problem solved by RTFM...sorry for making unnecessary noise ;-)

Closed 2021-08-22.

Thread 70 (2021-08-26):

What modifcations/compromises would be required to make the ATU also work  in the 4m band ?

satfan52, 2021-08-26:
Hello,

I use an horizontal loop antenna (40M perimeter) that resonates quite well on all ham bands which are a multiple of 7 Mhz so covering the 6M and 4M band as well.  This antenna works beautifully on all bands including in the 6m one. Unfortunately, due to stray caps the resonance shifts below 70 Mhz  so the VSWR is not so good at 70 Mhz (even with a 1-4 ballun).

The ATU-100/ATU-1000 are specified to work up to the 6M band but I wonder if it would be possible to make some changes so these two models could also be used in the 4M band (with some compromises of course)

I have recently experimented with tandem match couplers of the same type than the ones used in the ATU100/1000 and I was able to get  a good coupler "directivity" between 1.6 Mhz and 145 Mhz using binocular cores of a medium size and a limited numbers of turns on the two secondaries, so I know for sure that adequate tandem couplers could do the job from 1.6 Mhz to 70 Mhz and would not be the bottleneck.

Regards
Peter

sbridger, 2022-04-07:
A simple option would be to add a bypass relay around the ATU, connect it's coil to 12V, so that if the ATU is not powered, the bypass relay is straight through, if the ATU is powered, then the ATU is in circuit.

Another option would be to put a current sense diode, R and PNP in the +12V to the relays. if any relay is activated, (i.e. tuner is inline) then the bypass relay is energised, and tuner is inline. If all relays are off, bypass relay is deenergised, tuner is bypassed.

---

Personally  I plan to use the ATU at the antenna (mast head), and I want to have multiple antenna switches there, including a coax VHF/UHF select.

An I2C output to select more relays would work well for me.

Closed 2022-07-18.

Thread 71 (2021-09-14):

Tuner cannot match any antenna and Effiency stays at 33 percent

sridharkr, 2021-09-14:
I have the ATU-100 and after connecting an antenna and working on the tuner, the reset works and post which the antenna is never able to tune perfectly. It is always at 33 percent efficiency and shows SWR 9.99 , the C values and L values keep changing often but still never is able to tune a perfect match.

Can you give some guidance as to why this would be the case and what can I do to check this behaviour against?

Thanks

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

Appreciate your response

Dfinitski, 2021-09-14:
Hi
Check if the power meassured correctly, if not try to change the tandem
match coil phase.

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

killerekpl, 2023-05-31:
@sridharkr Did you solved the problem? I have the same problem

Thread 72 (2021-09-22):

remote extended atu atu

gi0bfo, 2021-09-22:
Hi , I want to use the atu in a remote location. Will the atu retain the auto command if it loses the 12V supply ?.
Thanks

Dfinitski, 2021-09-22:
Hi .
Sure, the missing power voltage is meaning return to bypass mode.

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

Thread 73 (2021-09-30):

Unexplanaible behavior of device going to bypass mode by itself

mautas, 2021-09-30:
Hi! I am experiencing a weird problem with 7x7 device. After some weeks of just storing the device (it was working ok) I took it out. to use it.. When I turn it on it switches to bypass mode by itself. All buttons are unresponsive after startup. There are 100 nF capacitors in secondary buttons. Device can enter both test modes, and Feeder Line loss setup mode, but after that buttons are unresponsive.

Checked out for shorted capacitors, found none.

Dfinitski, 2021-09-30:
Hi. Check the voltage on the shorting capacitors when you press the
buttons. It should be 5V when unpressed and 0V if the button is on.

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

mautas, 2021-09-30:
Reading almost 0V (0.04V) at RB1, the cable from the RB1 point at the board to the button looks ok but I'll check it again..

mautas, 2021-09-30:
> Reading almost 0V (0.04V) at RB2 the cable from the RB2 point at the board to the button looks ok but I'll check it again..

Cable was OK, I even unsoldered it... RB2 at low value... Faulty PIC?

Dfinitski, 2021-09-30:
Should be 5V and 0V when button is pressed.
Your 0 V in what position ?

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

mautas, 2021-10-01:
The tuning pad (B2) is fixed fixed at 0.04V... seems like something went wrong there blowing up that pin, I wonder if is some RBx pin unused so I could remap RB2 to that pin (of course I'd have to wire it) in order to save the PIC. I'd also have to compile the project to honor the new mapping.

mautas, 2021-10-06:
Well I could save the PIC... it seem like the pullup circuitry for B2 blowed up or something. I tested feeding 5 volts to B2 and the signal was ackowledged by the PIC, so I finally connected the button to 5 volts through a 330 ohm resistor after trying out different resistor values from 10K to 1K. I think it was not a good idea to rely on internal pullup circuitry of the PIC...

Thread 78 (2021-11-07):

I/O short-circuit

OK1TK, 2021-11-07:
Hello, I just finished the board. I don’t want to use the SMA connectors and I soldered a few  cm of RG58 to the Input and Output. When I checked the cables with multimeter I found short-circuit between the signal and ground. I thought I did something wrong with the cables but I have the same situation when I removed the cables. I can’t find any mistake I was checking all the SMD components for short-circuit when each of them was soldered.
The power supply was not connected yet and any button nor the display are not attached yet.

Please, do you have any recommendation what to check what are the common mistakes ?
Thank you in advance.

Dfinitski, 2021-11-07:
Hi.
See the schematic. RF input is shorted to ground with the tandem-match.

OK1TK, 2021-11-07:
Hi, I  was looking to the schematic and just found it 2 minutes before your
e-mail arrived. Thank you very much for your fast reply.

May I have another question ? Pls, do you think I can connect the display
and buttons via a few mezery of UTP cable for “Remote” control ?

Have a Nice day.
73!
Tomáš

ne 7. 11. 2021 v 21:04 odesílatel David Fainitski ***@***.***>
napsal:

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

Thread 79 (2021-11-14):

Tx_request LED

OK1TK, 2021-11-14:
The manual mensions that the Tx_requset signal can be used for LED to indicate the the tuner is currently tuning. Should I use RA6 or RA7 for that purpose, please ? What voltage is present on the RA6 and RA7 pins ?

Dfinitski, 2021-11-15:
Hi.
Yes, you can. 5 Volts output.

Thread 80 (2021-11-20):

Display and test mode issue

OK1TK, 2021-11-20:
Hi, I would like to ask you for an advice.

I finished the device but my OLED display is not working. The kit arrived with the smaller version of the OLED display but it doesn’t work even with larger one which I have at home. If I have 5V on VCC, DAT and CLK pin does it mean I did something wrong or the SW is set for the LED indication ?

Tuning. I connected my nanoVNA to the I/O of the tuner and started the test mode by pressing the BP+AUTO buttons. By pressing BP and AUTO buttons I was able to move between 43.5pF to 1.61nF but I was not able to move the inductamce part even with the long press of TUNE button.

Dfinitski, 2021-11-21:
Hi
You have to set up specific value to the flash cells for OLED running. By default LCD display works. Reed the manual, cells description.

Thread 81 (2021-12-23):

What is power losses in bypass mode?

qrp73, 2021-12-23:
Hi, what is typical power losses (S21) in bypass mode for extended 7x7 version?

I'm using tandem match 1:10 and as I found there are two bypass modes:

1) device is powered off (all relays are OFF)
- 1 MHz S21 = -0.12 dB
- 7 MHz S21 = -0.17 dB
- 14 MHz S21 = -0.25 dB
- 30 MHz S21 = -0.48 dB

2) device is powered on and bypass mode enabled (S8 relay is ON and the rest relays are OFF)
- 1 MHz S21 = -0.14 dB
- 7 MHz S21 = -0.19 dB
- 14 MHz S21 = -0.27 dB
- 30 MHz S21 = -0.44 dB

So, there is 10% of power loss at 30 MHz. For 100W TX at least 10W will be dissipated on ATU100 in bypass mode. This looks pretty high losses, so I wonder if there is something wrong with my device or that results are normal?

Dfinitski, 2021-12-23:
Hi. What about SWR on 50 Ohm dummy load ?

qrp73, 2021-12-23:
When output is loaded with dummy load ATU100 shows SWR about 1.00 .. 1.02.

Second power meter connected on ATU100 output shows at 7 MHz about 5% less power (-0.2 dB loss) than connected directly to the transmitter.

VNA shows S11 on ATU100 input the following:

1. device is powered off (all relays are OFF)
- 1 MHz S11 = -26.09 dB / SWR = 1.10
- 7 MHz S11 = -28.88 dB / SWR = 1.08
- 14 MHz S11 = -24.69 dB / SWR = 1.12
- 30 MHz S11 = -17.87 dB / SWR = 1.29

2. device is powered on and bypass mode enabled (S8 relay is ON and the rest relays are OFF)
- 1 MHz S11 = -26.04 dB / SWR = 1.11
- 7 MHz S11 = -28.93 dB / SWR = 1.07
- 14 MHz S11 = -25.82 dB / SWR = 1.11
- 30 MHz S11 = -23.89 dB / SWR = 1.14

Dfinitski, 2021-12-23:
Looks good.
Connect a real 100W transmitter to some gauge with and without the tuner. Do you see 10% loss ?

qrp73, 2021-12-25:
Yes, I see 12% power loss when compare direct dummy load and through tuner.

Dfinitski, 2021-12-25:
Excellent. Now you can find what is become warm. I think the tandem match core

qrp73, 2021-12-25:
yes, transfluctor heats up during TX. I'm using BN-43-202, got it from Aliexpress with ATU-100 DIY kit.

Is it normal? or I got bad transfluctor?

Dfinitski, 2021-12-25:
I think that is an approximate analogue, not exact bn43-202. High quality and original parts you can find on kitsandparts .com

qrp73, 2021-12-25:
what is expected power loss on 30 MHz with original good quality BN43-202?

Dfinitski, 2021-12-25:
I don't know. That is good question for our official conversation group on
groups.io

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

Thread 82 (2021-12-23):

L4 Core getting very hot

w0ati, 2021-12-23:
I had noticed after using the ATU, the case was a little warm. Its sitting on top of the radio so did not give it much thought.
Today after using it I opened it for other reasons. I got the "Allan Bradley" smell right off. So looked further.
I found the core of L4 was very hot and the paint has burned off (hence the smell). Most of the tuning uses that coil and
combinations of the air wound coils.
I am using 100W or less.
Is this expected??

Dfinitski, 2021-12-24:
No. Seems like you have bad cores with large losses.nothing should be burned or has some smell.

w0ati, 2021-12-24:
I swaped out the core and made a contact with a configuration that used L4 (the new core). It did not appear to get hot. I will monitor it for a while. I am now concerned about all the other cores. The tuner rarely uses any inductor higher than L4. So the other cores in this kit could be bad and I would not know it. I am wondering if I should buy all new cores from a known/dependable supplier.

Sent from Yahoo Mail on Android

  On Thu, Dec 23, 2021 at 5:22 PM, David ***@***.***> wrote:

No. Seems like you have bad cores with large losses.nothing should be burned or has some smell.

—
Reply to this email directly, view it on GitHub, or unsubscribe.
Triage notifications on the go with GitHub Mobile for iOS or Android.
You are receiving this because you authored the thread.Message ID: ***@***.***>

Dfinitski, 2021-12-24:
Kitsandparts.com

nv1o, 2022-02-20:
Isn't it important to wind the cores in the same direction?  I didn't see it mentioned in the instructions, but would think it might be desirable.

Dfinitski, 2022-02-20:
There is no any assembling instructions. I have added couple photos on the schematic to clear questions like this .

nv1o, 2022-02-20:
Yes, those were the instructions I was referring to, coil size, number of turns, etc., and yet my question remains unanswered.

Dfinitski, 2022-02-20:
Ok, there is a photo of tandem match too.

soosp, 2022-04-19:
Same issue here:
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

w0ati, 2022-04-19:
Fascinating, at some level it's nice to know I am not along (crazy). Seems like the big disadvantage with
the implementation shown in the link is coupling between inductors. Note L2 and L3 are at right angles
to each other and L1 is place off somewhere else. This would be to lower coupling between them. The number of windings and loss (series R) would come in to play at some point.
To be honest, I have stopped relying so much on the ATU and just tune the antenna lengths.

Dfinitski, 2022-04-19:
That is famous problem connected with bad Chinese "amidon" cores with high losses on RF.
Change them https://kitsandparts.com/store2.php

Hobby4life, 2022-04-19:
I have measured these cores with the advised amount of windings, but none came nowhere at their given inductance. I have replaced these cores with original Amidon T68-2 cores.. and this looks more promising.

Thread 83 (2021-12-24):

ATU-1000

helikeith, 2021-12-24:
Are there any instructions on the build of the ATU-1000. I have purchased the kit. but no information came with it.

Dfinitski, 2021-12-24:
Hi. Ask the seller about that.

Hobby4life, 2022-06-24:
What do you want to know?

c0nsul, 2023-01-19:
> What do you want to know?

how to set up the measurement of SWR? there are two blue potentiometers, "forward" and "reflected". What is the setting mechanism?

PD5DJ, 2023-01-19:
> > What do you want to know?
>
> how to set up the measurement of SWR? there are two blue potentiometers, "forward" and "reflected". What is the setting mechanism?

What I did is the following:

1. Connect TRX to INPUT of tuner and Connect Dummyload to OUTPUT of tuner.
2. Now transmit for example CW 20 Watt.
3. Adjust the FWD trimmer, so display shows 20Watt
4. Also, measure the voltage accros GND and FWD pin of the 3 pin connector, and write this down.. for example 1.30Volt.
5. Now connect TRX to OUTPUT of tuner, and connect Dummyload to INPUT of tuner.
6. Now transmit again with CW 20Watt.
7. Measure the voltage accros GND and REFL pin of the 3 pin connector and adjust it to 1.30Volts.

Thats it.

Now the REFL input knows the same Power as the FWD input for proper SWR calculation.

You can only do this with a 50ohm load.
Do not use a antenna for this.

c0nsul, 2023-01-20:
Ohh... God bless you dear Bjorn! I was able to experimentally adjust the power indicator, but adjusting the SWR and the entire system as a whole baffled me. Now, I think I have more understanding. Thank you very much for your advice!

c0nsul, 2023-01-21:
> You can only do this with a 50ohm load. Do not use a antenna for this.

I setup the SWR and power according to the technology described above at a power of 10 watts. Now I have the following situation.

ATU always shows good weather and does not work correctly.

Real SWR 1 - ATU 1, real 1.5 - ATU 1.1. Real 2 - ATU 1.5
Power as a whole shows correctly, but with such measurements it makes no sense. If the SWR is 2.2 it starts tuning...

The result of the ATU tuning is often incorrect, it gets a real SWR of 1.8, and at the same time it writes that it is 1.1 or 1.2, but the transceiver shows 1.8.

I met comments on the forums that the problem may be in the Chinese diodes D3 and D4 (1N5711), that it is better to replace them with other similar diodes with a smaller error and better quality...

Maybe I should have adjusted the SWR not to 10W, but to 20W or 30W? The voltage measured between the GND and REFL/FWD was only 0.2 V.

Does it matter in which tuner mode to take measurements? Bypass or AUTO? SWR is everywhere but maybe it's important?

Dfinitski, 2023-01-21:
Hi, Dmytry.
Do a calibration with a power 500 W or above.
Do a tuning with a power around 100 W

c0nsul, 2023-01-22:
> Hi, Dmytry. Do a calibration with a power 500 W or above. Do a tuning with a power around 100 W

Thank you very much for your advice, will try to repeat calibration again.

c0nsul, 2023-01-22:
Re-calibrated with PA on 200W, but still issue with SWR. Next my idea - incorrect rings in tandem match. I measured the inductance on them and the difference in readings was 3 times. I think that my problem is that the Chinese sent me rings with different permeability. I'll try to buy elsewhere and rework this part of the tuner.

Thread 84 (2022-01-08):

Usdr all mode 8 band hf

TA3GT, 2022-01-08:
Hello: How should the device be connected to the ft8 interface cable? need interface diagram

Dfinitski, 2022-01-08:
HI. RF cabel in, out to an antenna. That's it.

TA3GT, 2022-01-08:
Beni yanlış anladın,ft8 için PC bağlantısı arayüz sürekli tx yapıyor

TA3GT, 2022-01-08:
You misunderstood me, PC connection for ft8 interface is always tx, no vox

TA3GT, 2022-01-08:
Is there a circuit between the computer and the cable?

Dfinitski, 2022-01-08:
Sorry, I don't understand you, this device does not have a TX/RX commutation. Are you about ATU-100 antenna tuner ?

TA3GT, 2022-01-08:
usdx all mod 8 band hf radio ft8 interface i wanted computer connection sorry about that

Dfinitski, 2022-01-08:
You have to use USB to COM converter cabel for CAT control and 2 audio cables to connect audio and mic connector to appropriated connectors your sound card on PC.

Thread 85 (2022-01-28):

FW ver 3.2

phillx19090, 2022-01-28:
Apologies if this is incorrectly posted or already covered. Thanks for a great project. I updated today to firmware 3.2. All OK but I wondered if there was a significance with the dots and dashes on the bottom row of the 0.95" OLED? I have these on the display and noticed they appear on the images on a closed issue last year.
Kind regards
Phill EA5JHA

Dfinitski, 2022-01-29:
Hi. Dot - auto mode is on.
Dash - Bypass is enabled now. See the additional 2 buttons description.

phillx19090, 2022-01-29:
Hi David, perhaps I didn't make it clear. The dots and dashes are at the bottom of the display. On boot up they appear to "underline" the firmware version. Then under the C value. It can be seen on the image on closed issue 69 by dl1hbt.

Dfinitski, 2022-01-29:
Oh, now I got you. You have to shift the image up or you don't have to shift it. See the cell description for 1,2,3 cells .

phillx19090, 2022-01-29:
Hi David, thanks for not making me feel too stupid. Read the manual quite a few times and somehow missed cell 7. Dropped it from 01 to 00 and all good. Just a note, my aliexpress kit has an OLED where the address is either 7B or 7A. Zero ohms select soldered on 7B - Cell 00 works with 78 set but Cell 01 needs 05 to get the display to work. Please close the issue.

Closed 2022-01-29.

Thread 86 (2022-02-05):

Tuning not activated

bitslave, 2022-02-05:
Hi David,

I'm wondering whether you could point me in the right direction regarding issues with my unit purchased fully assembled. It will not activate tuning with 10W fed to the tuner from the transceiver and is showing very low power readings and efficiency in all modes - bypass/auto tune/manual tune.

Transceiver is showing SWR of 2.1:1 during transmit with the below readings on the tuner.

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

Any help/suggestions greatly appreciated.

Kind regards.

Dfinitski, 2022-02-05:
Hi.
Did you connect a 50 Ohm dummy load to the antenna connector on the tuner ?

bitslave, 2022-02-05:
Hi David,

Thanks for the reply. These readings are with EFHW 80-10 antenna connected to the tuner. I don't have a dummy load (still on back order).

Dfinitski, 2022-02-05:
If there is no a seal, open the box and check the wires , connectors. I would check also coaxial cables you use for shorting, as a first step.

bitslave, 2022-02-05:
Ok, will do... Thanks.

bitslave, 2022-02-05:
Both UHF chassis mount connectors have continuity between center pin and body (ground). Can't see soldering as they are covered by heatshrink. Tandem match pic also attached.

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
.

Dfinitski, 2022-02-05:
Right side on the foto has 11 turns, left side has 10 ???? Am I right ?
Anyway you have to have a dummy load to continue the troublecheck.

bitslave, 2022-02-05:
Looking from the other side, it seems 11 turns for both T1 and T2. Will organise a dummy load for further testing. Thanks again.

Dfinitski, 2022-02-05:
Should be 10 turns. I think this device was not even check out after assemly.
I would check all the soldering on relays, bottom side.
Most likely some nodes are missed.

bitslave, 2022-02-05:
Agreed. Both sides of the tandem-match were 11 turns, I have corrected them to 10 turns. Still the same issue. Will now investigate the soldering of the relays. Thanks again for your assistance. I have also discovered the ATU100@groups.io boards. Will do some research there. Cheers.

Thread 87 (2022-02-06):

Question about van 3.2

davidhay45, 2022-02-06:
“Added new feature to disable all relays along with the timer display. New cell 35(33 for mini board) - 01 to activate the relay off function. Display Off Timer setup - cell 32 (30 for mini board). You can use this feature in your QRP setup where power consumption is critical.”

what is this to be used for?

Dfinitski, 2022-02-06:
Hi. Bypass mode will be turned on when the display will be turned off.

davidhay45, 2022-02-07:
So in other words when this is function activated by setting the EEPROM cell then putting the tuner into bypass mode the relays will be deactivated and the display will be turned off.

Dfinitski, 2022-02-08:
No.
Display has a timer for turning it off after some period, an example 15 minutes.
Is this clear ?

davidhay45, 2022-02-08:
OK, thnaks

Closed 2022-02-08.

Thread 88 (2022-02-08):

Plans

davidhay45, 2022-02-08:
Not an issue, just a statement.

I am planning to make my own version of the ATU-100 firmware.  This will be based on David N7DDC's 3.2 release and essentially will add the capability to command the tuner from an external device (probably a Raspberry PI using I2C) to cause the unit to set predetermined inductor and capacitor values on demand, a sort of manual mode.  This to enable the tuner to match at very low power for WSPR and FT8 etc where the transmit power levels needed for measuring the swr are simply too low.  In order to do this I will need to restructure the existing code to save programming space and so have the opportunity to make other mods.  For example, I may put the RF diode correction parameters into EEPROM to allow users to adjust the measured power to more accurate externally determined levels.

I am sharing this with this "forum" to see if there are other ideas.

Of course this is only possible because of David N7DDC's amazing generosity in sharing his designs, thank you David.  I have spent many years working as a software engineer and I know very well how difficult it is to make software for external release rather than for one's own use.

David M0TGC

Dfinitski, 2022-02-08:
Hi
Yes, you are right, that is difficult to do what is other people want, not you :)
I am sure that the very low power transmitter must to work with very high efficient antennas and tuner don't need to use them.

Closed 2022-03-03.

Thread 89 (2022-02-15):

Compiling for ATU-100 ext board

nv1o, 2022-02-15:
David, I am trying to compile an edited main.c file, version 3.2.  I downloaded MikroC PRO for PIC, ver 7.6.0.  I want to create a new hex file for the pic, but it's not working for me and I'm don't know how to get it done.  I tried creating a new project, but I'm not sure which files to include.  I've tried them all, but am getting errors like "Undeclared identifier 'ADC_Get_Sample' in expression in the main.h file, when I execute Build.  What are the steps to accomplish this?  Will I end up with the hex file to program the pic with?

73, Craig  NV1O

Dfinitski, 2022-02-15:
Hi. You have to turn on the ADC library in the library manager and also couple other libraries. You will see. Open the library manager at right.

nv1o, 2022-02-15:
Spasibo!  I will give it a try.  MikroC - eto li russkaya kompaniya?

nv1o, 2022-02-15:
David, I got it to compile without errors.  How do I now generate the hex firmware file for the pic?
NV1O

Dfinitski, 2022-02-15:
That is the Poland's company.
Hex is generated. See the project folder, same name as the project

nv1o, 2022-02-15:
Yes, I looked there, but only found the 1K hex file. It generated many other files, .c.ini, .cfg, .cp, .dbg, etc.

nv1o, 2022-02-15:
That didn't work, so I redid the build with just the main.c and the 3 .h files and got this error:
1 355 Redefinition of 'main [ATU.c] '. 'main' already defined in 'main.c' ATU.c

Dfinitski, 2022-02-15:
Probably your MikroE is not activated. That is not free software .

Dfinitski, 2022-02-15:
Probably your MikroE is not activated. That is not free software .

nv1o, 2022-02-15:
No, it's not activated.  Strange it doesn't give a disclaimer on the screen.  OK, I'll see what I can do.
Спасибо
Craig

nv1o, 2022-02-15:
Got the activation code in, but same 'main already defined' error.   Спасибо за помощь.  I am ready to give up on it.

73, Craig

Dfinitski, 2022-02-16:
You have declared main function second time. ATU.c I don't know what is this. Is this your written file ?

nv1o, 2022-02-17:
ATU.c is a very small file that MikroC produces when I run build. This is what's in the file:
void main() {

}
I don't know what it's for, but if I exclude it from the build. I don't get the second function error.  I do get the following report:

0 1 mikroCPIC1618.exe -MSF -DBG -pP16F1938 -DL -O11111114 -fo8 -N"C:\ATU100\Projects\ATU100.mcppi" -EH"C:\ATU100\atu_100_fw_00.ihex" -SP"C:\Mikroelektronica\mikroC PRO for PIC\Defs\" -SP"C:\Mikroelektronica\mikroC PRO for PIC\Uses\P16_Enh\" -SP"C:\ATU100\Projects\" -SP"C:\ATU100\" -IP"C:\ATU100\" "main.c" "oled_control.c" "pic_init.c" "backup.mcl" "main.mcl" "oled_control.mcl" "pic_init.mcl" "__Lib_Math.mcl" "__Lib_MathDouble.mcl" "__Lib_System.mcl" "__Lib_Delays.mcl" "__Lib_CType.mcl" "__Lib_CString.mcl" "__Lib_CStdlib.mcl" "__Lib_CMath.mcl" "__Lib_MemManager.mcl" "__Lib_Conversions.mcl" "__Lib_Sprinti.mcl" "__Lib_Sprintl.mcl" "__Lib_Time.mcl" "__Lib_Trigonometry.mcl" "__Lib_Button.mcl" "__Lib_Keypad4x4.mcl" "__Lib_Manchester.mcl" "__Lib_OneWire.mcl" "__Lib_PS2.mcl" "__Lib_Sound.mcl" "__Lib_SoftI2C.mcl" "__Lib_SoftSPI.mcl" "__Lib_SoftUART.mcl" "__Lib_ADC.mcl" "__Lib_EEPROM.mcl" "__Lib_FLASH_rwe.mcl" "__Lib_I2C_c34.mcl" "__Lib_PWM_c216b0a4.mcl" "__Lib_SPI_c345.mcl" "__Lib_UART_c67.mcl" "__Lib_PortExpander.mcl" "__Lib_CANSPI.mcl" "__Lib_CF.mcl" "__Lib_GlcdFonts.mcl" "__Lib_Glcd.mcl" "__Lib_LcdConsts.mcl" "__Lib_Lcd.mcl" "__Lib_RS485.mcl" "__Lib_S1D13700.mcl" "__Lib_T6963C.mcl" "__Lib_SPIGlcd.mcl" "__Lib_SPILcd.mcl" "__Lib_SPILcd8.mcl" "__Lib_SPIT6963C.mcl" "__Lib_EthEnc28j60.mcl" "__Lib_EthEnc24j600.mcl" "__Lib_TouchPanel.mcl"
0 1139 Available RAM: 1016 [bytes], Available ROM: 16384 [bytes]
0 122 Compilation Started oled_control.h
3 393 'Soft_I2C_Scl' Identifier redefined oled_control.h
4 402 ; expected, but 'at' found oled_control.h
4 393 'Soft_I2C_Sda' Identifier redefined oled_control.h
4 371 Specifier needed oled_control.h
4 396 Invalid declarator expected'(' or identifier oled_control.h
5 402 ; expected, but 'at' found oled_control.h
5 393 'Soft_I2C_Scl_Direction' Identifier redefined oled_control.h
5 371 Specifier needed oled_control.h
5 396 Invalid declarator expected'(' or identifier oled_control.h
5 393 '' Identifier redefined oled_control.h
6 402 ; expected, but 'at' found oled_control.h
6 393 'Soft_I2C_Sda_Direction' Identifier redefined oled_control.h
6 312 Internal error '' oled_control.h
0 102 Finished (with errors): 17 Feb 2022, 11:28:07 ATU100.mcppi

I'm not sure, but the problem may be from not knowing exactly which files to include in the build from the github site.  The report above was produced with ALL the files from the 1938_EXT_board_sources_V_3.2 folder.  Which files do I include?

73, nv1o

davidhay45, 2022-02-17:
MikroC expects to find the initial start routine, main() in a file with <name of the project>.C.  So I guess that your project is called ATU?
To fix this issue simply edit ATU.C and rename the main() routine to be something else, for example main_x().  That will probably fix the "Redefinition of 'main [ATU.c] '. 'main' already defined in 'main.c' " error.
However, this system is not really the place to learn how to use MikroC.  David N7DDC has been very generous in making this project open source, we (me included) should not be asking questions like this.  Just my opinion of course.

nv1o, 2022-02-17:
Well, no matter.  It just surprises me how many people take exception to others' questions about things they don't understand in these kinds of forums.  Yes, David has been gracious to try and help me and I am grateful for that. I just can't understand why I am getting all these errors.  I did edit the ATU.c file and it did get rid of the extra function declaration error, but it's still not working.  I will quit posting and just give up on this.

Dfinitski, 2022-02-17:
Hi. My project is not named ATU and does not have any ATU.c file.
You can see all the files right here, on Github.
Give me a link where you see ATU.c file.

Dfinitski, 2022-02-17:
Probably you have changed some thing in settings

nv1o, 2022-02-18:
Давид, хочу сказать большое Вам спасибо за помощь.  Мне жалко, что я мало понимаю об этом.  Кстати, мне очень нравится тунер!  Прекрасно работает.  Сейчас по-антлиский.  The kit I ordered had ver. 3.2 installed, but both the code and EEPROM were protected, so I used pickit3 to reprogram with your hex file and I was able to figure out how to make my oled display work again from your documentaion file.   So now, it is all unprotected and I can change parameters when I want to.  I saved off a new hex file and all is good.  So now I want to try building the hex file from your source files to see if I can get it to work, so that I would be able to make minor programming changes in the future.  I'm just not having any success to compile it.  I did not change any settings, except to rename the default project to ATU instead of MyProject.  That is how ATU.c got created by MikroC.  What I am asking is what do I need to do in MikroC to get your source files to compile properly?  Do I just create a new project, add files and libraries and do the build, or are there other steps to take? If this is too complex to work out in the forum, let me know and I will put it away for now.  If you are willing and would prefer to communicate via email, you can get my email address from my QRZ page.

С уважением, Craig NV1O

And apologies to DavidHay for me giving it one more try.

Dfinitski, 2022-02-18:
I got you. Don't rename the project, compile it as is.
Turn on in the library manager Button, ADC, EEPROM, Conversion libraries .

davidhay45, 2022-02-18:
Just add the .c files.  The .h are dealt with by the include statements. So main.c, pic_init.c and oled_control.c are all you need. If any other .c file is seen in project manager you can remove it.  And as David N7DDC says just tick the four libraries he mentions.

Closed 2022-02-20.

Thread 91 (2022-03-06):

A question on winding toroids

kbmccroryva, 2022-03-06:
I have the extended kit. Which direction should the toroids be wrapped? Clockwise or Counter clockwise?
Thank you.
Kevin

pimol, 2022-03-08:
Neutral, as you prefer.
Pietro

dashengjiadao, 2022-03-17:
any direction,
i suggestion u try 0.01uH use 0.8mm-4T-4mm.u will get a good effect.
www.atu-100.com

Thread 92 (2022-03-17):

I redesigned the PCB and Firework.

dashengjiadao, 2022-03-17:
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

Thread 93 (2022-05-03):

ATU-100 EXT Display blacks out when tuning with higher power as frequencies get higher and SWR is initially larger

kostecky, 2022-05-03:
Hi there,

I have an atu-100 that works great, except when you start trying to tune at higher powers 20-100Watts when frequencies @ upper end of 14 Mhz -> 50 Mhz, the LCD display cuts out, but the tuner still works.

If I cycle the power, the LCD comes back on and the tuned values are there.

Is this a known phenomenon? I assume it's because of some sort of voltage spike or drop. Can I solve this with a well-placed cap somewhere?

Thanks!

kostecky, 2022-05-03:
The key points are that it tends to happen:
- at higher powers (20-100W)
- with higher frequencies where SWR is larger and more time spent switching caps/inductors to find a match
- and ONLY after a match is found and the last relay clicks

As soon as it finds the tune, the display cuts out until I power cycle, but the tuner continues to function and it does it's job.

kostecky, 2022-05-03:
Nevermind, I fixed it. I put a 100nF cap between the VCC and GND pin on the display and it's stable as a rock. I imagined that it was voltage fluctuations more than the board can handle.

Thanks!

Dfinitski, 2022-05-03:
Thanks. That is RF interference to the display controller. Also use shortest straight path for displays wires .

Closed 2022-05-03.

Thread 94 (2022-05-12):

Working EE Config for Amazon ATU-100

sdr-stack, 2022-05-12:
Can't backup the Amazon prebuilt/kit Malahit ATU-100's since it's read-protected and they don't use the default settings. Here's the tuned config that I used to get it working again. I also tweaked the display timeout to get rid of the whine noise and also sped up the relays since it uses 5ms parts. You can set 03 to '15' instead of 10 to use the default relay settings and set 32 to '00' to disable the screen sleep mode if you want. Also attached the entire hex file if you just want to import and flash, rename it to .hex
[Malahit-3.2-ATU-100-dot-hex.txt](https://github.com/Dfinitski/N7DDC-ATU-100-mini-and-extended-boards/files/8675867/Malahit-3.2-ATU-100-dot-hex.txt)

Address:	00	01	02	03	04	05	06	07	08	09	0A	0B	0C	0D	0E	0F

00		78	05	01	10	13	01	00	00	00	00	07	00	07	00	01	00
10		00	50	01	10	02	20	04	50	10	00	22	00	45	00	FF	FF
20		00	10	00	22	00	47	01	00	02	20	04	70	10	00	FF	FF
30		00	10	01	01	00	00	FF	FF	FF	FF	FF	FF	FF	FF	FF	FF

Dfinitski, 2022-05-21:
Thanks, it will be helpfull.

Kd8dns, 2022-07-17:
And like an idiot I tried to program the PIC before I built mine. You just saved the day!

Thread 95 (2022-05-27):

Autotune wakes-up unexpectedly and triggers tuning sequence, even when SWR is very low, hence damaging relays at high power

satfan52, 2022-05-27:
Hello, I use a 7X7 ATU-1000 tuner kit bought on Aliexpress based on the EU2AV design and that is supposedly designed to work up 1-1.2 KW.

The basic functionality works quite well and I was able to match at low (<100 W)  power level, semi-manually using the "Tune buton" ,  between 1.8 and 30 Mhz, an input SWR in the order of 3 to 6, down to 1.1-1.5 after matching

So the firmware works well for sure in semi manual mode using the "Tune button", but the tuner does not work well  in auto-tune mode with power levels in the order of 100W and more

There are two issues:

1) When the tune is good (SWR is low <= 1.5) auto-tune wake-up for unknown reasons  and starts a tuning sequence. This happens for power levels as from 100 W. This is a major issue when running at 1KW power levels because this unsolicited tuning sequence, at such high power level, inevitably damage or even breaks some relays. No so much an issue at 100W but a 1KW it damages some relays.

In practice,  I have to turn off auto-tune after the matching is done at low power otherwise auto-tune will wake-up even if the SWR is very low and the match perfect. Turning off auto-tune is required to avoid that uncontrolled wakes-up unexpectedly and kills/damages some relays when operating at high power levels.

 The hardware settings is as follow : 100W = 1.2 V on FWD under a perfect 50 ohm load. Same for REF with the device reversed. There is no "overload" alarm on the display and the tuner matches well with  100W , no matching  issues at all. The coupler is a classical 20:1 tandem bridge, the "directivity" is better than 20dB in the range 1 - 30 Mhz. The two cRB2 and RB1  buttons are decoupled with 1nf capacitors and the Tuner button RB0 with a 100nf cap.  Disconnecting the 3 buttons completely from the PCB (to avoid picking up some rf  though the button wires) does not help at all.

So what is going wrong ?

2) The firmware says "ATU-100" on the screen, not "ATU-1000", it is the latest version. I don't think the aliexperess seller loaded the version of the firmware for high power. The SWR indication is good but the power level indicated is completely wrong, clearly over-estimated. Should I upload the version of the firmware with high power settings and a 20:1 ratio for the swr bridge ? Is this going to make a difference in the way autotune works, it it going to be more stable ?

Thanks
Regards
Peter

Dfinitski, 2022-05-27:
Hi. 1nf coupling may be not enough.  Try at least 100nf x 2.
When you increase a power , SWR could increase too and exceed the triggering level 0.3 by default.
You can make the trigger level higher or start the tuning process with higher level close to working level.
But first of all you should resolve the problem with wrong power measurement. Power and SWR should to be shown in 10% tolerance.
Check what is tandem coefficient was set in this current firmware and correspond to real turn ratio. Check diodes on the tandem or swap them to known kind.

satfan52, 2022-05-28:
Hello David, thanks for the reply.
The seller has now sent me the correct version of the hex file. After I loaded it in the PIC16F1938,  the problem is now  completely gone. Auto-tune is now stable at 1.2 kw  (about 3.28 V on FW after tuning the Potentiometer) on 14 Mhz and there is no more unexpected wake-up. The correct power is also indicated on the display. So the problem is solved as far as I am concerned. Regards. Peter

Closed 2022-05-28.

Thread 96 (2022-07-14):

missin MCLR pin on my board

g14n7uca, 2022-07-14:
Purchased last week
The MCLR pin in my board is not soldered so oly 4 pins came out to connect it to pic programmer.
Suppose I have to solder one pin and then connect it to pic it 3...isn't it?
Thanks

pimol, 2022-07-14:
https://www.dropbox.com/s/jcyapzbwugt5avn/image001%20%281%29.png?dl=0

Pietro I2OIM

Il gio 14 lug 2022, 06:25 g14n7uca ***@***.***> ha scritto:

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

g14n7uca, 2022-07-14:
Thanks pietro,
I meant, miss the phisical pin on the pcboard

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

pimol, 2022-07-14:
MCLR has to be connected with a 4.7k to VCC, as indicated. Not important
that there is no pin on the  board.
Good luck

Pietro I2OIM

Il gio 14 lug 2022, 08:57 g14n7uca ***@***.***> ha scritto:

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

pimol, 2022-07-14:
Sorry, I'm not clear.
You have to put the pin in the board.

Pietro

Il gio 14 lug 2022, 09:03 Pietro Molina ***@***.***> ha
scritto:

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

g14n7uca, 2022-07-14:
...and connect it to the pic board I suppose, that was the question.

pimol, 2022-10-11:
Yes, you have to complete the connector. I had the same problem.

Pietro I2OIM

Il giorno gio 14 lug 2022 alle ore 09:10 g14n7uca ***@***.***>
ha scritto:

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

Thread 97 (2022-07-17):

mini ATU60-5X2 - L1 and L2 relays are constantly energized even during the tuning sequence

satfan52, 2022-07-17:
Hello,

I have build two N7DCC ATUs,  a QRO ATU-1200 (7X2) that works really great up to 1.2 KW, and a QRP ATU-60 (5X2) that has a strange error and does not work very well.

On my ATU-60, the two relays corresponding to L1 and L2 on the schematic diagram are constantly energized even during the tuning sequence, this corresponds to PIN 22 and 23 of the PIC16F1938. So in fact the tuner only "plays" with L3, L4 and  L5 during any tuning sequence. As L1 and L2 inductance represent 330 nh, the tuning is clearly sub-optimal especially on high bands.

I have replaced the two 2N7000, the two relays and here is no change, pin 22 and 23 of the PIC16F1938 jump to 5V after I power on the ATU-60, there is nothing I can do to prevent that. I also verified that there is no short-circuit on the PCB. I even have replaced and reprogrammed the PIC16F1938 and there is absolutely no change.

I came to the conclusion that this is either a software programming issue or a hardware issue with the three PIC16F1398 I tried (damaged during soldering ?) .

I tried with the HEX file available from this repository for the 5X2 model as well as with the original HEX file provided by the seller. The problem is the very same, it does not matter what HEX file I use. I also tried with a 7X2 hex file out of curiosity and it is the same story.

I am using a pickit2 programing tool and the latest version of pickit2Plus programming software to write to the 16F1938, could the way I program the PIC be  be the explanation for what I am seeing ?  The programming of the 16F1938 is always successful with PICKIT2/PICKIT2PLUS and any  additional verification I do after the programing is always ok!!!  so I don't understand ! Should I have used MPLAB 6.0 and a PICKIT3 or PICKIT 3.5 instead ? What is your view on this ? Thanks .

Regards. Peter/on7yi

Dfinitski, 2022-07-17:
Hi, Peter
All L relays should be energized if rested, because this shortening infictances.

satfan52, 2022-07-17:
Thanks I understand I will update the title. The point is that when launching a tuning sequence L1 and L2 remain energized all the time so the tuner plays with L3, L4, L5 only.

Dfinitski, 2022-07-17:
Start your tuner in manual mode and check again. Power up with pushed down buttons bypass and Auto. If it still there, change associated transistors or change the pic controller.

satfan52, 2022-07-17:
Thanks. I will change the pic controller. I have a PCB with a PIC16F1398-I/SS (SSOP package). These chips are out of stock with Mouser and Digikey and became very expensive (more than 6USD! ) to procure on ebay/aliexpress/taobao. Is there an alternate microchip device I could use ? I checked the PIC18F2520 but it is not available in SSOP package unfortunately :(

Dfinitski, 2022-07-18:
No, I don't know what is alternate pic. 6 usd is not so expensive on my mind.

Closed 2022-07-18.

Thread 98 (2022-07-17):

ATU 100 EXT board (Fw ver. 3.1) LCD shuts down during tuning but system continue to work

Rentiu30, 2022-07-17:
Hello! I just got my ATU 100 mini from Aliexpress and I got it with a problem.

Preconditions:
- prepare setup for 10m band (power around 20W)
- ATU connected between TRX and ANT
- both transceiver and ATU are connected on the same power supply

Procedures
1) power on the unit
2) hold tune button
3) press PTT of transceiver
4) hold tune button
5) press PTT of transceiver
6) power off + power on

Expected behaviour:
1) boot up OK, all the infos are displayed on LCD
2) SWR=TUNE show on LCD
3) start to hear relays working + LCD values updated
4) SWR=TUNE show on LCD
5) start to hear relays working + LCD values updated
6) system turns off and once turned back on the LCD values indicate last tuned values

Observed behaviour:
1) boot up OK, all the infos are displayed on LCD
2) SWR=TUNE show on LCD
3) start to hear relays working + **LCD shut off**
4) LCD is off but relay reset sound is heard
5) start to hear relays working, LCD still off
6) system turns off and once turned back on the LCD values indicate last tuned values

It looks like the LCD is powering off during tuning and not recovering after. It require a system restart. While LCD is off the system can take commands from the buttons and react based on them.
But not everytime the ATU behave like this. I can reproduce the problem 80% of the times, in the rest the ATU behave as expected

The ATU is looking like the one in the picture.
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

I am trying to figure it out if this behaviour is a SW or HW issue.

Thanks in advance,
'73 de yo8czo

nanko55, 2022-07-18:
Hi, did you try to use a common mode choke between ATU and ANT?
73's Nanko, PA0NVY

Rentiu30, 2022-07-18:
Hello! Yes, I have, and unfortunately the behaviour is the same.

Dfinitski, 2022-07-18:
Hi. Open the box and watch inside. Most likely long wires to lCD touching some coil.

Rentiu30, 2022-07-19:
I will open up the box and longer the wires to see if the problem still occur. Thank you!

pimol, 2022-07-19:
Put a small chock on these wires

Pietro (mobile)

Il mar 19 lug 2022, 08:56 Rentiu30 ***@***.***> ha scritto:

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

Rentiu30, 2022-07-19:
I'll provide feedback once done. Currently I am not near my workbench. Many thanks!

Rentiu30, 2022-07-25:
Unfortunately nothing helped. I closed everything together and store it like it is. The unit is a back up unit.
If someone have the same issue, this topic might be a good place to continue the discussions.
I will check for updates or come back if I'll manage to fix it.

Many thanks for the proposals. '73!

GitJiggyWiddit, 2023-07-07:
Hello!

I'm having this exact same issue. It only seems to happen on 10m with more than ~50W of power. Between 45-50W the screen just flickers but exceeding 50W makes it flicker then go out completely. Like the OP, the ATU appears to continue working. I'm wondering if this is some kind of interference issue. I have ferrite beads on the jumper to the panel mounted SO-239 socket and I also have a ferrite bead choke (many ferrite beads in a chain) where the feedline connects to the balun on my end-fed.

Here are the relevant components in use:
SDR: https://elekitsorparts.com/product/trx-duo-sdr-transceiver-dual-16bit-adc-with-zynq7010-2tx-2rx-ddc-duc-sdr-red-pitaya-power-sdr-sdr-sdr-console/
TR Switch: https://www.ebay.com/itm/193651220379
PA: https://www.60dbm.com/product/100w-hf-50mhz-rf-power-amplifier-rd100hhf1-based-13-5v/
LPF: https://www.60dbm.com/product/100w-hf-6m-lpf/
ATU: https://www.60dbm.com/product/atu100-7x7-n7ddc-atu-antenna-tuner-oled-0-91-display/
Antenna: 40m end-fed

Any help would be greatly appreciated!

Rentiu30, 2024-04-11:
Thank you to all the colleagues who posted.

I found a bad ground point not soldered well. It's close to the board on the display side - the solder point of the cable was glued to the board. After a resolder, the shutdown of the display lowered in occurences.

However, from time to time this still happens but I'm guessing this is due to the antenna return loss during TX. The RF return loss might disturb the sensitive controllers and cause this to happen. I would say, if the antenna (before tuning) SWR is higher than 1.7, this behaviour of the ATU could be seen again. The TRX is safe but the ATU might still be influenced from the return loss of the antenna.

It's just a guess, because I've noticed on my other transceiver with internal tuner that my surrounding appliances get disturbed after 50W of RF power, on a band where the antenna naturally is close to 2:1 SWR. The tuner does the job well but the return loss influences some electronic equipments around me during TX (disconnection of CAT interface to the PC, LCD monitor goes off and on, etc.).

If this could be the case, I would isolate somehow the ATU unit by surrounding it with copper foil, add some chokers or solder additional filtering capacitors.

If this doesn't make any sense, as I'm not an expert but just commenting out from what I've noticed, please correct me or provide a different view.

Stay safe, 73!

Thread 99 (2022-07-26):

Question about the tuning algorithm

davidhay45, 2022-07-26:
If the software version 3.2 in the routine sub_tune() there is a line

if(SWR<200 & SWR<swr_mem & (swr_mem-SWR)>100) return;

this appears to say that if the SWR is less than 2 and the tuning so far has reduced the SWR by more than 1 then do not try the "other side".

Could you possibly explain what this is doing?

Thanks

Dfinitski, 2022-07-26:
Hi. It means
If SWR after tuning less than 2.0 and less than previous trying(with other side C connection) and  SWR less than previous trying for 1.0, this trying is successful.

davidhay45, 2022-07-26:
Thanks for the reply.

So if the SWR was 2.9 before this tune and 1.85 afterwards then the tune would stop?  Or is some other logic having an effect?

Dfinitski, 2022-07-27:
This logic determines wich C position is better in case if both 2 tryings where not perfectly successful.

almost-everyone, 2023-03-28:
Hi there, I'm new here and was looking at the sources but got lost looking at the tuning code in "main.h", there's a variable named "L_invert" which if I'm not wrong, controls the L/C or C/L configuration, but apparently such a variable is never toggled, even if the function "set_ind" uses it; am I missing something ?

Dfinitski, 2023-03-28:
Hi
L_invert is the cell value flag, using for inverting of L relays control in case used 2 normally closed contacts .

almost-everyone, 2023-03-28:
> Hi L_invert is the cell value flag, using for inverting of L relays control in case used 2 normally closed contacts .

Ok, see it now, thanks !!

Thread 100 (2022-08-07):

ByPass fail

harmi99, 2022-08-07:
I am using ATU100 with 1:5 ratio and some modified cells, my 80m delta loop is quite simply adjusted to 21 and 28MHz FT8 frequencies (N-license) by ATU100 (SWR<1.4). However, something happended yesterday and I am no longer able to use delta loop at its resonant frequency around 3740kHz when connected to ATU, because ATU shows me infinite SWR after reset for 80m band, and the same behaviour even when ATU is switched off. If I connect antenna directly without ATU, I see antenna OK with low swr for 3740kHz. ATU itself is otherwise working fine, I can tune and make QSO at 21MHz and 28MHz below SWR1.3, however 3740kHz should work without ATU and it hardly tuned SWR ~1.7 with huge capacitance ~1500pF and some L. I verified all relays and they seems all changing their state, nothing seems burned out (anyhow I use qrp icom705 only). Could you pls advise where to look. Thanks, PH.

Dfinitski, 2022-08-07:
Hi. The best way connect it to nanovna and 50 ohm dummy. You will see if there is huge capacity or inductance or short.

harmi99, 2022-08-08:
David thanks,

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

This is what I found (1-switched off ATU with dummy load and nanovna connected to ATU, 2-second picture dummyload directly at ATU, 3-FAST mode on(all relays supposed to be ON)
2nd picture shows some inductance is there, because maximum of green X=46.7Ohm at ~17.96MHz, but 3rd picture has some negative values (green line minimum is -265Ohm at  19.88MHz). So probably there is a combination of L and C failure, because above 20MHz capacitance pulls reactance to negative values.

Do you have some better solution to find the issue than make shorts at L relays and unsolder C relays one by one? Thanks, PH.

Dfinitski, 2022-08-08:
Hi.
In manual mode using values 1,2,4,8,16,32,64 you can check if all the relays energase or deanergase. Also, using VNA you can check added reactance for each relay. It will take a time but I don't see any other reliable solution .

Thread 101 (2022-10-12):

More element

rembulan, 2022-10-12:
this is not an issue just stupid question,
first 5x5 then 7x7 what about 9x9 or 11x11
why ?
why not

Dfinitski, 2022-10-12:
Hi. That tuning algorithm can't do more than 7x7.
The new algorithm using in ATU-10 for now, can do that but...
We will need other MCU with more nodes and bigger case.
We will need much bigger PCB and housing due to much bigger high inductance coils.
The RF path will have much bigger own capacitance and inductance due to additional relays and big inductors. It won't work on 28 MHz or even 24 MHz. We will need to add even more relays and make this device more bigger, heavier and complicated.
It will be more smarter to have 2 small inexpensive devices - one 5x5 for higher bands and second 5x5 lower bands. 10x10 in total :)

rembulan, 2022-10-12:
I like it,
my question based from if we have more element the tuning is smoother but maybe I am wrong

Dfinitski, 2022-10-12:
I got you. What's wrong with a smoothness now ?

rembulan, 2022-10-12:
nothing I have 3 pcs 7x7, nothing is wrong work perfect with multiband rotary dipole, threebander yagi and multi wire dipole.
but If I can ask for wider range I think of inverted L antenna for 160m and 640m and or smoother I will more than happy.

Thread 102 (2022-10-23):

Noise

I4jxe, 2022-10-23:
HI to all.
I got an assembled cinese ATU, working automatic only, with PIC 16F1938  firmware 3.1.
When switched on it pull out noise to my Yaesu FT818 such as to made it unusable for me.
Is this a common and known issue of the project that can be solved ?
TIA es 73
Gabriele,  I4JXE

pimol, 2022-10-23:
Gabriele,

con cosa lo alimenti? Se è uno switching potrebbe essere la causa. Riesci a
provare con una batteria?
What are you using as power supply? If it's a switching it could be the
cause. Can you try with a battery?

Pietro I2OIM

Il giorno dom 23 ott 2022 alle ore 06:59 I4jxe ***@***.***>
ha scritto:

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

I4jxe, 2022-10-23:
Grazie per la risposta.
Il mio ATU è alimentato dalla propria batteria interna dato che pensavio di utilizzarlo per attività mobile a bassa potenza. Con circa 2,5 W out accorda perfettamente (il venditore specifica 1 W minimo, ma  mi va bene così).. Quanto ai 100 W max indicati....mah. Comunque non ci provo....
Prima di rispedirlo al mittente vedrò di fare qualche prova strumentale,, ma ho la vaga impressione che il noise sia generato dal display..Pensavo alla soluzione di escluderne il funzionamento in ricezione, via modifica hw o fw... Che ne pensi ?
73, Gabriele

pimol, 2022-10-23:
Ho un atu anch'io, comprato finito.
Ma il mio non accorda a 144, il limite dichiarato è i 6 metri a cui
peraltro non inserisce nulla perchè l'antenna risuona bene.
Lo hai modificato?
Io ho cambiato solo un parametro per farlo accordare con 5W, senza
modificare altro, altrimenti ne servivano 10. Quando uso i due metri lo
spengo ma l'antenna per i 2 metri usa il connettore frontale, per i 6-40
metri quello posteriore, quindi non saprei dirti se genera rumore.

Pietro (via Tablet)

Il dom 23 ott 2022, 10:19 I4jxe ***@***.***> ha scritto:

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

Thread 103 (2022-12-08):

Milan Stejskal

ok1if, 2022-12-08:
I am the proud owner of an ATU-100
EXT, purchased on Aliexpress. Let me thank the author of SW for a perfect job. But what is my problem? My antenna (Long wire), for example, at a frequency of 3558 kHz, shows an impedance of approx. 352-j1060 ohm. That is, a high-impedance matter, where, by calculation from the Smith diagram, the antenna must be matched to the ground with a capacity of approx. 67pF and an inductance in series of approx. 18.8 uH. Of course, the original ATU-100 cannot do that. (max inductance is approx. 8.5uH). So I solved my case by inserting new inductances in the series: 0.1uH 0.2uH 0.4uH 1.0uH 2.1uH 4.3uH and I chose the largest inductance 8.6uH. Therefore, the ATU-100 should be able to tune this antenna. During the experiment, however, it tests both low and high impedance and usually moves with a maximum inductance of approx. 8uH. So he won't tune the antenna. I believe that it is caused by the SW and that is so that the capacities are not overloaded with voltage (they are only up to 500V). However, I do not want to use a tuner up to 100W, but only up to about 30W. So I know what's at stake and I don't mind. To fine-tune the antenna, I switch the tuner to TEST MODE and manually set the maximum inductance and capacity for high impedance. Everything works to my satisfaction. Unfortunately, such a transition is lengthy. My question:
1. If the max. inductance is limited by SW to 8uH, wouldn't it be possible to modify the program?
2. Alternatively, I have a suggestion: As soon as the tuner, even with 8uH protection, could not tune the antenna after several attempts, it could not switch to TEST MODE after these attempts, thereby changing the function of the TUNE AOUTO BYP buttons, of course with the last value of L and C set, so that I can continue tuning manually? Sometimes this would also be useful in automatic mode, when due to the large step L or C, it does not adjust to the optimal value.
I apologize for any inappropriate suggestions.

Milan
OK1IF (OL4W)

ok1if, 2022-12-08:
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

ok1if, 2022-12-08:
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

ok1if, 2022-12-08:
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

Dfinitski, 2022-12-12:
Hi, Milan
Join to our group for the conversation
https://groups.io/g/ATU100/topics

I have a new better tuning algorithm, I want to implement it soon in the
ATU-100

On Thu, Dec 8, 2022, 10:58 AM Milan Stejskal ***@***.***>
wrote:

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

ok1if, 2022-12-12:
OK David
Thank you
Milan
 
______________________________________________________________
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
 
Hi, Milan
 Join to our group for the conversation
 https://groups.io/g/ATU100/topics

 I have a new better tuning algorithm, I want to implement it soon in the
 ATU-100

 On Thu, Dec 8, 2022, 10:58 AM Milan Stejskal ***@***.***>
 wrote:

 > Reopened #103
 > <https://github.com/Dfinitski/N7DDC-ATU-100-mini-and-extended-boards/issues/103>
 > .
 >
 > —
 > Reply to this email directly, view it on GitHub
 > <https://github.com/Dfinitski/N7DDC-ATU-100-mini-and-extended-boards/issues/103#event-7990520406>,
 > or unsubscribe
 > <https://github.com/notifications/unsubscribe-auth/AD6YS2IT7AGCMNCFXJPOAULWMIATPANCNFSM6AAAAAASYHP7JE>
 > .
 > You are receiving this because you are subscribed to this thread.Message
 > ID:
 > <Dfinitski/N7DDC-ATU-100-mini-and-extended-boards/issue/103/issue_event/7990520406
 > @github.com>
 >
—
Reply to this email directly, view it on GitHub <https://github.com/Dfinitski/N7DDC-ATU-100-mini-and-extended-boards/issues/103#issuecomment-1347155090>, or unsubscribe <https://github.com/notifications/unsubscribe-auth/AIGS7BWFGALA2J7Q4UPR5ULWM53QRANCNFSM6AAAAAASYHP7JE>.
You are receiving this because you modified the open/close state.Message ID: ***@***.***>

ok1if, 2023-03-17:
Hi David
Is there anything new about the new algorithm? I could help you as a beta tester.

73

Milan
OK1IF (OL4W)
______________________________________________________________
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
 
Hi, Milan
 Join to our group for the conversation
 https://groups.io/g/ATU100/topics

 I have a new better tuning algorithm, I want to implement it soon in the
 ATU-100

 On Thu, Dec 8, 2022, 10:58 AM Milan Stejskal ***@***.***>
 wrote:

 > Reopened #103
 > <https://github.com/Dfinitski/N7DDC-ATU-100-mini-and-extended-boards/issues/103>
 > .
 >
 > —
 > Reply to this email directly, view it on GitHub
 > <https://github.com/Dfinitski/N7DDC-ATU-100-mini-and-extended-boards/issues/103#event-7990520406>,
 > or unsubscribe
 > <https://github.com/notifications/unsubscribe-auth/AD6YS2IT7AGCMNCFXJPOAULWMIATPANCNFSM6AAAAAASYHP7JE>
 > .
 > You are receiving this because you are subscribed to this thread.Message
 > ID:
 > <Dfinitski/N7DDC-ATU-100-mini-and-extended-boards/issue/103/issue_event/7990520406
 > @github.com>
 >
—
Reply to this email directly, view it on GitHub <https://github.com/Dfinitski/N7DDC-ATU-100-mini-and-extended-boards/issues/103#issuecomment-1347155090>, or unsubscribe <https://github.com/notifications/unsubscribe-auth/AIGS7BWFGALA2J7Q4UPR5ULWM53QRANCNFSM6AAAAAASYHP7JE>.
You are receiving this because you modified the open/close state.Message ID: ***@***.***>

ok1if, 2023-09-15:
Hi David

What is new in new algorithm?

Milan
OK1IF

______________________________________________________________
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

Thread 105 (2023-01-04):

atu-100 coils

m3vuv, 2023-01-04:
i have just got one of these kits,no instuctions whatsoever,just a schematic and bom,i need the coil winding data for the torroids,is this available?,thanks in advance 73 de m3vuv.

Dfinitski, 2023-01-04:
Hi. Check the schematic again.

m3vuv, 2023-01-05:
this is a crappy chinnese kit,there is no coil data only the inductance,i need to know the number of turns etc,cheers +73

Dfinitski, 2023-01-05:
You can find the schematic right here in files .

Thread 106 (2023-01-18):

ATU-100

BOBruger, 2023-01-18:
I need some help!! I trying to put the tuner into a Amplifier for tuned input..I need to run 12 volt lines to it..From what I have read that is all I need to wire to it.. plus the input and output cables..once I apply 10 watts to the tuner it should work but it does not..What am I missing here?

Dfinitski, 2023-01-18:
Hi.
You can find here schematic and user manual

вт, 17 янв. 2023 г. в 23:29, BOBruger ***@***.***>:

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

Thread 107 (2023-05-24):

ATU-100 Stuck in Bypass

Rimon105, 2023-05-24:
Hello all,
i have been using my ATU-100 for the past couple of months with no issues. however, 2 weeks ago it stopped tuning. the display shows its in bypass mode and none of the buttons are changing it. i used test mode to confirm the buttons work but when its booted normally, it again goes into bypass. this was a kit but i have gone back over my solder joints already and double checked my windings (ill triple check soon). Any sugestions?

Rimon105, 2023-05-25:
> Hi. I would check a voltage on the buttons.

Hello, i checked the voltage across the buttons. Bypass is .01v, auto is 3.8v, and tune is 4.8v.

Dfinitski, 2023-05-25:
Bypass is shorted. Check the connection.

Thread 108 (2023-05-25):

AT 100 stop tune on HIGH SWR 9.99

nex2000, 2023-05-25:
Congratulations DAVID for the excellent work shared with all of us.

I built a new AT-100 with CPU 18F2520 I used different firmwares but always get the same effect.

The power is correct and also the SWR but on all frequencies the tuner stops with high SWR 9.99. I see that it does not stop when the SWR is low. He can't find an agreement and continues to turn.

I used two 500 ohm series resistor as dummy load.

Do you have any indication of a probable failure?

Regards NEX

nex2000, 2023-05-25:
Sorry , I mistakenly mounted SPDT relays instead of DPDT :-)

Thread 109 (2023-05-27):

Possible PC control?

vader7071, 2023-05-27:
I just got my hands on a unit and I will be putting it on my FT-8 setup. However, my setup is a remote location (in my detached workshop) so being able to manually press the tune button is not an option unless I run out to the shop everytime I change bands.

Would it be possible to write a Python program to be able remotely control the unit through the USB port from the computer? I have successfully done this with an arduino and my antenna switch.

Dfinitski, 2023-05-27:
Hi. I saw some solutions on
https://groups.io/g/ATU100/topics
But the tuner can work in fully automatic mode so I don't see any reason to do a remote control.

vader7071, 2023-05-27:
Thank you, however the unit I have has only the single button on front (running fw 3.2) and the micro USB charging port. I don't have the bypass or auto buttons, and I can't find points RB1 or RB2 on the board to be able to add the 2 buttons.

I'm reading the manual, and I believe the unit is a manual operation (push the button to tune) and requires the "auto-switch" to have it automatically adjust. Am I reading this incorrectly?

Dfinitski, 2023-05-28:
Yes, most likely it is in manual mode.
You have two ways to turn it on
1. Open device and find the button connection on the bottom of board and connect needed buttons.
2. But Pickit3 programmer on ebay and reprogram the MCU with needed cells value . With the programmer you can change others parameters also .

vader7071, 2023-05-28:
To make sure, this is the item I need?

[eBay pickit 3 programmer](https://www.ebay.com/itm/331901057989)

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

Dfinitski, 2023-05-28:
Yes it is.

Thread 110 (2023-06-11):

Random wire antenna High Impedance

nex2000, 2023-06-11:
I mounted an ATU 1000 and I noticed that if you keep close you have 50 ohms everything works fine but with high impedance the tuning stops with high SWR around 3 or 6 .

Power and SWR readings are correct

Is there a solution to this problem?

Regards

Dfinitski, 2023-06-12:
Hi.
I would check all the relay's joint soldering and C and L actual values after that.
Also you can use the fast_test and manual mode to be sure all the relay's switching correctly.
Join to our conversation group on groups. Io. Group's name ATU-100.

Thread 111 (2023-09-07):

No luck driving a 1602 display

radiowonk, 2023-09-07:
I would like to use a larger display like a 1602 with I2C serial adaptor. I can successfully change the address (27 in my case) and display type (01) eeprom fields with my Pickit3 but when I power up with a 1602 I don't get any characters on the display, just a top row of pixels all on and bottom row of pixels all off. I can successfully change the fields back to my original 128x64 display address (78) and display type (05) and it works fine. I can also upgrade firmware with good success.
Suggestions of what I might do differently or of other larger displays that are compatible.

Dfinitski, 2023-09-07:
Hi. You can use 2.42" oled i2c display.

https://www.ebay.com/itm/125420100007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

Thread 113 (2023-10-30):

Remote buttons and display

nex2000, 2023-10-30:
perhaps this problem has already been discussed, I would like to install the tuner on the pole, obviously I will lose control of the display and buttons. Has anyone thought about remote control of the ATU100?

For the buttons it's very easy it is possible use a RS485 communications , for the display I don't know how to do it
Has anyone faced this variant?
Thank you

Dfinitski, 2023-10-31:
This tuner works well with no any buttons or display in full automatic mode.

MOUSE1025, 2023-10-31:
I have considered a remote tuner application as well.
Although I am not as interested in the display as I am the controls. The
thought of running a multi-conductor cable 100' gave me a
headache!
A Bias-T to power the tuner, and a wireless controller up the coax, not
through an antenna, can provide the necessary control(s) for the tuner. All
of this hardware can be
built for very little money.
My remote tuner is in a die-cast weatherproof enclosure with U-Bolt
mounting. The controls (momentary buttons, are on the bias-T. I did add a
latching feature for LED's to inform me of the status of the buttons.
I can provide additional information, such as pix and schematic. Very
simple project.
Regards,
Christopher

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

OneOrphan, 2025-02-20:
I have 75' of rotor cable on its way.  I'm not sure how to wire for everything. I have project boxes a-plenty.  It is a typical 6/2 cable...I think.  My unit is a ATU-350.  Like the 100's, extended board and such.

Kind regards,
Dick - KA5KKT

MOUSE1025, 2025-02-20:
Forget the wire...use wireless control  with a bias-t for power.
K7VZD
TACTICALRADIOGEAR.COM

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

OneOrphan, 2025-02-20:
12v dc will not work with my remote antenna switch...goes to ground when not selected.

MOUSE1025, 2025-02-22:
Are you using a Bias-T?
 Christopher

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

MOUSE1025, 2025-02-22:
I missed your earlier posting. There is a way to position the antenna
switch so that it is out of the DC path. I have a wireless contro, that
only requires a single DC +12V signal. The receiver/controller has a
antenna switch integrated into the design.
Christopher

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

Thread 114 (2023-12-23):

AT1000 strange behavior

nex2000, 2023-12-23:
I assembled a piece of AT1000 everything seems to work the power is correct the ROS is correct. But on some bands I notice a strange behavior, the tuner instead of choosing the lowest ROS stops at a high value. I see in the rosometer during the tuning that there are low values but it stops at high values. This only happens on some bands

Thread 115 (2024-07-14):

display not working after freeze

nathanielc, 2024-07-14:
I recently built the kit and it was working well. However the display stopped updating when I was using it, so I turned the device off and on. When powered back up the display no longer works. The tuning function does still work, I can here the relays clicking and can measure a low swr though the tuner.

I bought a replacement display thinking it was a defective unit but the new display doesn't work either. Any ideas what to check next? Would reflashing the pic be of any use?

I can confirm the display gets 5v vdd when powered on. But otherwise don't have tools to check the clock or data pins.

Thanks

Dfinitski, 2024-07-15:
Hi. If you have a simple multimeter, check the SCL and SDA lines, what is voltage there . When the device is powered off, check a short to ground, Vdd or each other.

nathanielc, 2024-07-15:
When the device is powered on voltage on each pin is:

VCC: 5.00V
SCL: 3.75V
SDA: 0.22V

When the device is powered off checking short to ground the SDA pin has only ~175 ohms to ground. All other pins are not shorted. Is this expected? Thanks for the debugging direction.

Dfinitski, 2024-07-15:
Seems like SDA port on the PIC has burned.

nathanielc, 2024-07-15:
Ok I'll try to replace it, thanks for the help. Found the part here https://www.mouser.com/ProductDetail/Microchip-Technology/PIC16F1938-I-SS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

Thread 116 (2024-09-29):

Test mode

ascarons22, 2024-09-29:
Does anyone have any idea why the capacitance test is not possible in test mode? The inductance test is no problem. I also deduce that this error causes the ATU to not work. Any ideas?

Dfinitski, 2024-09-30:
You can change L or C and also C connection point in the test mode.

ascarons22, 2024-09-30:
What is that point?, because I have been trying to make the tuner work for several days and it does not work, I have the feeling that the pic does not work properly.

Dfinitski, 2024-09-30:
Short and long pressing of the middle button changes what will you change
with the left and right buttons. L or C or C connection point

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

ascarons22, 2024-09-30:
Yes, I know that point, but the capacitor test does nothing, only the inductor test works at the same time as the relays sound, the tuner is not activated either, so I deduce that it is a problem with the pic, lower power to 1w and it does not activate.

Dfinitski, 2024-09-30:
I don't know what are you meaning under "capacitor test" and "inductors test" . The re is only one manual (test) mode where you can check every capacitor and every inductor.
Also, there is the fast test when all the relays turned on.
What mode are you using and watch the problem ?

ascarons22, 2024-10-01:
The problem is that when pressing ptt on a kenwood ts-430s the atu 100 does nothing, it does not tune, version 3.2.

Dfinitski, 2024-10-01:
Ok, the power and swr values on the display are correct ?

ascarons22, 2024-10-01:
NoNo value, pulse ptt and shows nothing,The LCD shows 0, ptt pulse, shows 0, no relay sound.

Dfinitski, 2024-10-02:
Obviously, if no power so no ATU reaction on nothing. Try to figure out why the power is not going to the Stockton measuring bridge.

ascarons22, 2024-10-02:
Ok, today I will check, my equipment is a kenwood ts-430s, it is old but it works, so I deduced that it was the pic, but I will check the reflection bridge as you say, the only different thing that mounts 51 ohm resistors instead of 49.9, I will check it and inform you if I have advances.

Dfinitski, 2024-10-02:
Are you sure not installed 0.5 OHm ? What is the marking on them ?

ascarons22, 2024-10-02:
Resistor code 510

Dfinitski, 2024-10-02:
R510 ? Or 510 without R ? Better check them with a multimeter just in case. Also double check where is an input and output on the board .

ascarons22, 2024-10-02:
510 Without r, with multimeter it behaves as a short circuit, 0.3 ohm

Dfinitski, 2024-10-02:
Marking is good, but every modern multimeter is able to measure 50 ohm. You have to desolder them first,  if they on board, they will be in short circuit, it is normally.

ascarons22, 2024-10-02:
Tomorrow I will try, with other diodes it doesn't work either, but the tip of the soldering iron touching ground causes it to measure something, but not when pressing PTT. Tomorrow I will replace resistors, I have another kit on the way, until then I will keep you informed of my progress.

ascarons22, 2024-10-10:
> La marca es buena, pero cualquier multímetro moderno puede medir 50 ohmios. Primero hay que desoldar los cables, si están en la placa, se producirá un cortocircuito, es normal.

Hello, I did some tests and everything is ok, I tried other diodes, resistors, changed the pic and nothing at all, I ordered another atu 100, I mounted it and the same situation, so I deduce the problem is somewhere else. Is there any way to tune manually using an extra button? Regards

ascarons22, 2024-10-10:
solved, you can call me a noob, when making the patch cord to connect the tuner to the radio I made a short and that's why it didn't work, thanks for your help.

Closed 2025-10-05.

Thread 117 (2024-11-19):

Voltage values

OK1TK, 2024-11-19:
Hi guys, juset interesting. What are the voltage values or voltages ranges on R1, R2 and then on the RA0/AN0
 and RA1/AN1 ?

OK1TK, 2024-11-27:
Based on the topic [heere](https://github.com/Dfinitski/N7DDC-ATU-100-mini-and-extended-boards/issues/117) I calculated thare should by ca 12V on the tandem-match output and ca 3.8V on the FWD/ RVS pins of the PIC for 150W. I hope that's correct.

Dfinitski, 2024-11-27:
Hi, yes 4.2 volts is the maximum value for pic ADC inputs

OK1TK, 2024-11-28:
> Hi, yes 4.2 volts is the maximum value for pic ADC inputs

Thank you David and the AC voltage alternativní the tandem-match I calculated ca 12V for 150W. Is that also correct ?

Dfinitski, 2024-11-28:
Yes, that is right. The maximum measuring power is about 150W when 10:1 tandem match ratio.

Thread 118 (2025-01-17):

AN= on display during Tx

Bruce-N6BMW, 2025-01-17:
I cannot find a description of what this metric is. Is it the actual forward or reflected power? Please explain. Thank you.

Dfinitski, 2025-01-17:
ANT - the power applied to antenna after all the loss calculations, fider loss and SWR loss. Read the cell description on the manual for more.

Bruce-N6BMW, 2025-01-17:
I get this error when trying to access the manual here in the files section: **Error rendering embedded code: Invalid PDF**
https://github.com/Dfinitski/N7DDC-ATU-100-mini-and-extended-boards/blob/master/ATU_100_EXT_board/ATU_100_EXT_board_User_Manual/ENG_ATU-100_Extended_Board_User_Manua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

Bruce-N6BMW, 2025-01-17:
Cell 34?

Dfinitski, 2025-01-17:
34 — cell for setting a feeder power loss ratio, the first number — integer part of decibell, second number — ten’s parts of decibell. Velue by default — 1.2 (12 writen in the cell). this value uses for counting the power delivered to antenna. The loss value can be found in the reference data for the used cable or you can measure the exact value yourself. If it is not necessary to take into account feeder losses, the value 00 should be written into the cell, then the calculations will correspond only to the mismatch losses.

Dfinitski, 2025-01-17:
New in the version 3.1
The fider loss value now is zero by default, the tuner board shows mismatch loss only. To install your actual fider loss, power on the board with pushed TUNE button, use BYP and AUTO buttons to set needed value. The value will be saved immediatelly in the long-term memory (0x34 cell for extended board or 0x32 cell for mini boards).

Bruce-N6BMW, 2025-01-17:
Thank you!!!
BTW, I am using an ATU-500 with the AT-100 v3.2 board.

On Fri, Jan 17, 2025 at 9:45 AM David Fainitski ***@***.***>
wrote:

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

Dfinitski, 2025-01-17:
Same thing.
If you dont want to see antenna power you can switch it off in cell 33.

Thread 119 (2025-01-17):

Schematic - Swapped FWD/RVS Labeling ?

OK1TK, 2025-01-17:
Hi, I'm trying to fully understand the tuner schematic, and I've noticed that when I compare the schematic with the PCB, it seems that the labeling of the **FWD** and **RVS** signal connections to the bus near the branches **R1, D1...** and **R2, D2...** might be reversed—or am I misunderstanding something?

According to the schematic, the **RVS** signal should go through **D1** and the **FWD** signal through **D2**. This means that **two outputs** from the Tandem Match should go to **D2**, and **one output** should go to **D1**.

However, when I look at the board, it appears that **D1** is connected to **two outputs** from the Tandem Match, and **D2** to **only one**.

I'm basing this on the available **Gerber files**. Unfortunately, I only have assembled tuners, so I can't directly verify this on the PCB, but I assume it's the same.

Could someone please clarify this for me?

Thank you in advance!

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

OK1TK, 2025-01-17:
Thanks David for your reply. May be I just don’t see it correctly. Which one of the diodes on your pic is the D1  and is it correct that RVS goes through D1? Is it upper one or the bottom one ?

Dfinitski, 2025-01-17:
I dont know, actually it does not matter. the schematic could has mistake with RVS/FWD, i dont see any problem, you can change those assigment just making tandem match with different coil direction or wrongful connection of the voltage coiles.
No any phasing dots on the schematic as you can see, so it is not defined where is what.

You can use free Sprint Layout Viewer to see the current PCB, it is fully working trust me.

Thread 120 (2025-02-07):

Connecting main board to display

RichFinnis, 2025-02-07:
I have just purchased an assembled kit, the n7dcc atu 100 extended board.
I am not sure how to connect them together.
There are 5 pins on the main board - mclr  vcc  gnd  dat  ck
The pins for the lcd (1202) are gnd  vcc  sda sci.
The gnd and vcc are obvious but I am not sure where the sda and sci from the display go to.
There are no instructions on the selling site but it references me here.
My electronics knowledge is basic to say the least, so that is why I purchased the built and tested kit.
I have tried studying the schematics to see if I can fathom anything out.
Any help appreciated - thanks in advance.
Rich GWOHDY

Dfinitski, 2025-02-07:
Hello
SDA - serial data
SCL - serial clock

RichFinnis, 2025-02-07:
Thanks for the fast reply -really appreciated. (so I assume ck on the board refers to clock).

Thread 121 (2025-02-09):

Maximum  input power for initial tuning

RichFinnis, 2025-02-09:
What is the minimum and maximum input powers for tuning please.

Dfinitski, 2025-02-09:
Depends on cells settings, see the manual.

RichFinnis, 2025-02-10:
David, thanks for the reply. However I realise I should not have posted
on your site. Getting rather confused with who is who.
I purchased a pre assembled and tested board from a site in Ukraine,
which trades as 60dbm but owned by an American living in the states.
It is sold with no documentation and refers folk to Github N7 DDC for
further information. However unless I am able to read the installed
firmware (which I am unable to)
I have no way of knowing what parameters  have been set for the min and
max powers. At the moment I have had no response. Having read the manual
I realise the importance of knowing
what the power parameters have been set to. Unless I hear from the
manufacturer imminently I may return the board or start feeding the atu
with 5 watts and increasing until I get the 
overload message then I will have some idea of max power.
 
------ Original Message ------
From: ***@***.***
To: ***@***.*** Cc:
***@***.***; ***@***.***
Sent: Sunday, February 9th 2025, 21:19
Subject: Re: [Dfinitski/N7DDC-ATU-100-mini-and-extended-boards] Maximum
input power for initial tuning (Issue #121)
 
 
Depends on cells settings, see the manual.
—
Reply to this email directly, view it on GitHub
<https://github.com/Dfinitski/N7DDC-ATU-100-mini-and-extended-boards/issues/121#issuecomment-2646605689>
, or unsubscribe
<https://github.com/notifications/unsubscribe-auth/BFUDMQTI4QXKZDZVIHGPQP32O7A63AVCNFSM6AAAAABWZEX4FKVHI2DSMVQWIX3LMV43OSLTON2WKQ3PNVWWK3TUHMZDMNBWGYYDKNRYHE>
.
You are receiving this because you authored the thread.Message ID:
***@***.***>

RichFinnis, 2025-02-10:
I really appreciate your help - thank you very much.
 
------ Original Message ------
From: ***@***.***
To: ***@***.*** Cc:
***@***.***; ***@***.***
Sent: Monday, February 10th 2025, 12:26
Subject: Re: [Dfinitski/N7DDC-ATU-100-mini-and-extended-boards] Maximum
input power for initial tuning (Issue #121)
 
 
Hello.
As I know 60dhm business officially registered in USA, but I don't have
any relationship to that.
I have opened the manual and found needed value in the table together
with other helpful data
Screenshot_20250210-062005.png (view on web)
<https://github.com/user-attachments/assets/db79ebf6-585f-426f-ae4f-47945355848b>
—
Reply to this email directly, view it on GitHub
<https://github.com/Dfinitski/N7DDC-ATU-100-mini-and-extended-boards/issues/121#issuecomment-2647841438>
, or unsubscribe
<https://github.com/notifications/unsubscribe-auth/BFUDMQV46ESAGDXD7KGF2OT2PCLIXAVCNFSM6AAAAABWZEX4FKVHI2DSMVQWIX3LMV43OSLTON2WKQ3PNVWWK3TUHMZDMNBXHA2DCNBTHA>
.
You are receiving this because you authored the thread.Message ID:
***@***.***>

Thread 122 (2025-02-15):

Any suggestions please

RichFinnis, 2025-02-15:
Hello  Folks,

I purchased an ATU100 7x7 N7DDC Assembled & tested board WITH 1602 LCD.

When it is powered up and connected to tx the lcd lights up but is blank.

I have purchased 2 new coax leads which have been checked for continuity etc plus have even changed the connecting wires which have also been checked for continuity.
These leads have been connected as follows -
Gnd to gnd
vcc to vcc
sda to data
scl to clk
mlr not connected

Set tx power to 5 watts and operated keyer but the display remains blank.
I have tried operating mic with no change to display.

Not sure if I am missing something but any help or suggestions appreciated.

Thanks in anticipation.

Rich GW0HDY

Dfinitski, 2025-02-15:
Hello.
The LCD should to show info after power up.
Probably the LCD board has a different I2C address or it is SPI version.
Ask the seller about this.

RichFinnis, 2025-02-16:
Hello,
Thanks for the reply. I will do this and await his response.

RichFinnis, 2025-03-06:
Hello David,

With regards to your last reply to me, I never got an answer from the seller.
At the moment I am not in a position to investigate the 12c address.
You question if the lcd board could be an SPI version. Is there any way of visually checking this or if I purchased an lcd board does it have a specific name so that I know i am not purchasing an SPI version? Or is this set up within the firmware?

Any comments appreciated.

Richard

Dfinitski, 2025-03-06:
Hi.
Purchase this LCD board and try to connect it.

[](https://www.ebay.com/itm/224176232486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)

RichFinnis, 2025-03-07:
Hi,
Thanks for swift reply.
Board ordered and will try that.

RichFinnis, 2025-03-29:
Hi All,

Board received but did not change things.

I have received full refund from Ebay, I do not have the skills to identify the problem - questions re firmware leave me with suspicions. However, if anyone in UK wants this I will send it to you provided you pay postage.
Its a pity as the soldering/construction is excellent.

Rich

davidhay45, 2025-03-30:
I’ll try and diagnose the issue. How much is uk postage?

Rgds

David

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

RichFinnis, 2025-03-30:
David,
 
A local club member collected this before I had seen your email.
 
Thanks for your interest.
 
Rich
 
------ Original Message ------
From: ***@***.***
To: ***@***.*** Cc:
***@***.***; ***@***.***
Sent: Sunday, March 30th 2025, 10:11
Subject: Re: [Dfinitski/N7DDC-ATU-100-mini-and-extended-boards] Any
suggestions please (Issue #122)
I’ll try and diagnose the issue. How much is uk postage? <br> <br> Rgds
<br> <br> David <br> <br> On Sat, Mar 29, 2025 at 20:10 RichFinnis
***@***.***&gt; wrote: <br> <br> &gt; Hi All, <br> &gt; <br> &gt; Board
received but did not change things. <br> &gt; <br> &gt; I have received
full refund from Ebay, I do not have the skills to <br> &gt; identify
the problem - questions re firmware leave me with suspicions. <br> &gt;
However, if anyone in UK wants this I will send it to you provided you
pay <br> &gt; postage. <br> &gt; Its a pity as the
soldering/construction is excellent. <br> &gt; <br> &gt; Rich <br> &gt;
<br> &gt; — <br> &gt; Reply to this email directly, view it on GitHub
<br> &gt;
&lt;https://github.com/Dfinitski/N7DDC-ATU-100-mini-and-extended-boards/issues/122#issuecomment-2764225804&gt;,
<br> &gt; or unsubscribe <br> &gt;
&lt;https://github.com/notifications/unsubscribe-auth/AIDDH7PTOMHR5KAMVQZS2O32W3V2JAVCNFSM6AAAAABXGVMDYOVHI2DSMVQWIX3LMV43OSLTON2WKQ3PNVWWK3TUHMZDONRUGIZDKOBQGQ&gt;
<br> &gt; . <br> &gt; You are receiving this because you are subscribed
to this thread.Message <br> &gt; ID: <br> &gt;
&lt;Dfinitski/N7DDC-ATU-100-mini-and-extended-boards/issues/122/2764225804@
<br> &gt; github.com&gt; <br> &gt; [image: RichFinnis]*RichFinnis* left
a comment <br> &gt;
(Dfinitski/N7DDC-ATU-100-mini-and-extended-boards#122) <br> &gt;
&lt;https://github.com/Dfinitski/N7DDC-ATU-100-mini-and-extended-boards/issues/122#issuecomment-2764225804&gt;
<br> &gt; <br> &gt; Hi All, <br> &gt; <br> &gt; Board received but did
not change things. <br> &gt; <br> &gt; I have received full refund from
Ebay, I do not have the skills to <br> &gt; identify the problem -
questions re firmware leave me with suspicions. <br> &gt; However, if
anyone in UK wants this I will send it to you provided you pay <br> &gt;
postage. <br> &gt; Its a pity as the soldering/construction is
excellent. <br> &gt; <br> &gt; Rich <br> &gt; <br> &gt; — <br> &gt;
Reply to this email directly, view it on GitHub <br> &gt;
&lt;https://github.com/Dfinitski/N7DDC-ATU-100-mini-and-extended-boards/issues/122#issuecomment-2764225804&gt;,
<br> &gt; or unsubscribe <br> &gt;
&lt;https://github.com/notifications/unsubscribe-auth/AIDDH7PTOMHR5KAMVQZS2O32W3V2JAVCNFSM6AAAAABXGVMDYOVHI2DSMVQWIX3LMV43OSLTON2WKQ3PNVWWK3TUHMZDONRUGIZDKOBQGQ&gt;
<br> &gt; . <br> &gt; You are receiving this because you are subscribed
to this thread.Message <br> &gt; ID: <br> &gt;
&lt;Dfinitski/N7DDC-ATU-100-mini-and-extended-boards/issues/122/2764225804@
<br> &gt; github.com&gt; <br> &gt; <br>
—
Reply to this email directly, view it on GitHub
<https://github.com/Dfinitski/N7DDC-ATU-100-mini-and-extended-boards/issues/122#issuecomment-2764464627>
, or unsubscribe
<https://github.com/notifications/unsubscribe-auth/BFUDMQVFNF5RLLYF5LKVEK32W6YNDAVCNFSM6AAAAABXGVMDYOVHI2DSMVQWIX3LMV43OSLTON2WKQ3PNVWWK3TUHMZDONRUGQ3DINRSG4>
.
You are receiving this because you authored the thread.Message ID:
***@***.***>
davidhay45davidhay45 left a comment
(Dfinitski/N7DDC-ATU-100-mini-and-extended-boards#122)
<https://github.com/Dfinitski/N7DDC-ATU-100-mini-and-extended-boards/issues/122#issuecomment-2764464627>
I’ll try and diagnose the issue. How much is uk postage? <br> <br> Rgds
<br> <br> David <br> <br> On Sat, Mar 29, 2025 at 20:10 RichFinnis
***@***.***&gt; wrote: <br> <br> &gt; Hi All, <br> &gt; <br> &gt; Board
received but did not change things. <br> &gt; <br> &gt; I have received
full refund from Ebay, I do not have the skills to <br> &gt; identify
the problem - questions re firmware leave me with suspicions. <br> &gt;
However, if anyone in UK wants this I will send it to you provided you
pay <br> &gt; postage. <br> &gt; Its a pity as the
soldering/construction is excellent. <br> &gt; <br> &gt; Rich <br> &gt;
<br> &gt; — <br> &gt; Reply to this email directly, view it on GitHub
<br> &gt;
&lt;https://github.com/Dfinitski/N7DDC-ATU-100-mini-and-extended-boards/issues/122#issuecomment-2764225804&gt;,
<br> &gt; or unsubscribe <br> &gt;
&lt;https://github.com/notifications/unsubscribe-auth/AIDDH7PTOMHR5KAMVQZS2O32W3V2JAVCNFSM6AAAAABXGVMDYOVHI2DSMVQWIX3LMV43OSLTON2WKQ3PNVWWK3TUHMZDONRUGIZDKOBQGQ&gt;
<br> &gt; . <br> &gt; You are receiving this because you are subscribed
to this thread.Message <br> &gt; ID: <br> &gt;
&lt;Dfinitski/N7DDC-ATU-100-mini-and-extended-boards/issues/122/2764225804@
<br> &gt; github.com&gt; <br> &gt; [image: RichFinnis]*RichFinnis* left
a comment <br> &gt;
(Dfinitski/N7DDC-ATU-100-mini-and-extended-boards#122) <br> &gt;
&lt;https://github.com/Dfinitski/N7DDC-ATU-100-mini-and-extended-boards/issues/122#issuecomment-2764225804&gt;
<br> &gt; <br> &gt; Hi All, <br> &gt; <br> &gt; Board received but did
not change things. <br> &gt; <br> &gt; I have received full refund from
Ebay, I do not have the skills to <br> &gt; identify the problem -
questions re firmware leave me with suspicions. <br> &gt; However, if
anyone in UK wants this I will send it to you provided you pay <br> &gt;
postage. <br> &gt; Its a pity as the soldering/construction is
excellent. <br> &gt; <br> &gt; Rich <br> &gt; <br> &gt; — <br> &gt;
Reply to this email directly, view it on GitHub <br> &gt;
&lt;https://github.com/Dfinitski/N7DDC-ATU-100-mini-and-extended-boards/issues/122#issuecomment-2764225804&gt;,
<br> &gt; or unsubscribe <br> &gt;
&lt;https://github.com/notifications/unsubscribe-auth/AIDDH7PTOMHR5KAMVQZS2O32W3V2JAVCNFSM6AAAAABXGVMDYOVHI2DSMVQWIX3LMV43OSLTON2WKQ3PNVWWK3TUHMZDONRUGIZDKOBQGQ&gt;
<br> &gt; . <br> &gt; You are receiving this because you are subscribed
to this thread.Message <br> &gt; ID: <br> &gt;
&lt;Dfinitski/N7DDC-ATU-100-mini-and-extended-boards/issues/122/2764225804@
<br> &gt; github.com&gt; <br> &gt; <br>
—
Reply to this email directly, view it on GitHub
<https://github.com/Dfinitski/N7DDC-ATU-100-mini-and-extended-boards/issues/122#issuecomment-2764464627>
, or unsubscribe
<https://github.com/notifications/unsubscribe-auth/BFUDMQVFNF5RLLYF5LKVEK32W6YNDAVCNFSM6AAAAABXGVMDYOVHI2DSMVQWIX3LMV43OSLTON2WKQ3PNVWWK3TUHMZDONRUGQ3DINRSG4>
.
You are receiving this because you authored the thread.Message ID:
***@***.***>

davidhay45, 2025-03-30:
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

No probs. I was going to try a known good lcd and maybe load some test firmware.
BW

KDMcMullan, 2025-06-03:
I have a suggestion: change the title of this thread to something reflecting the subject. Eg: "LDC lights up but is blank".

Thread 123 (2025-03-28):

Bargraph / Guage?

KDMcMullan, 2025-03-28:
I've not built this yet, but from what I can tell, when displaying the power, there is the number (in Watts) which changes on the screen. Would it be possible to replace this with a bar which changes size depending on the power, or a graphical needle?

Maybe the update rate of the OLED would be too slow. It was just a thought.

Dfinitski, 2025-03-28:
Hi, that is not good idea, users expect to use this as a measuring gauge with good accuracy.

KDMcMullan, 2025-04-03:
I propose it as an option, rather than an absolute alternative. Some might say that a graphical SWR is more use when trimming an antenna than a  number which changes on the screen. the digital presentation could be present at the same time.

Here's an even better idea: if the power / SWR were presented graphically as a chart against time, then the user could see the results of their trimming.

Dfinitski, 2025-04-03:
Hello.
This is not a SWR meter, this is an autotuner. Display as an option.
Also, this project is completely finished and I wont make any changes.
You can look on chinese ATU-100M with an alternative display graph.

https://www.aliexpress.us/item/3256808367951450.html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

Thread 124 (2025-04-19):

Low power readings

KC3TDR, 2025-04-19:
I purchased a fully assembled ATU-100 EXT V3.2 by N7DDC (no battery) sold by Malahit. This unit has Tune, Auto, and Byp buttons. The unit works very good for SWR and tuning, but reads 20% low on power consistently on all bands. I tested at 10W and 50W. Is there a power display calibration adjustment/procedure? Any help you can provide would be appreciated.
Thanks,
Frank KC3TDR

Dfinitski, 2025-04-19:
Hi,
No, but you can try to change the Stockton bridge diodes with original bat41.
It should work out of the box with 10% tolerance.
Also you can change a resistive decider ratio, see the schematic.

KC3TDR, 2025-04-19:
Hi,
Thanks for your feedback. Close the issue. I'll adjust components as
necessary.
Frank KC3TDR

On Sat, Apr 19, 2025 at 3:27 PM David Fainitski ***@***.***>
wrote:

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

Thread 125 (2025-04-20):

Latching relays

BitLoose, 2025-04-20:
Looking at the HK4100F-DC12V spec., it seems they draw 30mA to operate, and I wondered why a latching relay wasn't chosen for the design?

The ATU-100 is idea for portabe operations, and works really well with my QRP rig, but if the battery runs low it stops working.

Dfinitski, 2025-04-21:
Hello. Did you hear something about ATU-10 ?

BitLoose, 2025-05-06:
ATU-10, no, why?

Dfinitski, 2025-05-06:
If you operate 100W, relays power consumption is not important. Latching relays have a price, something like ldg100 would be great choice if you need them anyway.

Thread 127 (2025-05-31):

overload at 690w

hendrixgr, 2025-05-31:
Hi any guidelines of what I need to change in order to be able to measure the full 1kw?
Right to now with 800 watts in it shows overload and 690 watts.
I suspect that the two transformers of the tandem match swr bridge need more turns...

rhdpcollins, 2025-08-19:
The forward power toroid in my unit also fried, but it was due to the primary winding, i.e., the wire through the hole in the doughnut.  At 690 Watts CW, the wire heated to the point where it melted the insulation.  Then the wire arced to the board, cracked the toroid, and filled the room with smoke.

hendrixgr, 2025-08-19:
Yes that was what I meant to say, the wire did fried as in yours and it
damaged the toroid permanently without visual clues in my case.
Chris.

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

Thread 131 (2025-09-06):

After update with version 3.2 AT 100 ext will not boot.

jacksmad54, 2025-09-06:
I have tried multiple times with erasing, blank check, etc and reloading v3.2 and it will not boot.

Just to test I downloaded and updated with the YAF variant of firmware and it will boot. So I don't think it is my programmer, voltage, etc. since the YAF firmware updates and boots.

Is there a step I am missing with the version 3.2?

It doesn't have the same startup section as the YAF does when I view the hex.

Any ideas?

Thanks!
