Dfinitski/N7DDC-ATU-100-mini-and-extended-boards/ATU_100_EXT_board/Schematic_ATU-100 7x7.pdf

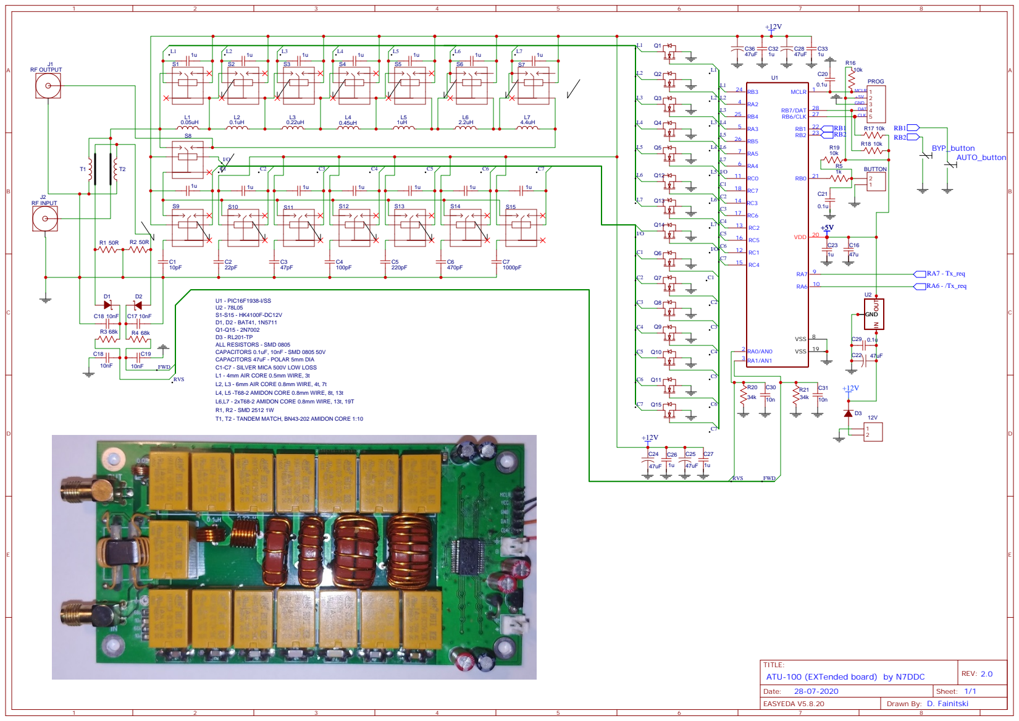
[picture p49: page 1]

TITLE:
ATU-100 (EXTended board) by N7DDC
