Dfinitski/N7DDC-ATU-100-mini-and-extended-boards/ATU_100_mini_board/Schematic_ATU-100-mini.pdf

+12V

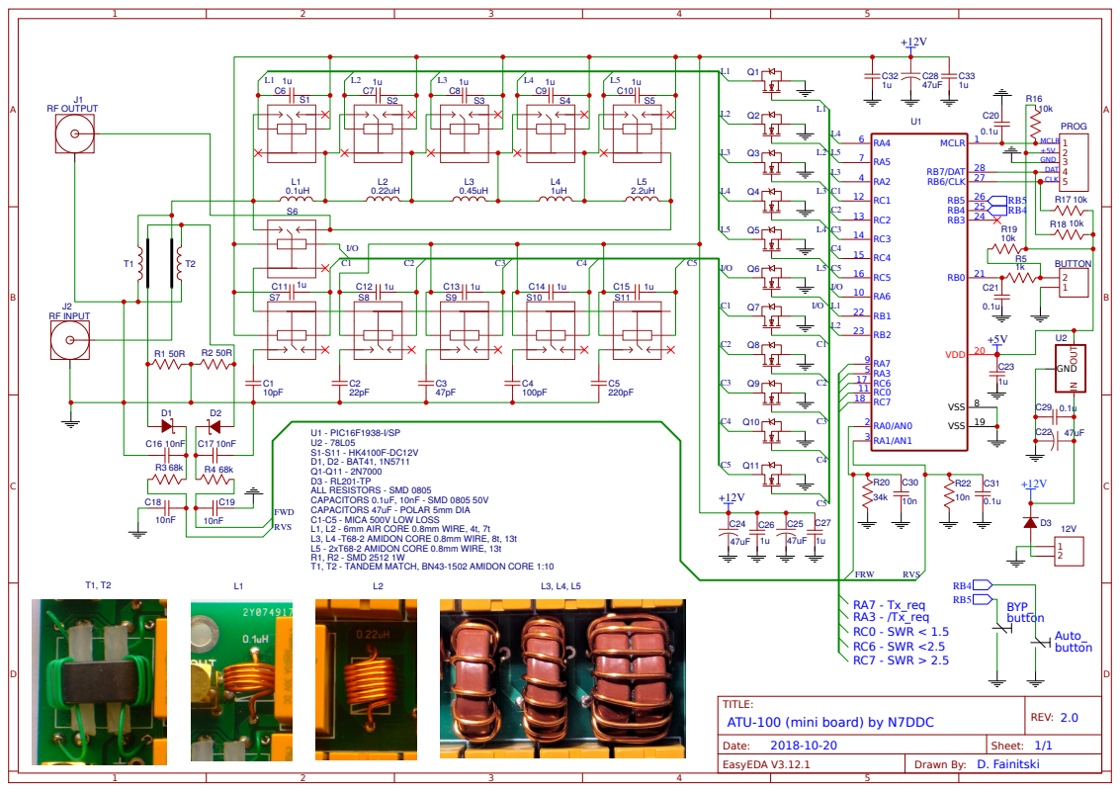
[picture p50: page 1]
