Dfinitski/N7DDC-ATU-100-mini-and-extended-boards/(list of files, drawings)

Other design files:
ATU_100_mini_board/ATU-100_mini_PCB.lay6
